AnhSinhVien/Thi-t-K-C-nh-Tay-robot-h-n-RRR/3D_slw/khau0/tsiny-gear-box-motor-1.snapshot.4/motor-preview.JPG

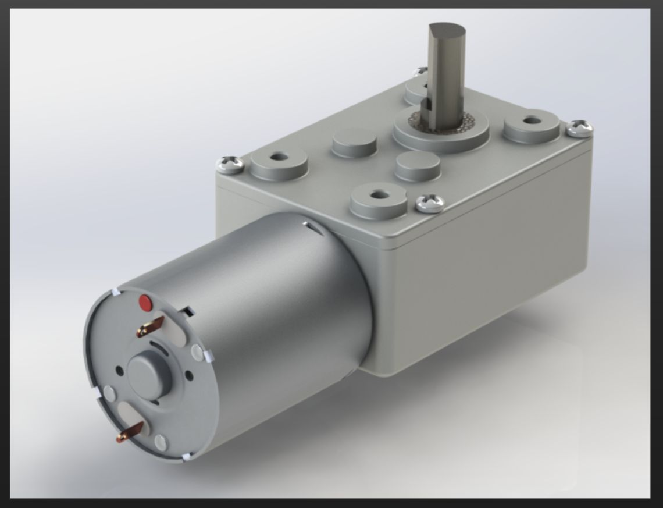
3D_slw/khau0/tsiny-gear-box-motor-1.snapshot.4/motor-preview.JPG
