AnhSinhVien/Thi-t-K-C-nh-Tay-robot-h-n-RRR/word/in_ff/word/Thuyetminh_Word.pdf

TRƯỜNG ĐẠI HỌC THỦY LỢI

### KHOA CƠ KHÍ

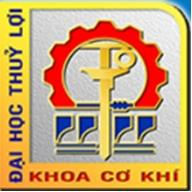
[picture p2: figure]

## ĐỒ ÁN

## HỆ THỐNG CƠ ĐIỆN TỬ

## Đề bài: Tính toán thiết kế robot hàn 3 bậc tự do

## RRR

Giáo viên hướng dẫn: Th.S Nguyễn Tiến Thịnh

Sinh viên | : Trần Khoa Điềm
Lớp | : 62CĐT04
MSV | : 2051204304

Hà Nội, năm 2024

TRƯỜNG ĐẠI HỌC THỦY LỢI

Khoa Cơ khí
Bộ môn: Kỹ thuật cơ điện tử

Học kỳ: 1
Giai đoạn: 1
Năm học: 2023-2024

ĐỀ BÀI TIỂU LUẬN: ĐỒ ÁN HỆ THỐNG CƠ ĐIỆN TỬ

Ngày…../…../ |
Trưởng bộ môn
(Ký, ghi rõ họ tên)

TS. Nguyễn Huy Thế

Người ra đề
(Ký, ghi rõ họ tên)

Th.S Nguyễn Tiến Thịnh

Mã đề:

Nhóm: |
Lớp: |

Sinh viên nhận đề:
Trần Khoa Điềm

Chữ ký:

Tên đề tài: TÍNH TOÁN THIẾT KẾ ROBOT HÀN - RRR

Yêu cầu:

✓ Mối hàn có dạng đường: Tròn
✓ Không gian vùng làm việc 500m×500m×500m ✓ Dạng robot: RRR
✓ Quỹ đạo làm việc: xE = 250 + 90.cos(t/750);
yE = 150 + 90.sin(t/750);

zE = 0;
✓ Quỹ luật biến khớp (sử dụng trong bài toán động học thuận): q1 = 0,8.cos(0,1t);

q2 = 0,5.cos(0,05t);

q3= 0,5.cos(0,05t);
✓ Yêu cầu vật liệu cho robot: Alloy Steel (SS)
✓ Yêu cầu về hệ thống dẫn động (Khâu 1): sử dụng hộp giảm tốc

Nội dung:

1. Phân tích lựa chọn cấu trúc
1.1Số bậc tự do cần thiết
1.2Phân tích một số cấu trúc thỏa mãn và lựa chọn phương án thiết kế
2. Bài toán động học
2.1Chọn một quỹ đạo mối hàn tùy ý
2.2Tính toán vận tốc, vẽ quỹ đạo chuyển động điểm thao tác

2.3Xác định quy luật chuyển động của các khâu
3. Thiết kế 3D
3.1Tạo bản vẽ lắp tổng thể của robot
3.2Tạo bản vẽ chi tiết một số khâu của robot 3.3Mô phỏng lắp ráp và chuyển động của robot
4. Bài toán động lực học
4.1Xác định các tham số động lực học
4.2Thiết lập phương trình vi phân chuyển động của robot 4.3Giải bài toán động lực học
5. Thiết kế hệ thống dẫn động
5.1Lựa chọn động cơ
5.2Phân tích lựa chọn hệ thống dẫn động cho khâu dẫn
6. Thiết kế hệ thống điều khiển
6.1Chọn luật điều khiển phù hợp
6.2Mô phỏng trên Matlab

Lời mở đầu

Có thể nói rằng Robot mang tới cho cuộc sống con người một cuộc sống mới,

một cách trải nghiệm cuộc sống và đôi khi còn là người bạn. Những hãng

Robot(RB) từ các nước nổi tiếng trên thế giới từ Đức, Nhật bản, Nga, Mỹ ngày

một khẳng định sự hiện diện của RB là phần không thiếu trong cuộc sống hiện

nay và tương lai của phía trước. Nó xuất hiện ở tất cả các lĩnh vực từ khoa học vĩ

mô cho tới vi mô và ngày một đa dạng.
Trong khuôn khổ môn học Tính toán thiết kế Robot với đề tài tài thiết kế

Robot hàn đường cong trên mặt phẳng với kích thước cho trước, nhóm tin tưởng

rằng với những kết quả có được từ việc tìm hiểu và tính toán trong bài tiểu luận

này sẽ là bước đệm quan trọng cho việc phát triển nhiều hơn nữa những ý tưởng

trong tương lai về tính toán và thiết kế các loại Robot công nghiệp.

Với bố cục gồm hai phần chính :

### 1. Tổng quan về Robot

Phần này sẽ là cái nhìn sơ qua về Robot bao gồm lịch sử phát triển, phân loại

và ứngdụng hiện nay giúp chúng ta hình dung tính quan trọng cũng như sự hữu dụng của nó tới cuộc sống.

### 2. Tính toán thiết kế Robot hàn

Bao gồm các bước thiết kế cho đến việc mô phỏng để kiểm chứng tính đúng

đắn của quá trình thiết kế sẽ cung cấp các quá trình cơ bản để có thể xác định cách

có thể một sản phẩm Robot được đưa vào ứng dụng trong cuộc sống.

Em xin gửi lời cảm ơn tới Th.S Nguyễn Tiến Thịnh, cảm ơn Thầy vì những đóng

góp qua những bài giảng và những hướng dẫn trong quá trình trao đổi ở các buổi

học. Những góp ý, sửa chữa của thầy sẽ phần nào giúp em tự tin hơn trong cách

thức tiếp cận với nền công nghiệp hiện nay bởi mặc dù đã có những sự chuẩn bị

của em hoặc cũng có thể kiến thức em mang đến trong bài tiểu luận này con sai

sót và chưa đúng. Em rất mong có được sự bổ sung, sửa chữa đó, em chân thành

cảm ơn và chúc Thầy sức khoẻ!

### LỜI CAM ĐOAN

Em xin cam đoan rằng Đồ án hệ thống cơ điện tử với đề tài “ Thiết kế Robot Hàn

kiểu R-R-R” là nghiên cứu độc lập của em với sự hỗ trợ từ giảng viên hướng dẫn

Ths.Nguyễn Tiến Thịnh.

Em xin cam đoan toàn bộ số liệu là kết quả nghiên cứu,tính toán hoàn toàn trung

thực, không sao chép từ bất kì một công trình nghiên cứu khác nào. Những tài liệu

trích dẫn đều đã được ghi rõ nguồn gốc.

Em xin chịu hoàn toàn trách nhiệm nếu có bất kỳ sự sao chép, gian dối kết quả

này trong bản báo cáo đồ án này.

### LỜI CẢM ƠN

Em xin gửi lời cảm ơn tới GV Nguyễn Tiến Thịnh và thầy cô trong bộ môn Cơ

điện tử, cảm ơn thầy cô vì những đóng góp qua những bài giảng và những hướng

dẫn trong quá trình trao đổi ở các buổi học. Những góp ý, sửa chữa của thầy cô sẽ

phần nào giúp em tự tin hơn trong cách thức tiếp cận với nền công nghiệp hiện

nay bởi mặc dù đã có những sự chuẩn bị của em hoặc cũng có thể kiến thức em

mang đến trong bài tiểu luận này còn sai sót và chưa đúng. Em rất mong có được

sự bổ sung, sửa chữa đó, chúng em chân thành

cảm ơn và chúc thầy sức khoẻ!

MỤC LỤC

DANH MỤC HÌNH ẢNH

Hình 5.1: Động Cơ DC Giảm Tốc 5840-31ZY High Torque Self-Lock DC Geared Motor.....57

1

CHƯƠNG 1: TỔNG QUÁT VỀ ROBOT

### 1.1. Lịch sử hình thành và phát triển Robot

Thuật ngữ “Robot” xuất phát từ tiếng CH Séc (Czech) “Robota” có nghĩa là công

việc tạp dịch trong vở kịch Rossum’s Universal Robots của Karel Capek, vào năm 1921. Trong vở kịch nầy, Rossum và con trai của ông ta đã chế tạo ra những chiếc

máy gần giống với con người để phục vụ con người. Có lẽ đó là một gợi ý ban

đầu cho các nhà sáng chế kỹ thuật về những cơ cấu, máy móc bắt chước các hoạt

động cơ bắp của con người.

Đầu thập kỷ 60, công ty Mỹ AMF (American Machine and Foundry Company)

quảng cáo một loại máy tự động vạn năng và gọi là “Người máy công nghiệp”

(Industrial Robot). Ngày nay người ta đặt tên người máy công nghiệp (hay robot công nghiệp) cho những loại thiết bị có dáng dấp và một vài chức năng như tay

người được điều khiển tự động để thực hiện một số thao tác sản xuất.

Về mặt kỹ thuật, những robot công nghiệp ngày nay, có nguồn gốc từ hai lĩnh vực

kỹ thuật ra đời sớm hơn đó là các cơ cấu điều khiển từ xa (Teleoperators) và các

máy công cụ điều khiển số (NC - Numerically Controlled machine tool).

Các cơ cấu điều khiển từ xa (hay các thiết bị kiểu chủ-tớ) đã phát triển mạnh trong

chiến tranh thế giới lần thứ hai nhằm nghiên cứu các vật liệu phóng xạ. Người

thao tác được tách biệt khỏi khu vực phóng xạ bởi một bức tường có một hoặc vài cửa quan sát để có thể nhìn thấy được công việc bên trong. Các cơ cấu điều khiển

từ xa thay thế cho cánh tay của người thao tác; nó gồm có một bộ kẹp ở bên trong

(tớ) và hai tay cầm ở bên ngoài (chủ). Cả hai, tay cầm và bộ kẹp, được nối với

nhau bằng một cơ cấu sáu bậc tự do để tạo ra các vị trí và hướng tuỳ ý của Tay

cầm và bộ kẹp. Cơ cấu dùng để điều khiển bộ kẹp theo chuyển động của tay cầm.

2

Vào khoảng năm 1949, các máy công cụ điều khiển số ra đời, nhằm đáp ứng yêu

cầu gia công các chi tiết trong ngành chế tạo máy bay. Những robot đầu tiên thực

chất là sự nối kết giữa các khâu cơ khí của cơ cấu điều khiển từ xa với khả năng

lập trình của máy công cụ điều khiển số.

Dưới đây chúng ta sẽ điểm qua một số thời điểm lịch sử phát triển của người máy

công nghiệp. Một trong những robot công nghiệp đầu tiên được chế tạo là robot

Versatran của công ty AMF, Mỹ. Cũng vào khoảng thời gian nầy ở Mỹ xuất hiện

loại robot Unimate ư1900 được dùng đầu tiên trong kỹ nghệ ôtô.

Tiếp theo Mỹ, các nước khác bắt đầu sản xuất robot công nghiệp: Anh 1967, Thụy

Điển và Nhật 1968 theo bản quyền của Mỹ; CHLB Đức -1971; Pháp - 1972; ở Ý

- 1973. . .

Tính năng làm việc của robot ngày càng được nâng cao, nhất là khả năng nhận

biết và xử lý. Năm 1967 ở trường Đại học tổng hợp Stanford (Mỹ) đã chế tạo ra

mẫu robot hoạt động theo mô hình “mắt-tay”, có khả năng nhận biết và định

hướng bàn kẹp theo vị trí vật kẹp nhờ các cảm biến. Năm 1974 Công ty Mỹ

Cincinnati đưa ra loại robot được điều khiển bằng máy vi tính, gọi là robot T3

(The Tomorrow Tool: Công cụ của tương lai). Robot nầy có thể nâng được vật có

khối lượng đến 40 KG.

Có thể nói, Robot là sự tổ hợp khả năng hoạt động linh hoạt của các cơ cấu điều

khiển từ xa với mức độ “tri thức” ngày càng phong phú của hệ thống điều khiển

theo chương trình số cũng như kỹ thuật chế tạo các bộ cảm biến, công nghệ lập

trình và các phát triển của trí khôn nhân tạo, hệ chuyên gia…

Trong những năm sau nầy, việc nâng cao tính năng hoạt động của robot không

ngừng phát triển. Các robot được trang bị thêm các loại cảm biến khác nhau để

nhận biết môi trường chung quanh, cùng với những thành tựu to lớn trong lĩnh

vực Tin học - Điện tử đã tạo ra các thế hệ robot với nhiều tính năng đăc biệt, số

3

lượng robot ngày càng gia tăng, giá thành ngày càng giảm. Nhờ vậy, robot công nghiệp đã có vị trí quan trọng trong các dây chuyền sản xuất hiện đại.

Một vài số liệu về số lượng robot được sản xuất ở một vài nước công nghiệp phát

triển như sau:

Nước SX | Năm 1990 | Năm 1994 | Năm 1998
Nhật | 66118 | 29756 | 67000
Mỹ | 4237 | 7634 | 11000
Đức | 5845 | 5125 | 8600
Ý | 2500 | 2408 | 4000
Pháp | 1448 | 1197 | 2000
Anh | 510 | 1086 | 1500
Hàn Quốc | 1000 | 1200

Mỹ là nước đầu tiên phát minh ra Robot nhưng nước phát triển cao nhất trong lĩnh

vực nghiên cứu chế tạo sử dụng lại là Nhật Bản.

### 1.2. Một số định nghĩa và phân loại Robot công nghiệp

### 1.2.1. Định nghĩa Robot công nghiệp

Định nghĩa theo tiêu chuẩn AFNOR (Pháp): Robot công nghiệp là một cơ cấu

chuyển động tự động có thể lập trình, lặp lại các chương trình, tổng hợp các

chương trình đặt ra trên các trục toạ độ; có khả năng định vị, định hướng, di chuyển các đối tượng vật chất: chi tiết, dao cụ, gá lắp . . . theo những hành trình

thay đổi đã chương trình hoá nhằm thực hiện các nhiệm vụ công nghệ khác nhau.

Định nghĩa theo RIA (Robot institute of America): Robot là một tay máy vạn năng có thể lặp lại các chương trình được thiết kế để di chuyển vật liệu, chi tiết, dụng

4

cụ hoặc các thiết bị chuyên dùng thông qua các chương trình chuyển động có thể

thay đổi để hoàn thành các nhiệm vụ khác nhau.

Định nghĩa theo GOCT 25686-85 (Nga):Robot công nghiệp là một máy tự động, được đặt cố định hoặc di động được, liên kết giữa một tay máy và một hệ thống

điều khiển theo chương trình, có thể lập trình lại để hoàn thành các chức năng vận

động và điều khiển trong quá trình sản xuất.

Có thể nói Robot công nghiệp là một máy tự động linh hoạt thay thế từng phần

hoặc toàn bộ các hoạt động cơ bắp và hoạt động trí tuệ của con người trong nhiều

khả năng thích nghi khác nhau.

Robot công nghiệp có khả năng chương trình hoá linh hoạt trên nhiều trục chuyển

động, biểu thị cho số bậc tự do của chúng. Robot công nghiệp được trang bị những

bàn tay máy hoặc các cơ cấu chấp hành, giải quyết những nhiệm vụ xác định trong

các quá trình công nghệ : hoặc trực tiếp tham gia thực hiện các nguyên công (sơn,

hàn, phun phủ, rót kim loại vào khuôn đúc, lắp ráp máy . . .) hoặc phục vụ các quá

trình công nghệ (tháo lắp chi tiết gia công, dao cụ, đồ gá . . .) với những thao tác

cầm nắm, vận chuyển và trao đổi các đối tượng với các trạm công nghệ, trong một

hệ thống máy tự động linh hoạt, được gọi là “Hệ thống tự động linh hoạt robot

hoá” cho phép thích ứng nhanh và thao tác đơn giản khi nhiệm vụ sản xuất thay

đổi.

### 1.2.2. Các thành phần chính của Robot công nghiệp

Một robot công nghiệp thường bao gồm các thành phần chính như : cánh tay robot,

nguồn động lực, dụng cụ gắn lên khâu chấp hành cuối, các cảm biến, bộ điều

khiển, thiết bị dạy học, máy tính ... các phần mềm lập trình cũng nên được coi là

một thành phần của hệ thống robot.

Cánh tay robot (tay máy) là kết cấu cơ khí gồm các khâu liên kết với nhau bằng

các khớp động để có thể tạo nên những chuyển động cơ bản của robot.

5

Nguồn động lực là các động cơ điện (một chiều hoặc động cơ bước), các hệ thống

xy lanh khí nén, thuỷ lực để tạo động lực cho tay máy hoạt động.

Dụng cụ thao tác được gắn trên khâu cuối của robot, dụng cụ của robot có thể có

nhiều kiểu khác nhau như: dạng bàn tay để nắm bắt đối tượng hoặc các công cụ

làm việc như mỏ hàn, đá mài, đầu phun sơn...

Thiết bị dạy-hoc (Teach-Pendant) dùng để dạy cho robot các thao tác cần thiết

theo yêu cầu của quá trình làm việc, sau đó robot tự lặp lại các động tác đã được

dạy để làm việc (phương pháp lập trình kiểu dạy học).

Các phần mềm để lập trình và các chương trình điều khiển robot được cài đặt trên

máy tính, dùng điều khiển robot thông qua bộ điều khiển (Controller). Bộ điều

khiển còn được gọi là Mođun điều khiển (hay Unit, Driver), nó thường được kết

nối với máy tính. Một mođun điều khiển có thể còn có các cổng Vào - Ra (I/O

port) để làm việc với nhiều thiết bị khác nhau như các cảm biến giúp robot nhận

biết trạng thái của bản thân, xác định vị trí của đối tượng làm việc hoặc các dò tìm

khác; điều khiển các băng tải hoặc cơ cấu cấp phôi hoạt động phối hợp với robot...

### 1.2.3. Kết cấu của tay máy

Như đã nói trên, tay máy là thành phần quan trọng, nó quyết định khả năng làm

việc của robot. Các kết cấu của nhiều tay máy được phỏng theo cấu tạo và chức

năng của tay người; tuy nhiên ngày nay, tay máy được thiết kế rất đa dạng, nhiều

cánh tay robot có hình dáng rất khác xa cánh tay người. Trong thiết kế và sử dụng

tay máy, chúng ta cần quan tâm đến các thông số hình - động học, là những thông

số liên quan đến khả năng làm việc của robot như: tầm với (hay trường công tác),

số bậc tự do (thể hiện sự khéo léo linh hoạt của robot), độ cứng vững, tải trọng

vật nâng, lực kẹp . . .

Các khâu của robot thường thực hiện hai chuyển động cơ bản:

6

- Chuyển động tịnh tiến theo hướng x, y, z trong không gian.
- Chuyển động xoay theo các trục x, y, z trong không gian.

### 1.2.4. Phân loại Robot công nghiệp

Robot công nghiệp rất phong phú đa dạng, có thể được phân loại theo các cách

sau:

### 1.2.4.1. Phân loại theo kết cấu

Theo kết cấu của tay máy người ta phân thành robot kiểu toạ độ Đề các, Kiểu toạ

độ trụ, kiểu toạ độ cầu, kiểu toạ độ góc, robot kiểu SCARA như đã trình bày ở

trên.

### 1.2.4.2. Phân loại theo hệ thống truyền động

Có các dạng truyền động phổ biến là:

- Hệ truyền động điện: Thường dùng các động cơ điện 1 chiều (DC: Direct

Current) hoặc các động cơ bước (step motor). Loại truyền động nầy dễ điều khiển,

kết cấu gọn.

- Hệ truyền động thuỷ lực: có thể đạt được công suất cao, đáp ứng những điều

kiện làm việc nặng. Tuy nhiên hệ thống thuỷ lực thường có kết cấu cồng kềnh,

tồn tại độ phi tuyến lớn khó xử lý khi điều khiển.

- Hệ truyền động khí nén: có kết cấu gọn nhẹ hơn do không cần dẫn ngược nhưng

lại phải gắn liền với trung tâm tạo ra khí nén. Hệ nầy làm việc với công suất trung

bình và nhỏ, kém chính xác, thường chỉ thích hợp với các robot hoạt động theo chương trình định sẳn với các thao tác đơn giản “nhấc lên - đặt xuống” (Pick and

Place or PTP: Point To Point).

### 1.2.4.3. Phân loại theo ứng dụng

7

Dựa vào ứng dụng của robot trong sản xuất có Robot sơn, robot hàn, robot lắp

ráp, robot chuyển phôi .v.v...

### 1.2.4.4. Phân loại theo cách thức và đặc trưng của phương pháp điều khiển

Robot điều khiển kín (hay điều khiển servo): sử dụng cảm biến, mạch phản hồi để

tăng độ chính xác và mức độ linh hoạt khi điều khiển.

### 1.3. Robot Hàn mục đích ra đời và ứng dụng

Trên toàn thế giới hiện nay, sự phát triển và ứng dụng của robot hàn đang trở

thành một xu hướng quan trọng trong ngành công nghiệp sản xuất và xây dựng.

Robot hàn không chỉ giúp nâng cao chất lượng sản phẩm mà còn tăng cường hiệu

suất làm việc và giảm rủi ro cho người lao động.

Một trong những lợi ích lớn nhất của robot hàn là khả năng làm việc liên tục mà

không mệt mỏi, giúp tăng cường năng suất và giảm thời gian sản xuất. Nhờ vào

công nghệ hiện đại, robot hàn cũng có khả năng hàn các sản phẩm có độ phức tạp

cao, từ các chi tiết nhỏ đến cấu trúc lớn và phức tạp. Điều này giúp nâng cao độ

chính xác và đồng đều của quá trình hàn, đồng thời giảm thiểu sai số và waste.

Sự phổ biến của robot hàn không chỉ giới hạn trong các nhà máy sản xuất, mà còn

mở rộng đến nhiều lĩnh vực khác nhau như xây dựng cầu và tòa nhà, sản xuất ô

tô, đóng tàu, và nhiều ngành công nghiệp khác. Các doanh nghiệp đang nhận ra

rằng việc tích hợp robot hàn vào quy trình sản xuất của họ không chỉ mang lại lợi

ích kinh tế mà còn là bước quan trọng để nâng cao chất lượng sản phẩm và duy

trì sự cạnh tranh trên thị trường toàn cầu.

Tính linh hoạt và dễ điều khiển của robot hàn cũng đang được cải tiến, giúp chúng

dễ dàng thích ứng với các quy trình sản xuất linh hoạt và đa dạng. Điều này đồng

nghĩa với việc ngành công nghiệp có thể áp dụng robot hàn trong các ứng dụng

và môi trường làm việc khác nhau một cách hiệu quả.

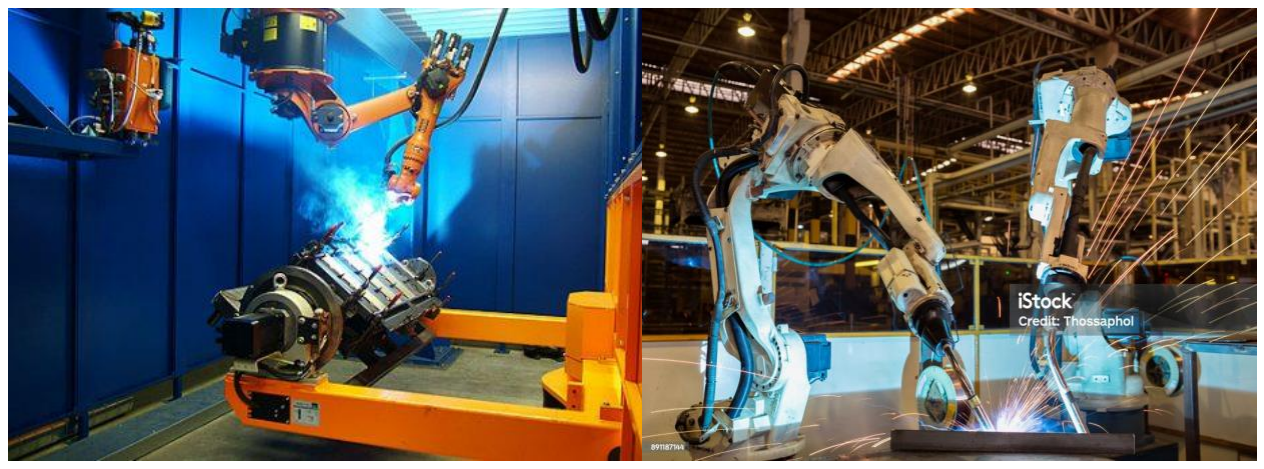
[picture p3: figure]

8

Tóm lại, sự phát triển và ứng dụng ngày càng phổ biến của robot hàn đánh dấu

một bước tiến quan trọng trong ngành công nghiệp, góp phần làm thay đổi cách

chúng ta sản xuất và xây dựng, đồng thời mở ra những triển vọng mới về tương

lai của công nghiệp và sự phát triển bền vững.

Hình 1.1: Một số mẫu robot hàn trong công nghiệp

### 1.4. Lựa chọn phương án thiết kế

### 1.4.1. Nội dung nghiên cơ khí

Phân tích không gian, sơ bộ thao tác làm việc của robot:

+ Không gian làm việc: 500x500x500

+ Sơ bộ hướng thao tác: RRR

Đề bài yêu cầu tính toán thiết kế Robot hàn đảm bảo thực hiện thao tác theo quỹ

đạo là đường trong với 3 bậc tự do cho mô hình thiết kế

- Tính toán, thiết kế robot có kết cấu, hình dạng phù hợp với yêu cầu linh hoạt về

công việc đặt ra;

- Hệ thống cơ khí, truyền động chính xác, gia công phải đảm bảo độ chuẩn theo

yêu cầu kích thước bản vẽ. Đảm bảo cho robot chạy ổn định, đúng yêu cầu kĩ

thuật;

9

- Các khâu đảm bảo không gian làm việc ổn định, tự do, không va chạm, đảm bảo

gắp phôi được ở vị trí mong muốn.

### 1.4.2. Phân tích và lựa chọn cấu trúc robot

### 1.4.2.1. Số bậc tự do cần thiết

Đề bài yêu cầu tính toán thiết kế Robot hàn đảm bảo thực hiện mối hàn có dạng

quỹ đạo đường tròn với không gian hoạt động trong khoảng: 500x500x500 mm và kiểu robot là RRR thì ta sẽ cần ít nhất robot phải có 3 bậc tự do cho mô hình

thiết kế

### 1.4.2.2. Phân tích cấu trúc

Robot kiểu RRR (còn được gọi là robot 3 bậc tự do RRR) là một loại robot công nghiệp

hoặc robot cầm tay có cấu trúc đặc thù với ba bậc tự do (degrees of freedom - DOF)

hoặc ba joint. Mỗi bậc tự do cho phép robot thực hiện một phép xoay hoặc gập cơ bản

ở một gelenk hoặc joint nhất định.

Cấu trúc cơ bản của robot RRR:

- Base: Đây là phần cố định của robot, thường đặt trên bàn làm việc hoặc một nền

tảng cố định khác.

- Bậc tự do thứ nhất (Joint 1 - R1): Đây là khớp đầu tiên của robot, thường là

một khớp xoay hoặc một khớp xoay trục chéo, cho phép robot thực hiện một phép

xoay quanh trục. Góc quay tại khớp này thường được ký hiệu là θ1.

- Bậc tự do thứ hai (Joint 2 - R2): Đây là khớp thứ hai của robot, thường là một

khớp xoay hoặc một khớp xoay trục chéo, cho phép robot thực hiện một phép

xoay quanh trục khác. Góc quay tại khớp này thường được ký hiệu là θ2.

- Bậc tự do thứ ba (Joint 3 - R3): Đây là khớp thứ ba của robot, thường là một

khớp xoay hoặc một khớp xoay trục chéo, cho phép robot thực hiện một phép xoay cuối cùng quanh trục khác nữa. Góc quay tại khớp này thường được ký hiệu

là θ3.

10

- End-Effector (tác nhân cuối cùng): Đây là phần của robot được gắn vào khớp

thứ ba (Joint 3) và thường chứa công cụ hoặc tác nhân được sử dụng để thực hiện

các nhiệm vụ cụ thể. Tại vị trí này ta dùng để lắp công cụ hàn.

- Tay điều khiển: Để điều khiển robot kiểu RRR, người dùng thường sử dụng một

tay điều khiển hoặc giao diện máy tính để cài đặt các góc quay của các joint (θ1,

θ2, θ3) để đưa robot đến vị trí và hướng mong muốn.

Cấu trúc này cho phép robot kiểu RRR di chuyển và thực hiện các tác vụ trong không

gian ba chiều bằng cách điều khiển ba bậc tự do.

Ưu điểm của robot RRR so với các robot khác là:

- Dễ dàng thực hiện với nhiều đối tượng bề mặt
- Xây dựng hệ thống điều khiển các khớp dễ dàng thuận tiện và gần như có

thể độc lập

- Kết cấu đơn giản đảm bảo tính linh hoạt
- Khả năng làm việc trong không gian hạn chế

### 1.4.3. Một số mẫu thiết kế robot trên thị trường

### 1.4.3.1. Robot có khớp nối

11

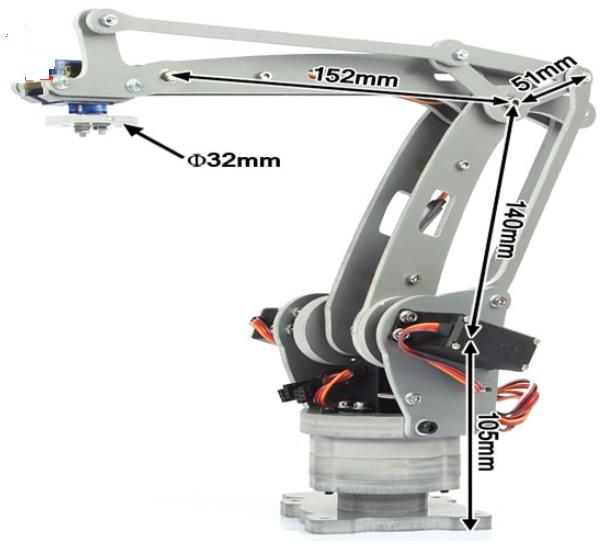
[picture p4: figure]

Hình 1.2: Robot có khớp nối Cánh tay Robot có khớp nối là loại robot vô cùng phổ biến. Và mỗi khi nhắc

đến Robot chúng ta sẽ lập tức nghĩ ngay đến chúng. Giống như các nhà máy CNC,

Robot khớp nối được phân loại theo số điểm quay hoặc số trục mà chúng có. Phổ

biến nhất là robot khớp 3 trục. Ngoài ra còn có các loại robot 6 trục và 7 trục cũng

rất phổ biến trên thị trường.

Tính linh hoạt, khéo léo và khả năng tiếp cận khiến Robot có khớp nối là sự

lựa chọn phù hợp lý tưởng cho các nhiệm vụ thực hiện trên các mặt phẳng không

song song, chẳng hạn như chỉnh sửa máy móc.

Robot có khớp nối cũng có thể dễ dàng tiếp cận khoang máy công cụ và dưới

các vật cản để tiếp cận phôi. Hoặc thậm chí xung quanh vật cản, trong trường hợp

này là robot 7 trục.
Ưu điểm:
- Các khớp nối kín và ống bảo vệ cho phép Robot có khớp nối hoạt động

tốt trong môi trường sạch cũng như môi trường bẩn. Khả năng năng lắp

cánh tay Robot 3 bậc tự do này trên bất kỳ bề mặt nào (ví dụ: trần nhà,

đường ray trượt). Điều này cho phép doanh nghiệp có nhiều sự lựa chọn

khi làm việc.

12

- Tuy nhiên, sự tinh tế và hiện đại của robot có khớp nối này sẽ đi kèm

với giá thành cao. Do đó, robot này cao hơn so với các loại robot có

trọng tải tương tự trên thị trường.
Khuyết điểm:

Và khuyết điểm của dòng Robot này là: Chúng sẽ không phù hợp với các ứng

dụng tốc độ rất cao. Do chúng có hệ thống chuyển động học phức tạp với nhiều

chi tiết bộ phận.

### 1.4.3.2. Robot SCARA

Cánh tay robot khớp nối tuân thủ có chọn lọc (SCARA) là một lựa chọn tốt. Và hiệu

quả về chi phí cho doanh nghiệp.

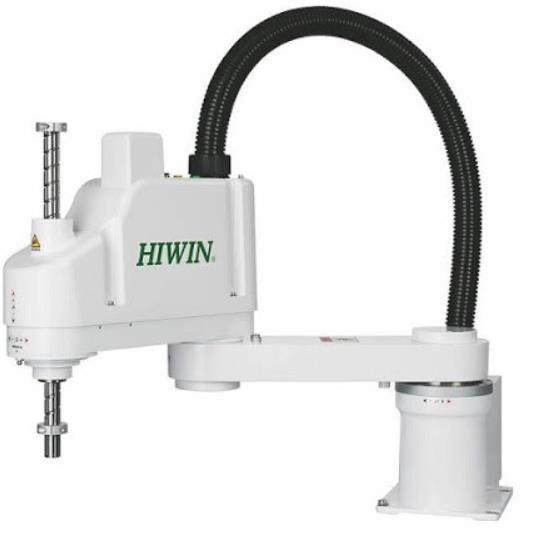
[picture p5: figure]

Hình 1.3: Robot SCARA
Robot SCARA này sẽ phù hợp với việc thực hiện các hoạt động giữa hai mặt phẳng song song (ví dụ: chuyển các bộ phận từ khay sang băng tải). Robot

SCARA có tính vượt trội trong các nhiệm vụ lắp ráp theo chiều dọc như chèn các

chốt mà không cần ràng buộc do độ cứng dọc của chúng.

Robot SCARA có trọng lượng nhẹ và có dấu chân nhỏ. Điều này là sự lựa chọn

lý tưởng cho các công việc mà thực hiện trong không gian đông đúc. Chúng cũng có chu kỳ làm việc rất nhanh.

13

Do thiết kế cánh tay xoay cố định, vốn là một lợi thế trong một số ứng dụng

nhất định. Nhưng Robot SCARA phải đối mặt với những hạn chế khi thực hiện

các nhiệm vụ yêu cầu tiếp cận các vật thể bên trong sản phẩm và làm việc như là:

đồ đạc, đồ gá hoặc máy công cụ trong ô làm việc.

### 1.4.3.3. Robot Delta

Robot Delta, còn được gọi là “robot nhện”. Robot này sử dụng ba động cơ gắn

trên đế để kích hoạt các cánh tay điều khiển định vị cổ tay. Robot delta cơ bản là

các đơn vị 3 trục. Nhưng các mô hình 4 trục và 6 trục của nó cũng phổ biến không

kém.

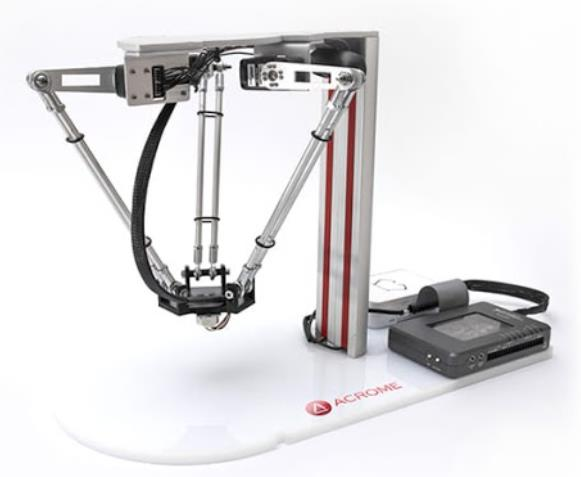
[picture p6: figure]

Hình 1.4: Robot Delta
Bằng cách gắn các thiết bị truyền động vào hoặc rất gần đế cố định thay vì ở

mỗi khớp (như trong trường hợp Robot có khớp nối). Cánh tay của rô bốt delta có

thể rất nhẹ. Điều này cho phép di chuyển nhanh chóng. Và làm cho Robot delta

trở thành Robot lý tưởng các hoạt động yêu cầu tốc độ rất cao.

Một điều quan trọng cần lưu ý khi bạn so sánh Robot Delta với các loại rô bốt

khác:
Phạm vi tiếp cận đối với Robot Delta thường được xác định bằng đường kính

của phạm vi làm việc. Trái ngược với bán kính từ chân đế, như trong trường hợp

đơn vị SCARA và khớp nối. Ví dụ: một Robot Delta có phạm vi tiếp cận 40” sẽ

14

chỉ bằng một nửa phạm vi tiếp cận (20” trên bán kính) của đơn vị SCARA hoặc

có khớp nối 40 ”.

Ngoài ra, em còn tìm hiểu một số dạng cơ cấu robot dưới đây:

- Phương án 1:

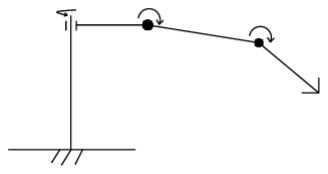
[picture p7: figure]

Hình 1.5: Dạng cơ cấu robot thứ 1

Phương án này có 3 bậc tự do, trong đó khâu 1, khâu 2 và khâu 3 chuyển

động quay. Phương án này đã thỏa mãn với yêu cầu nhưng các khâu của robot sẽ

không được chắc khỏe do khớp 1 phải chịu lực lớn

- Phương án 2:

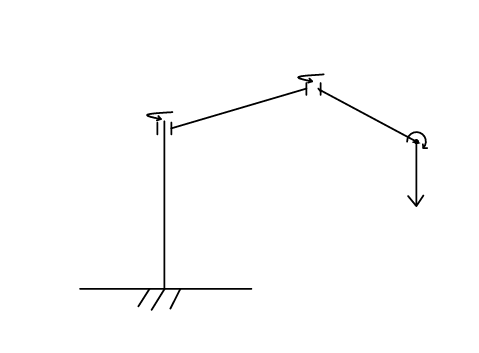
[picture p8: figure]

Hình 1.6: Dạng cơ cấu robot thứ 2

15

Phương án này có 3 bậc tự do, trong đó khâu 1, khâu 2 và khâu 3 chuyển

động quay. Phương án này đã thỏa mãn với yêu cầu nhưng bị hạn chế giống

phương án 1

- Phương án 3:

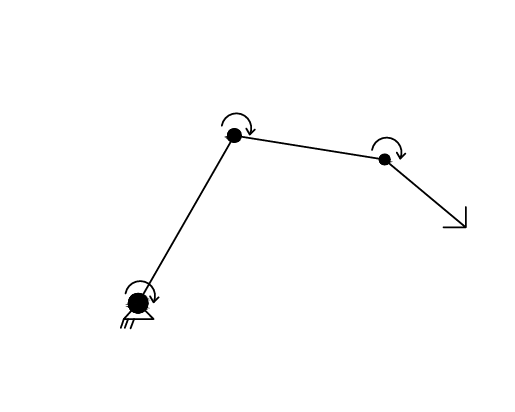
[picture p9: figure]

Hình 1.7: Dạng cơ cấu robot thứ 3

Phương án này có 3 bậc tự do, trong đó khâu 1, khâu 2 và khâu 3 chuyển

động quay. Phương án này bị hạn chế không gian làm việc.

- Phương án 4:

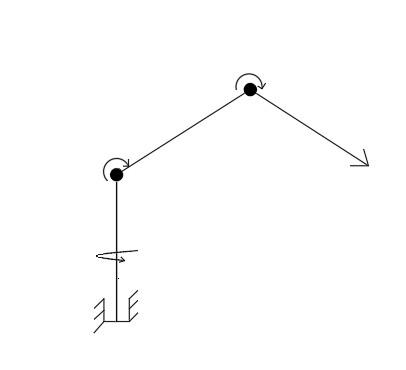
[picture p10: figure]

Hình 1.8: Dạng cơ cấu robot thứ 4

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

động quay. Phương án này đã thỏa mãn yêu cầu chế tạo đơn giản hơn các phương

án trên

16

Dựa vào những đặc điểm của 3 loại robot thông dụng trên nói chung và của loại

robot khớp nối 3 bậc tự do nói riêng, yêu cầu về kỹ thuật của đề bài được giao và

giá thành phù hợp với sinh viên, em lựa chọn sử dụng dạng robot theo phương án số 4

### 1.4.4. Phương án thiết kế robot

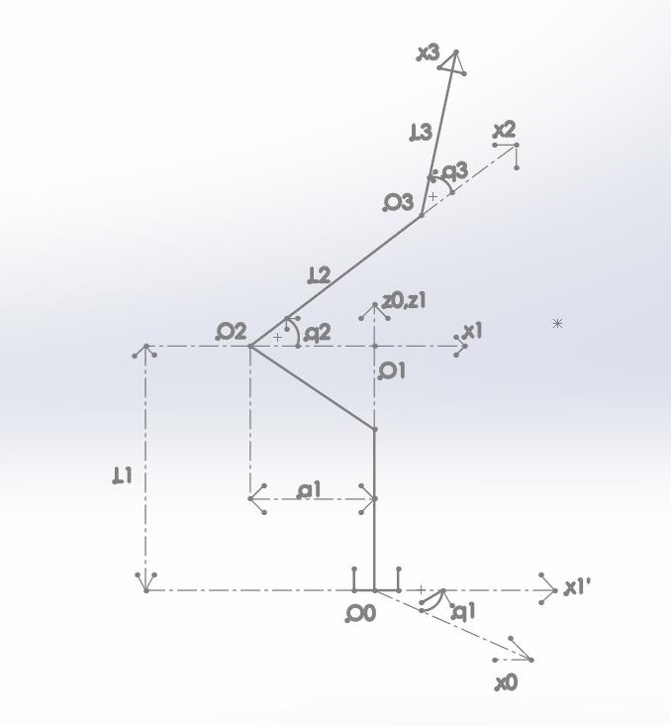
[picture p11: figure]

Hình 1.9: Cấu trúc và thiết lập hệ tọa độ gắn lên robot

Hệ trục: | X0Y0Z0 ∶ là hệ trục ban đầu
| X1Y1Z1 ∶ là hệ trục của khâu 1 theo q1
| X2Y2Z2 ∶ là hệ trục của khâu 2 theo q2
| X3Y3Z3 ∶ là hệ trục của khâu 3 theo q3

17

CHƯƠNG 2: BÀI TOÁN ĐỘNG HỌC ROBOT

Với không gian làm việc là 500x500x500(mm) . Chọn:
- l1= 250 mm = 0,25 m
- l2 = 194 mm = 0,194 m
- l3 = 265 mm = 0,265 m
- a1 = 30 mm = 0,03 m

### 2.1. CƠ SỞ LÝ THUYẾT

### 2.1.1. Bậc tự do của Robot

Bậc tự do là số khả năng chuyển động của một cơ cấu (chuyển động quay hoặc

tịnh tiến). Để dịch chuyển được một vật thể trong không gian, cơ cấu chấp hành

của robot phải đạt được một số bậc tự do. Nói chung cơ hệ của robot là một cơ

cấu hở, do đó bậc tự do của nó có thể tính theo công thức:

w = 6n − ∑ ipi

5
i=1 | = 6.3 – 5.3 = 3 (bậc tự do) | (2.1)

Ở đây:

n - Số khâu động;

pi - Số khớp loại i (i = 1, 2,...,5 : Số bậc tự do bị hạn chế). Đối với các cơ cấu có

các khâu được nối với nhau bằng khớp quay hoặc tịnh tiến (khớp động loại 5) thì

số bậc tự do bằng với số khâu động... Đối với cơ cấu hở, số bậc tự do bằng tổng

số bậc tự do của các khớp động.

Để định vị và định hướng khâu chấp hành cuối một cách tuỳ ý trong không gian

3 chiều robot cần có 6 bậc tự do, trong đó 3 bậc tự do để định vị và 3 bậc tự do để

định hướng. Một số công việc đơn giản nâng hạ, sắp xếp... có thể yêu cầu số bậc

tự do ít hơn. Các robot hàn, sơn... thường yêu cầu 6 bậc tự do. Trong một số trường

hợp cần sự khéo léo, linh hoạt hoặc khi cần phải tối ưu hoá quỹ đạo... người ta

dùng robot với số bậc tự do lớn hơn 6.

18

### 2.1.2. Hệ tọa độ (Coordinate frames)

Mỗi robot thường bao gồm nhiều khâu (links) liên kết với nhau qua các khớp

(joints), tạo thành một xích động học xuất phát từ một khâu cơ bản (base) đứng

yên. Hệ toạ độ gắn với khâu cơ bản gọi là hệ toạ độ cơ bản (hay hệ toạ độ chuẩn).

Các hệ toạ độ trung gian khác gắn với các khâu động gọi là hệ toạ độ suy rộng.

Trong từng thời điểm hoạt động, các toạ độ suy rộng xác định cấu hình của robot

bằng các chuyển dịch dài hoặc các chuyển dịch góc của các khớp tịnh tiến hoặc

khớp quay. Các toạ độ suy rộng còn được gọi là biến khớp.

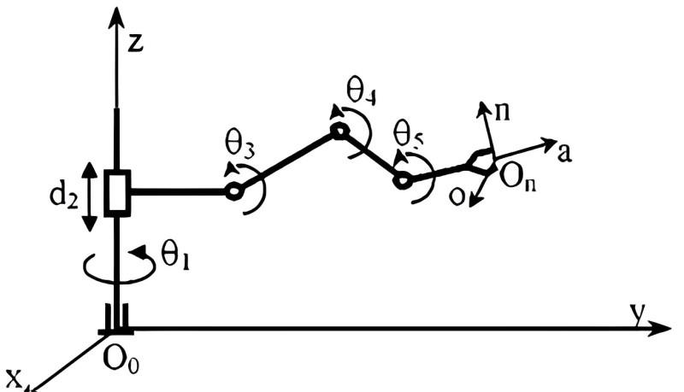
[picture p12: figure]

Hinh 2.1: Hệ tọa độ suy rộng của robot

Các hệ toạ độ gắn trên các khâu của robot phải tuân theo qui tắc bàn tay phải:

Dùng tay phải, nắm hai ngón tay út và áp út vào lòng bàn tay, xoè 3 ngón : cái,

trỏ và giữa theo 3 phương vuông góc nhau, nếu chọn ngón cái là phương và chiều

của trục z, thì ngón trỏ chỉ phương, chiều của trục x và ngón giữa sẽ biểu thị

phương, chiều của trục y.

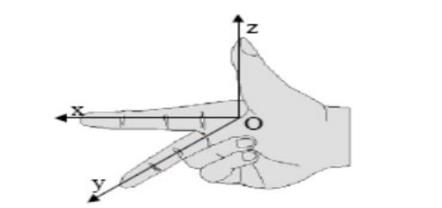
[picture p13: figure]

Hình 2.2: quy tắc bàn tay phải

19

Trong robot ta thường dùng chữ O và chỉ số n để chỉ hệ toạ độ gắn trên khâu thứ

n. Như vậy hệ toạ độ cơ bản (Hệ toạ độ gắn với khâu cố định) sẽ được ký hiệu là

O0; hệ toạ độ gắn trên các khâu trung gian tương ứng sẽ là O1, O2,..., On-1, Hệ

toạ độ gắn trên khâu chấp hành cuối ký hiệu là On.

### 2.1.3. Cách xây dựng hệ tọa độ và cách xác định các tham số trong phương pháp D-

H-C

Cách xây dựng hệ tọa độ D-H-C:

- Trục zi được chọn dọc theo trục của khớp thứ (i).
- Trục xi được xác định theo đường vuông góc chung giữa trục zi và zi+1,

hướng từ zi tới zi+1

- Gốc Oi là giao điểm của xi và zi
- Trục yi được xác định theo quy tắc bàn tay phải.

Các tham số trong pp D-H-C:

Vị trí của hệ tọa độ khớp (Oxyz)i đối với hệ tọa độ khớp (Oxyz)i−1 được xác định

bởi 4 tham số, αi−1 , ai−1 ,θi , di như sau:

- αi−1: Góc quay quanh trục xi sao cho trục z′ i−1 (z′ i−1// zi−1 ) trùng với

trục zi .

- ai−1: Dịch chuyển dọc trục xi để điểm O′ i chuyển đến điểm Oi .
- θi : Góc quay quanh trục zi−1 để trục xi−1 trùng với trục x′ i (xi//x′ i )
- di: Dịch chuyển tịnh tiến dọc trục zi−1 để gốc tọa độ Oi−1 chuyể đến O′ i

là giao điểm của trục xi và trục zi−1

Từ quy tắc trên ta xây dựng các tọa độ khảo sát (Hình 1.5):

- Hệ tọa độ O0x0y0z0:

20

Gốc tọa độ đặt tại tâm của khớp động thứ nhất

Trục O0z0 dọc theo hướng của trục khớp động thứ nhất

Trục O0x0 có phương vuông góc với z0

Trục O0y0 xác định theo quy tắc bàn tay phải

- Hệ tọa độ O1x1y1z1:

Gốc tọa độ đặt tại vị trí như trên hình dọc phương của khâu 1

Trục O1z1 có phương trùng với O0z0 như hình vẽ.

Trục O1x1 có phương nằm trên đường vuông góc chung của trục O1z1 và O2z2.

Trục O1y1 xác định theo quy tắc bàn tay phải.

- Hệ tọa độ O2x2y2z2:

Gốc tọa độ đặt tại tâm của khớp động thứ 2.

Trục O2z2 có phương dọc theo trục khớp động xoay thứ 2 của khớp xoay.

Trục O2x2 có phương nằm trên đường vuông góc chung của trục O2z2 và O3z3 .

Trục O2y2 xác định theo quy tắc bàn tay phải.

- Hệ tọa độ O3x3y3z3:

Gốc tọa độ đặt tại tâm của khớp động thứ 3.

Trục O3z3 có phương dọc theo trục khớp động xoay thứ 3 của khớp xoay.

Trục O3x3 có phương nằm dọc khâu 3.

Trục O3y3 xác định theo quy tắc bàn tay phải.

Cuối cùng ta có hệ tọa độ như sau:

21

Hình 2.3: Dạng robot chọn và cách đặt biến khớp

### 2.2. BÀI TOÁN ĐỘNG HỌC THUẬN ROBOT

### 2.2.1. Bảng tham số động học và tính toán các ma trận truyền Denavit –

Hartenberg – Craig

- Đề bài cho quy luật chuyển động của các khâu:

q1 = 0.8 ∗ cos(0.1t)
q2 = 0.5 ∗ cos(0.05t) (2.2)

q3 = 0.5 ∗ cos(0.05t)

Dựa trên thông số hình 2.2 ta lập bảng tham số động học

22

Khâu | αi−1 | ai-1 | di | θi
1 | 0 | 0 | l1 | q1
2 | π/2 | -a1 | 0 | q2
3 | 0 | l2 | 0 | q3

Trong đó :q1, q2, q3 là các biến khớp ; l1, l2, l3, a1 là chiều dài khâu 1,2,3

Các ma trận Craig địa phương
K1 = [

cos q1 − sin q1 0 0
sin q1 | cos q1 | 0 0
0 | 0 | 1 l1
0 | 0 | 0 1
]; | K2 = [
cos q2 − sin q2 | 0 | −a1
0 | 0 | −1 | 0
sin q2 | cos q2 | 0 | 0
0 | 0 | 0 | 1

]

K3 = [

cos q3 −sin q3 0 l2
sin q3 | cos q3 | 0 0
0 | 0 | 1 0
0 | 0 | 0 1

]

Các ma trận Craig toàn thể:

C2 = K1K2 = [

cos q1 cos q2 − cos q1 sin q2 | sin q1 | −a1. cosq1
sin q1 cos q2 − sin q1 sin q2 − cos q1 −a1. sinq1
sin q2 | cos q2 | 0 | l1
0 | 0 | 0 | 1

]

C3 = K1K2K3 =
[
cos q1 cos( q2 + q3) − cos q1 sin( q2 + q3) | sin q1 | −cosq1(a1 − l2cosq2)
sin q1 cos( q2 + q3) − sin q1 sin( q2 + q3) − cos q1 −sinq1(a1 − l2cosq2)
sin( q2 + q3) | cos( q2 + q3) | 0 | l1 + l2sinq2
0 | 0 | 0 | 1

]

### 2.2.2. Tính tọa độ điểm thao tác

Từ các ma trận Craig, ta tính tọa độ điểm thao tác E trong hệ quy chiếu cố định:

uE

(3) = [l3 0 0 1]
T

Tọa độ vị trí điểm thao tác E:

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
= C3. [

l3
0

0/1] = [

l3 cos q1 cos( q2 + q3) − cos q1(a1 − l2cos q2) l3 sin q1 cos( q2 + q3) − sin q1 (a1 − l2cos q2) l1 + l2sinq2 + l3 sin( q2 + q3) 1

]

⇒ {
xE

0 = l3 cos q1 cos( q2 + q3) − cos q1(a1 − l2cos q2) yE

0 = l3 sin q1 cos( q2 + q3) − sin q1 (a1 − l2cos q2) zE

0 = l1 + l2sinq2 + l3 sin( q2 + q3)

(2.3)

*Vẽ đồ thị quỹ đạo:

- Thay q1, q2, q3 từ (2.2) vào toạ độ điểm E theo biến t:

xE

0 = l3*cos(cos(0.05*t)) *cos(0.8*cos(0.1*t)) - cos(0.8*cos(0.1*t))*(a1 -l2*cos(0.5*cos(0.05*t)))

yE

0 = l3*cos(cos(0.05*t)).sin(0.8*cos(0.1*t)) - sin(0.8*cos(0.1*t)) * (a1 -l2*cos(0.5*cos(0.05*t)))

zE

0 = l1 + l3*sin(cos(0.05*t)) + l2*sin(0.5*cos(0.05*t))

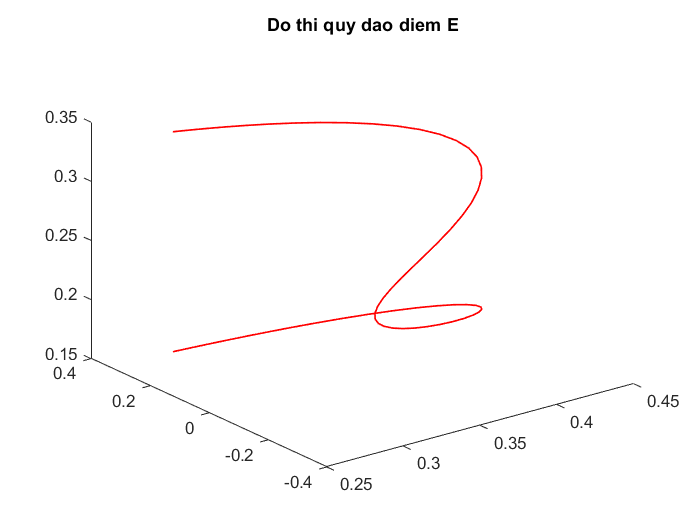
[picture p14: figure]

Hình 2.4: Đồ thị quỹ đạo của điểm E trong 1 chu kì

24

### 2.2.3. Vận tốc điểm tác động cuối E và vận tốc góc của các khâu

### 2.2.3.1. Vận tốc của điểm tác động cuối E

Đạo hàm theo thời gian t toạ độ điểm E trong hệ quy chiếu cố định ta được vận

tốc điểm thao tác E

vE = [ẋE ẏ
E

żE]

T

Thay q1, q2, q3 từ (2.2) vào ta có:

VEx = 0.2e-1*l2*sin(0.5*cos(0.5e-1*t))*sin(0.5e-1*t)*cos(0.8*cos(0.1*t)) -0.8e-1*sin(0.8*cos(0.1*t))*sin(0.1*t)*(a1-l2*cos(0.5*cos(0.5e-1*t)))+ 0.8e-1*l3*sin(0.8*cos(0.1*t))*sin(0.1*t)*cos(cos(0.5e-1*t))+0.5e-1*l3*sin(0.5e-1*t)*sin(cos(0.5e-1*t))*cos(0.8*cos(0.1*t))

VEy = 0.8e-1*sin(0.1*t)*cos(0.8*cos(0.1*t))*(a1-l2*cos(0.5*cos(0.5e-1*t)))+0.2e-1*l2*sin(0.8*cos(0.1*t))*sin(0.5*cos(0.5e-1*t))*sin(0.5e-1*t)-0.8e-1*l3*sin(0.1*t)*cos(cos(0.5e-1*t))*cos(0.8*cos(0.1*t))+0.5e-1*l3*sin(0.8*cos(0.1*t))*sin(0.5e-1*t)*sin(cos(0.5e-1*t))

VEz = -0.2e-1*l2*sin(0.5e-1*t)*cos(0.5*cos(0.5e-1*t))-0.5e-1*l3*sin(0.5e-1*t)*(2*cos(0.5*cos(0.5e-1*t))^2-1)

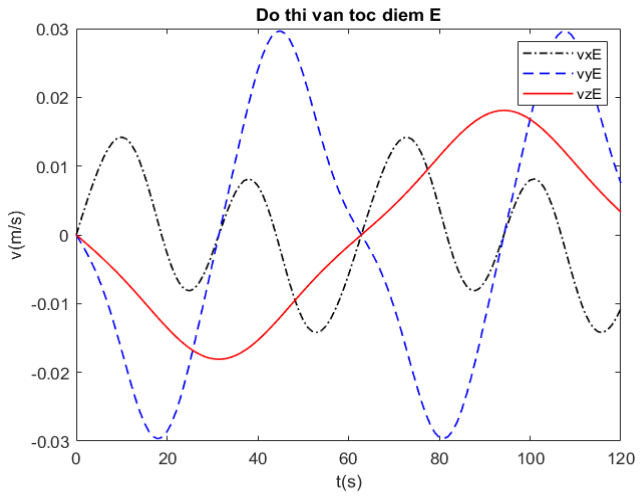
[picture p15: figure]

Hình 2.5: Đồ thị vận tốc của điểm E

25

### 2.2.3.2. Vận tốc góc của các khâu

Tính ma trận sóng của các khâu theo công thức:

ω̃i = Ȧ
iAi

T

Với Ai là ma trận cosin chỉ hướng của khâu thao tác cuối A1, A2, A3

A1 = [

cos q1 − sin q1 0
sin q1 | cos q1 | 0
0 | 0 | 1

]

A2 = [

cos q1 cos q2 − cos q1 sin q2 sin q1 sin q1 cos q2 − sin q1 sin q2 − cos q1
sin q2 | cos q2 | 0

]

A3 = [
cos q1 cos( q2 + q3) − cos q1 sin( q2 + q3) sin q1 sin q1 cos( q2 + q3) − sin q1 sin( q2 + q3) − cos q1
sin( q2 + q3) | cos( q2 + q3) | 0

]

Vận tốc góc các khâu:

ω1

(0) = [

0
0
q̇1

]

ω2

(0) = [

q̇2. sinq1
−q̇2. cosq1
q̇1

]

ω3

(0) = [

(q̇2 + q̇3). sinq1
−(q̇2 + q̇3). cosq1
q̇1

]

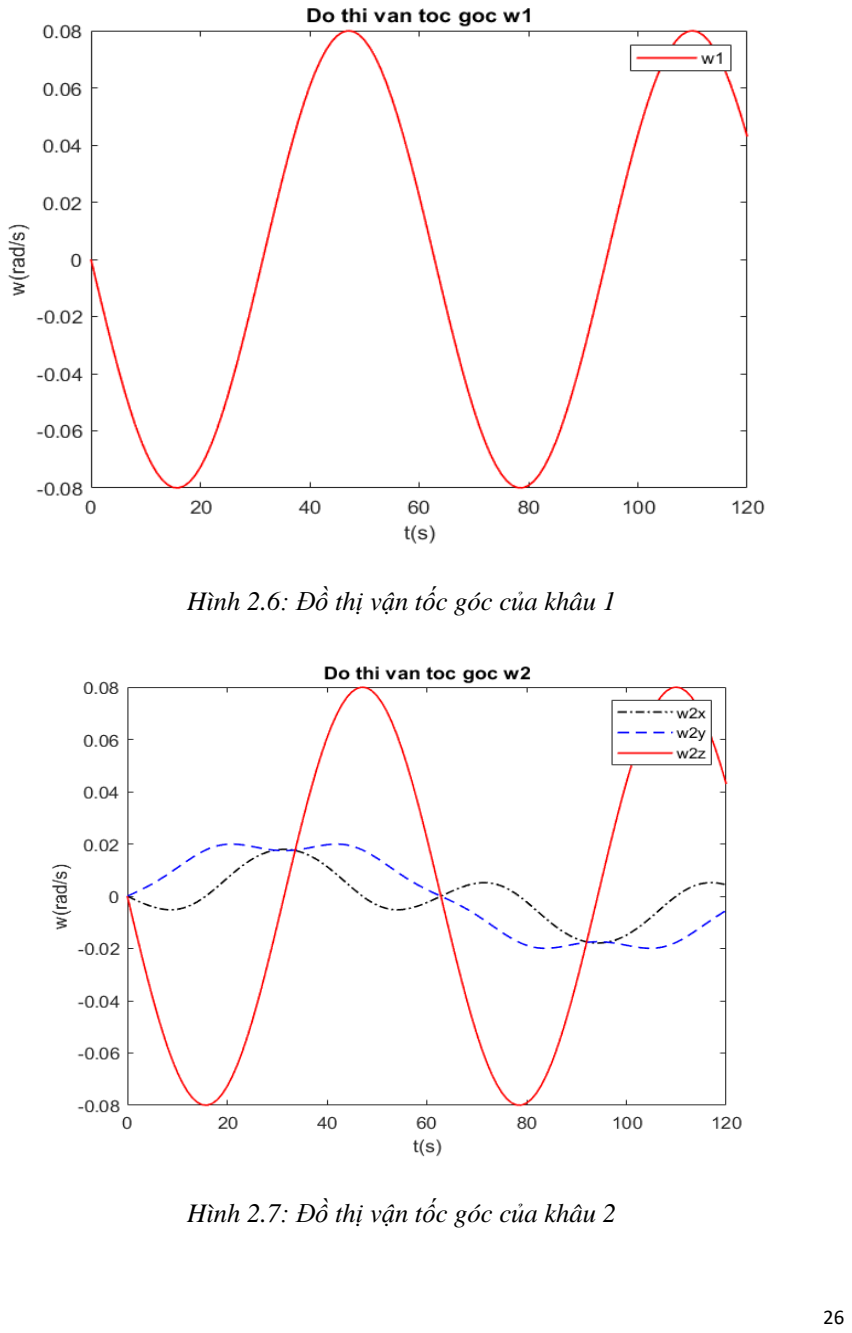
[picture p16: page 34]

26

Hình 2.6: Đồ thị vận tốc góc của khâu 1

Hình 2.7: Đồ thị vận tốc góc của khâu 2

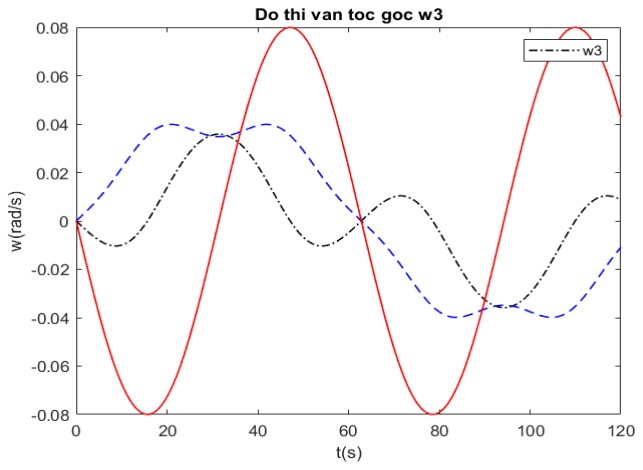
[picture p17: figure]

27

Hình 2.8: Đồ thị vận tốc góc của khâu 3

### 2.2.4. Gia tốc điểm tác động cuối E

Gia tốc của khâu thao tác chính là đạo hàm vận tốc khâu thao tác theo thời gian:

aE = [v̇Ex v̇Ey v̇Ez]

T

Thay q1, q2, q3 từ (2.2) vào ta có:

aEx = 0.6e-2*sin²

(0.1*t) * cos(0.8*cos(0.1*t))*(a1+l3-2*l3*cos² (0.5*cos(0.5e-1*t)) -
l2*cos(0.5*cos(0.5e-1*t))) - 0.8e-2*sin(0.8*cos(0.1*t))*cos(0.1*t)*(a1+l3-2*l3*cos²
(0.5*cos(0.5e-1*t)) - l2*cos(0.5*cos(0.5e-1*t))) + 0.1e-2*sin(0.5*cos(0.5e-1*t))*cos(0.5e-1*t)*cos(0.8*cos(0.1*t))*(l2+4*l3*cos(0.5*cos(0.5e-1*t))) - 0.6e-3*sin²
(0.5e-1*t) * cos(0.8*cos(0.1*t))*cos(0.5*cos(0.5e-1*t))*(l2+4*l3*cos(0.5*cos(0.5e-1*t))) - 0.2e-2*l3*sin²
(0.5e-1*t)
*cos(0.8*cos(0.1*t))*(0.5*cos(cos(0.5e-1*t)) - 0.5) + 0.4e-2*sin(0.8*cos(0.1*t))*sin(0.5*cos(0.5e-1*t))*sin(0.1*t)*sin(0.5e-1*t)*(l2+4*l3*cos(0.5*cos(0.5e-1*t)))

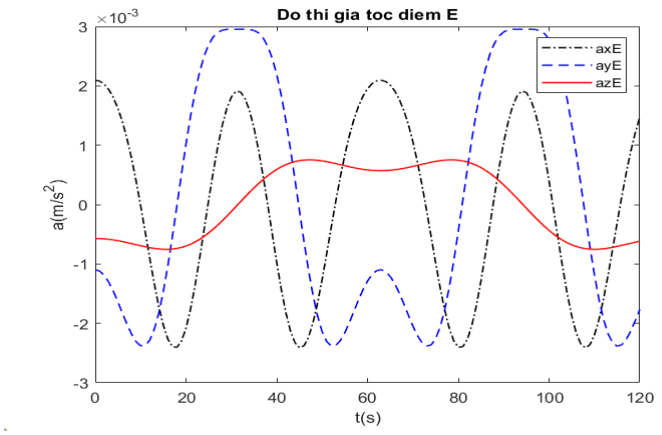
[picture p18: figure]

28

aEy = 0.6e-2*sin(0.8*cos(0.1*t))*sin²

(0.1*t) *(a1+l3-2*l3*cos(0.5*cos² (0.5e-1*t))- l2*cos(0.5*cos(0.5e-1*t))) + 0.8e-2*cos(0.1*t)*cos(0.8*cos(0.1*t))*(a1+l3-2*l3*cos(0.5*cos² (0.5e-1*t))-
l2*cos(0.5*cos(0.5e-1*t)))+0.1e-2*sin(0.8*cos(0.1*t))*sin(0.5*cos(0.5e-1*t))*cos(0.5e-1*t)*(l2+4*l3*cos(0.5*cos(0.5e-1*t))) - 0.6e-3*sin(0.8*cos(0.1*t))*sin²
(0.5e-1*t) * cos(0.5*cos(0.5e-1*t))*(l2+4*l3*cos(0.5*cos(0.5e-1*t))) - 0.2e-2*l3*sin(0.8*cos(0.1*t))*sin²
(0.5e-1*t) * (0.5*cos(cos(0.5e-1*t))-0.5) - 0.4e-2*sin(0.5*cos(0.5e-1*t))*sin(0.1*t)*sin(0.5e-1*t)*cos(0.8*cos(0.1*t))*(l2+4*l3*cos(0.5*cos(0.5e-1*t)))

aEz = -0.2e-2*l3*cos(0.5e-1*t)*(2*cos²
(0.5*cos(0.5e-1*t)) -1) - 0.6e-3*l2*sin(0.5*cos(0.5e-1*t))*sin²
(0.5e-1*t) - 0.1e-2*l2*cos(0.5e-1*t)*cos(0.5*cos(0.5e-1*t)) - 0.5e-2*l3*sin(0.5*cos(0.5e-1*t))*sin² (0.5e-1*t)
*cos(0.5*cos(0.5e-1*t))

Hình 2.9: Đồ thị gia tốc điểm thao tác E

Các bước để vẽ giải và vẽ được đồ thị:

29

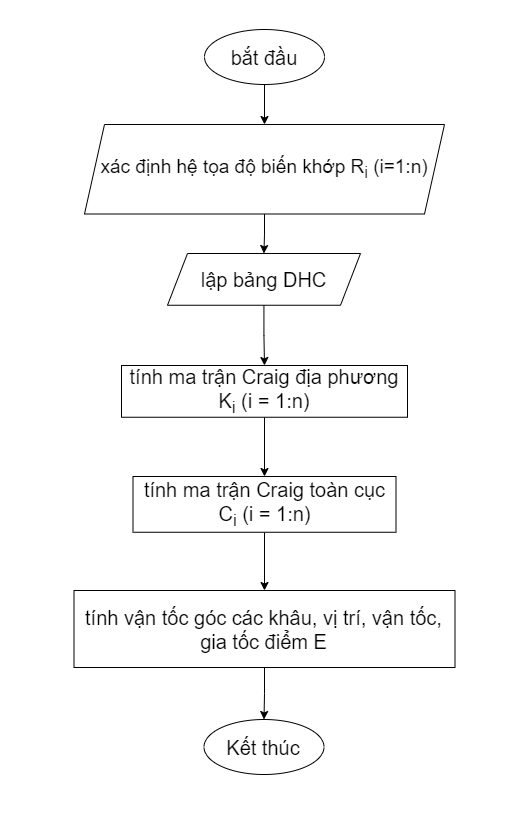
[picture p19: figure]

30

- Kết luận: từ các hình từ 2.2 đến hình 2.7 thì các đồ thị là tuyến tính không

có đoạn nào có điểm kì dị

### 2.3. BÀI TOÁN ĐỘNG HỌC NGHỊCH ROBOT

Theo đề bài ta có phương trình chuyển động của điểm thao tác như sau:

{

xE = 250 + 90. cos(

t
750)

yE = 150 + 90. sin(

t
750)
zE = 0

(mm)

Đổi sang m:

{

xE = 0,250 + 0,090. cos(

t
0,750)

yE = 0,150 + 0,090. sin(

t
0,750)

zE = 0

(m)

- Tìm t0:

Từ phương trình trên ta tìm được tọa độ tâm O của đường tròn OE(0,25; 0,15;

0)(m) R = 0.09 m.

Không gian làm việc 500x500x500mm và ta đặt gốc O cánh tại tâm hình vuông

nằm trên mặt phẳng Oxy => Ta tìm được 2 điểm cắt A(0,25; 0,24; 0) và B(0,25;

0,06; 0).

t0 =
{

0,25 = 0,250 + 0,090. cos(

t
0,750)

0,24 = 0,150 + 0,090. sin(

t
0,750)

0 = 0

t0 = 1.1780972450 (s)

- Phương trình xác định vị trí

31

Áp dụng công thức:

()
()
()

E

E

E

x q | x
y q | y
z q | z
ì | =
ï
í =
ï
î =

{

l3 cos q1 cos( q2 + q3) − cos q1(a1 − l2cos q2) = 0,250 + 0,090. cos(

t
0,750)

l3 sin q1 cos( q2 + q3) − sin q1 ( a1 − l2cos q2) = 0,150 + 0,090. sin(

t
0,750)

l1 + l2sinq2 + l3 sin ( q2 + q3) = 0

(2.4)

- Tính nghiệm đầu

Tại vị trí điểm thao tác A(0,25; 0,24; 0) thay vào (2.4)
{
l3 cos q1 cos( q2 + q3) − cos q1(a1 − l2cos q2) = 0,25 l3 sin q1 cos( q2 + q3) − sin q1 ( a1 − l2cos q2) = 0,24 l1 + l2sinq2

+ l3 sin ( q2 + q3) = 0

Ta tìm được các q1, q2, q3 ban đầu:

{q1 = 0,7649928327, q2 = -0.7909553817, q3 = -0.3543431040},

{q1 = 0.7649928327, q2 = -0.3812343942, q3 = -0.3543431040},

{q1 = -2.376599821, q2 = -1.883929333, q3 = 1.008163518},

{q1 = -2.376599821, q2 = -3.062332427, q3 = -1.008163518}

Trong các tập nghiệm trên thì {q1 = 0.7649928327, q2 = -0.3812343942, q3 = -0.3543431040} là nghiệm là cho robot có tư thế tay hợp lý.

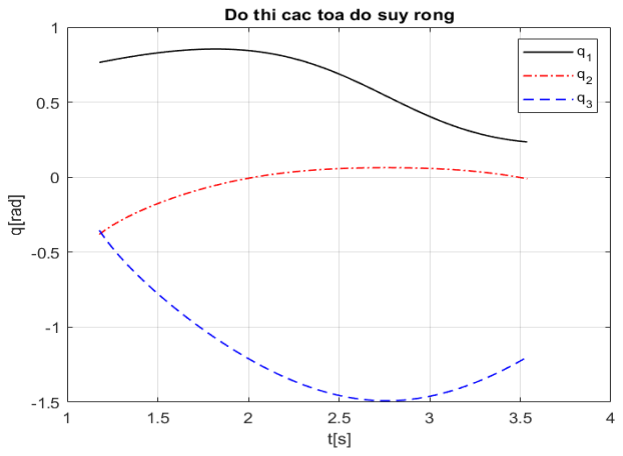
[picture p20: figure]

32

Hình 2.10: Đồ thị các tọa độ suy rộng

Mối quan hệ điểm thao tác E trong không gian khớp và không gian thao tác

f = [
f1
f2
f3

] = [
l3 cos q1 cos( q2 + q3) − cos q1(a1 − l2cos q2) l3 sin q1 cos( q2 + q3) − sin q1 ( a1 − l2cos q2) l1 + l2sinq2 + l3 sin ( q2 + q3)

]; (2.5)

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
## êú ëû

q=
;

()
( ) | ( )
| ()

E

E

E

xt
t | y t
| zt
é | | ù
ê | | ú
=
ê | | ú
ê | ú ë | û

x
(2.6)

∂f
∂q

q̇ = ẋ(t) ⇔ Jqq̇ = ẋ(t); Jq =

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
q3 ]

∂f1
∂q1

= sin(q1)(a1 − l2cos(q2)) − l3cos(q2 + q3)sin(q1)

∂f1
∂q2

= −l2cos(q1)sin(q2) − l3sin(q2 + q3)cos(q1)

33

∂f1
∂q3

= −l3sin(q2 + q3)cos(q1)

∂f2
∂q1

= l3cos(q2 + q3)cos(q1) − cos(q1)(a1 − l2cos(q2))

∂f2
∂q2

= −l2sin(q1

)sin(q2

) − l3sin( q2 + q3)sin(q1

)

∂f2
∂q3

= −l3sin( q2 + q3)sin(q1

)

∂f3
∂q1

= 0

∂f3
∂q2

= l2cos(q2) + l3cos(q2 + q3)

∂f3
∂q3

= −l3cos(q2 + q3)

Ta có biểu thức xác định vecto vận tốc suy rộng

ẋ(t) = [

−0,12. sin(1,3t)
0,12. cos(1,3t)
0

]

Jq. q̇ = ẋ(t) <=> q̇ = Jq

−1
. ẋ(t)

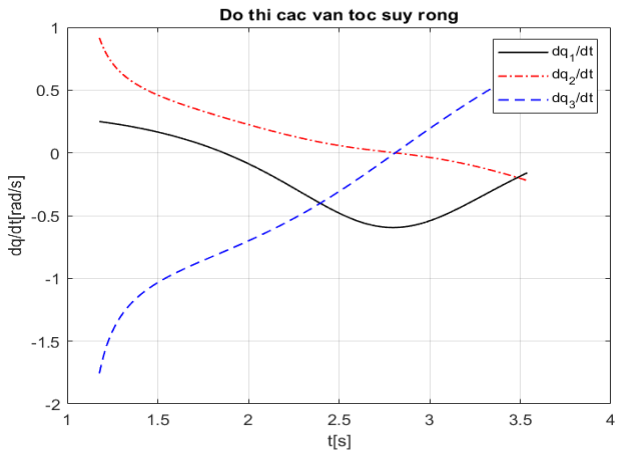
[picture p21: figure]

Hình 2.11: Đồ thị các vận tốc suy rộng

]

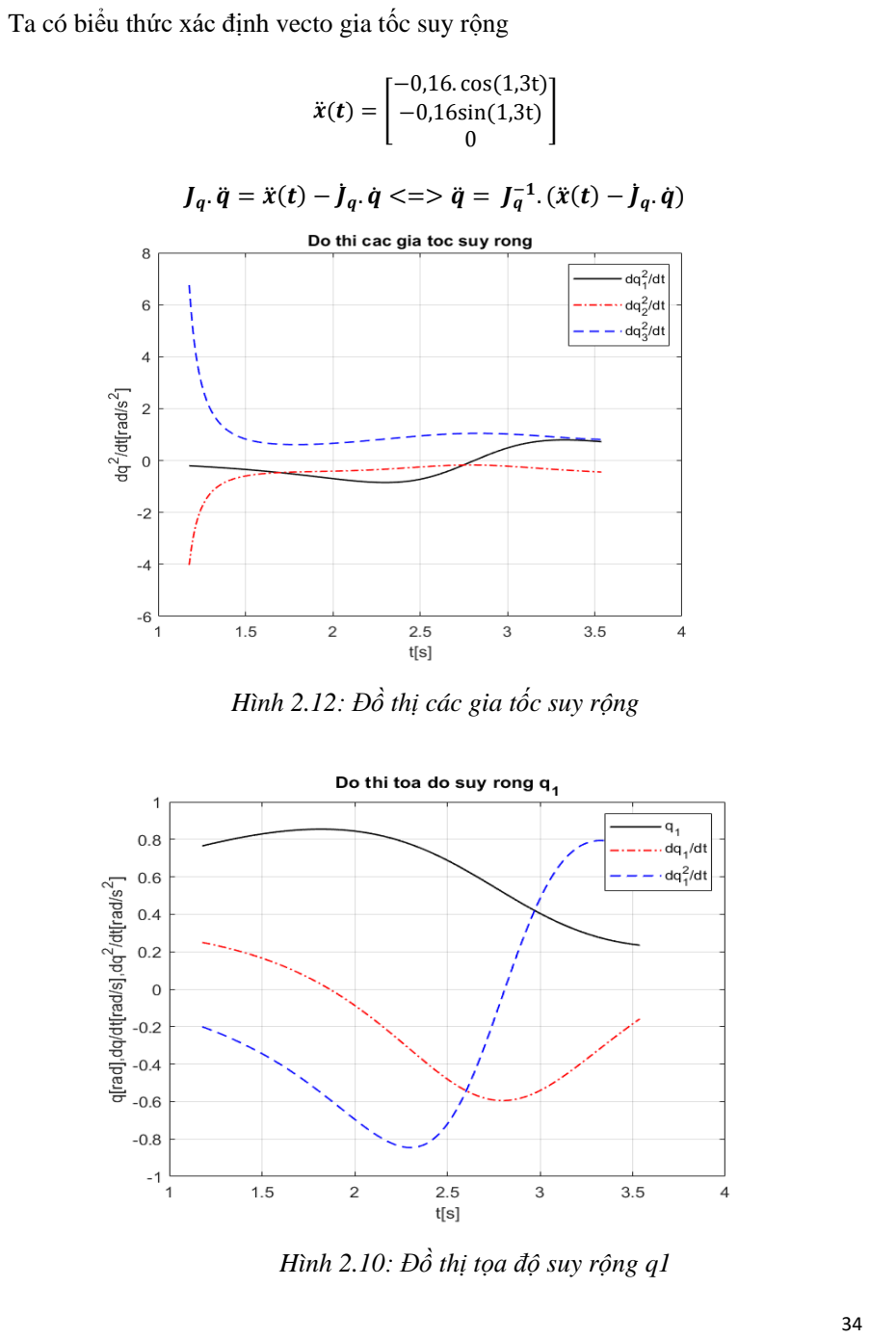
[picture p22: page 42]

34

Ta có biểu thức xác định vecto gia tốc suy rộng

ẍ(t) = [

−0,16. cos(1,3t)
−0,16sin(1,3t)
0

Jq. q̈= ẍ(t) − J̇
q. q̇ <=> q̈= Jq

−1

. (ẍ(t) − J̇
q. q̇)

Hình 2.12: Đồ thị các gia tốc suy rộng

Hình 2.10: Đồ thị tọa độ suy rộng q1

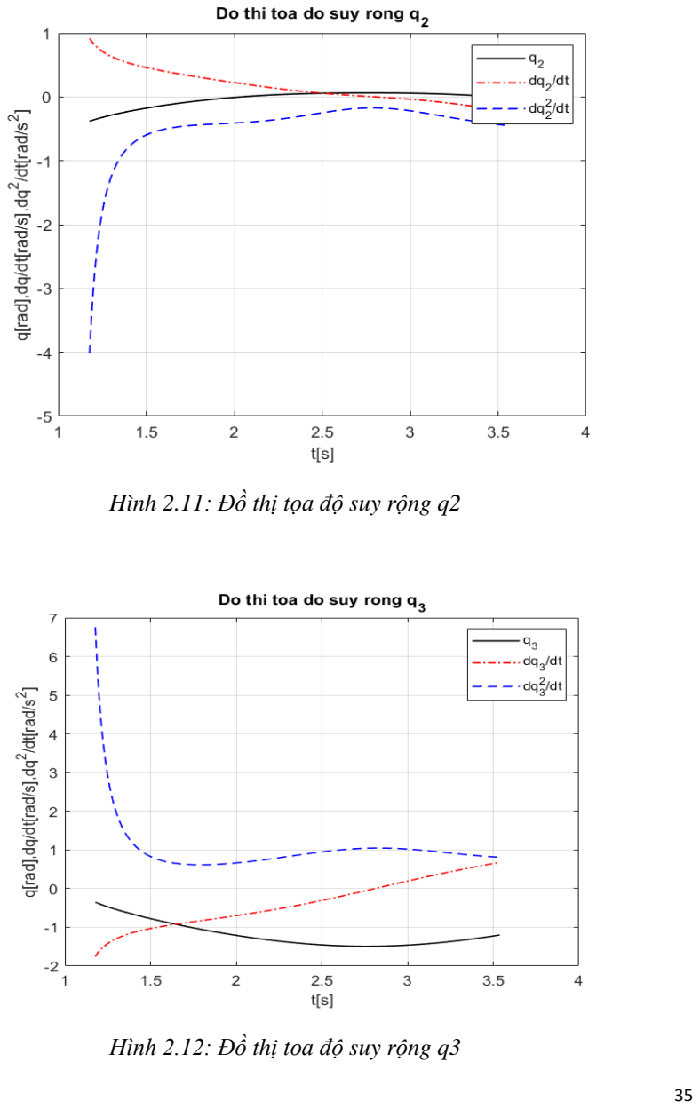
[picture p23: page 43]

35

Hình 2.11: Đồ thị tọa độ suy rộng q2

Hình 2.12: Đồ thị toa độ suy rộng q3

36

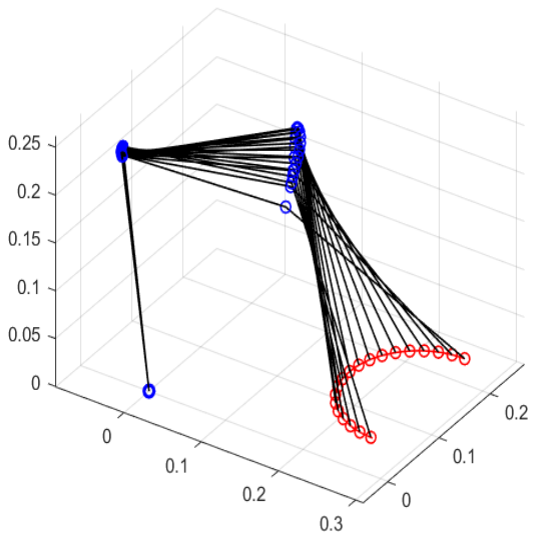
[picture p24: figure]

Hình 2.13: Cấu hình robot

- Kết luận: các đồ thị tại mục 2.3 là tuyến tính và trong khoảng thời gian từ

tA = 1,18s đến tB = 3.54s thì biên dạng quỹ đạo làm việc nằm trong không

gian làm việc không gian làm việc ở hình 2.13

- Tổng kết chương: ta đã đặt được hệ trục và từ đó lập được bảng thông số

động học qua đó ta tính được các bài toán liên quan đến robot như bài toán

động học thuận và bài toán động học nghịch và vẽ được các đồ thị biểu diện

được các thông số đã tính toán trên.

Lưu đồ thuật toán động học nghịch:

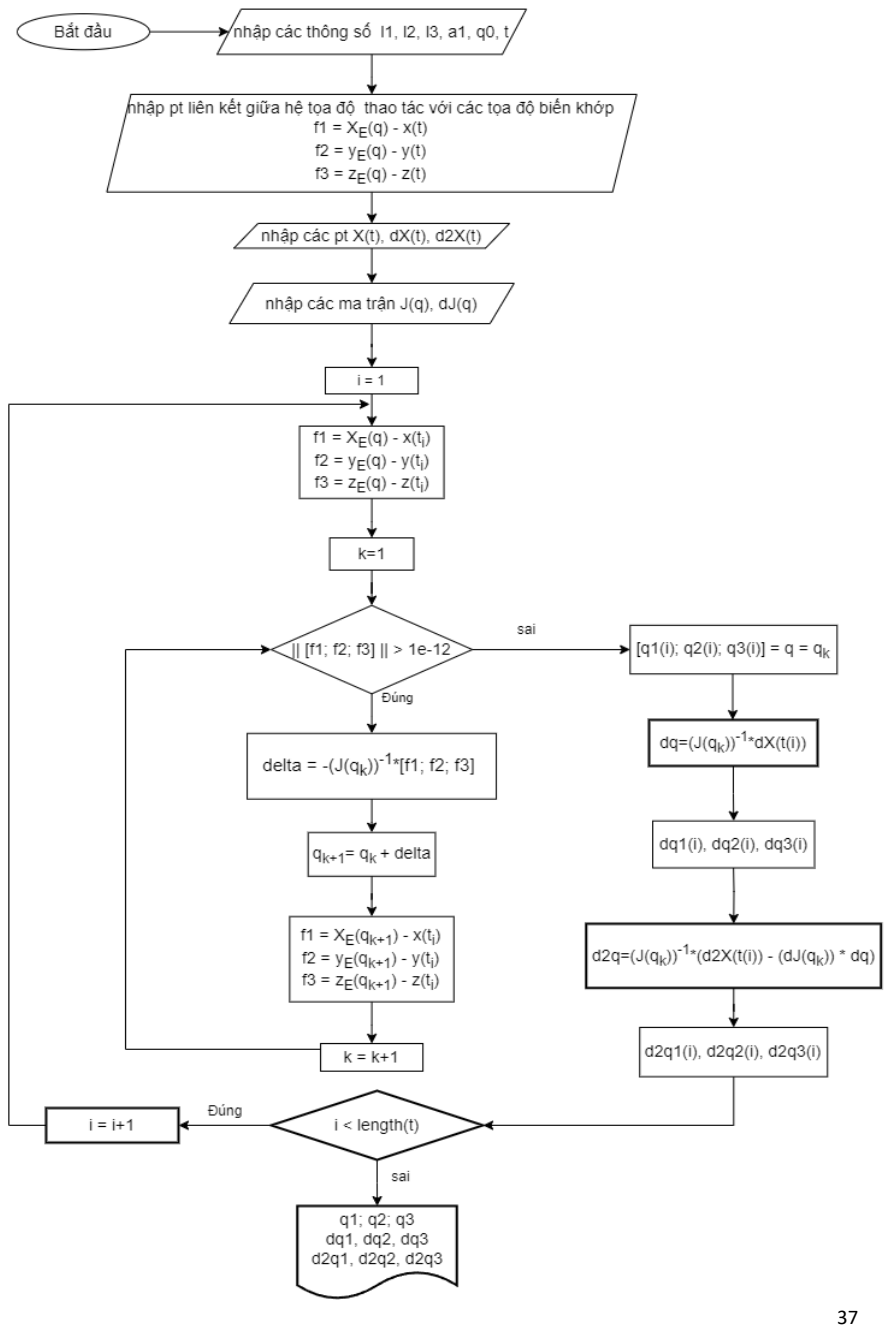
[picture p25: page 45]

37

38

CHƯƠNG 3: THIẾT KẾ ROBOT

### 3.1. Giới thiệu phần mềm thiết kế 3D

Hiện nay, có rất nhiều phần mềm thiết kế 3D chuyên nghiệp. Tuỳ vào từng

ngành nghề khác nhau mà có những lựa chọn sao cho phù hợp. Trong đó cómột

vài phần mềm phổ biến hiện nay như: AutoCAD, Revit, Inventor, Sketchup,

Solidworks,… Trong môn đồ án này em dùng phần mềm Solidworks để vẽ 3D.

### 3.1.1. Tổng quan và tính năng về phần mềm

Để mô phỏng robot 3 bậc tự do, em chọn sử dụng phần mềm Solidworks. Phần

mềm Solidworks cung cấp cho người dùng những tính năng tuyệt vời nhất về:

- Thiết kế các chi tiết các khối 3D, lắp ráp các chi tiết đó để hình thành nên nhưng

bộ phận của máy móc; xuất bản vẽ 2D các chi tiết đó là những tính năng rất phổ

biến của phần mềm Solidworks; ngoài ra còn có những tính năng khác nữa như:

phân tích động học, phân tích động lực học; bên cạnh đó phần mềm còn tích hợp

modul Solidcam để phục vụ cho việc gia công trên CNC nhờ có phay Solidcam

và tiện Solidcam; hơn nữa, cũng có thể gia công nhiều trục trên Solidcam, modul

3Dquickmold phục vụ cho việc thiết kế khuôn;

- Phân tích động lực học: Solidworks Simulation cung cấp các công cụ mô phỏng

để kiểm tra và cải thiện chất lượng bản thiết kế của bạn. Các thuộc tính vật liệu,

mối ghép, quan hệ hình học được định nghĩa trong suốt quá trình thiết kế được

cập nhật đầy đủ trong mô phỏng;

- Tính năng gia công: giải pháp gia công CAD CAM kết hợp, giải pháp có tên

Solidworks CAM. Giài pháp này khá đơn giản và dễ dùng. Các modul đơn giản

thân thiện;

39

- Thiết kế mô hình 3D: trong phần mềm Solidworks thì đây được coi là tính năng

nổi bật với việc thiết kế các các biên dạng 2D bạn sẽ dựng được các khối 3D theo

yêu cầu;

- Lắp ráp các chi tiết: các chi tiết 3D sau khi được thiết kế xong bởi tính năng thiết

kế có thể lắp ráp lại với nhau tạo thành một bộ phận máy hoặc một máy hoàn

chỉnh.

- Xuất bản vẽ dễ dàng: phần mềm Solidworks cho phép ta tạo các hình chiếu

vuông góc các chi tiết hoặc các bản lắp với tỉ lệ và vị trí do người sử dụng quy

định mà không ảnh hưởng đến kích thước. Công cụ tạo kích thước tự động và kích

thước theo quy định của người sử dụng. Sau đó nhanh chóng tạo ra các chú thích cho các lỗ một cách nhanh chóng. Chức năng ghi độ nhám bề mặt, dung sai kích

thước và hình học được sử dụng dễ dàng;

- Các tiện ích cải tiến khác: Online Licensing giúp cho việc sử dụng các license

trên nhiều máy tính tiện lợi hơn trước rất nhiều. Solidworks Login sẽ chuyển các

nội dung và cài đặt các tùy chịn đến bất kỳ máy tính nào được cài Solidworks,

trong khi Admin Portal cho phép quản lý các sản phẩm và dịch vụ của Solidworks

dễ dàng hơn.

### 3.2. Thiết kế các chi tiết và mô hình robot

### 3.2.1. Mô hình robot

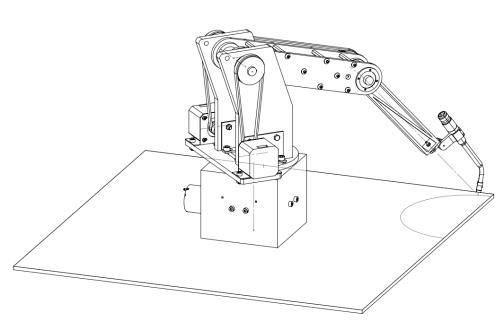
[picture p26: figure]

Hình 3.1: Mô hình robot

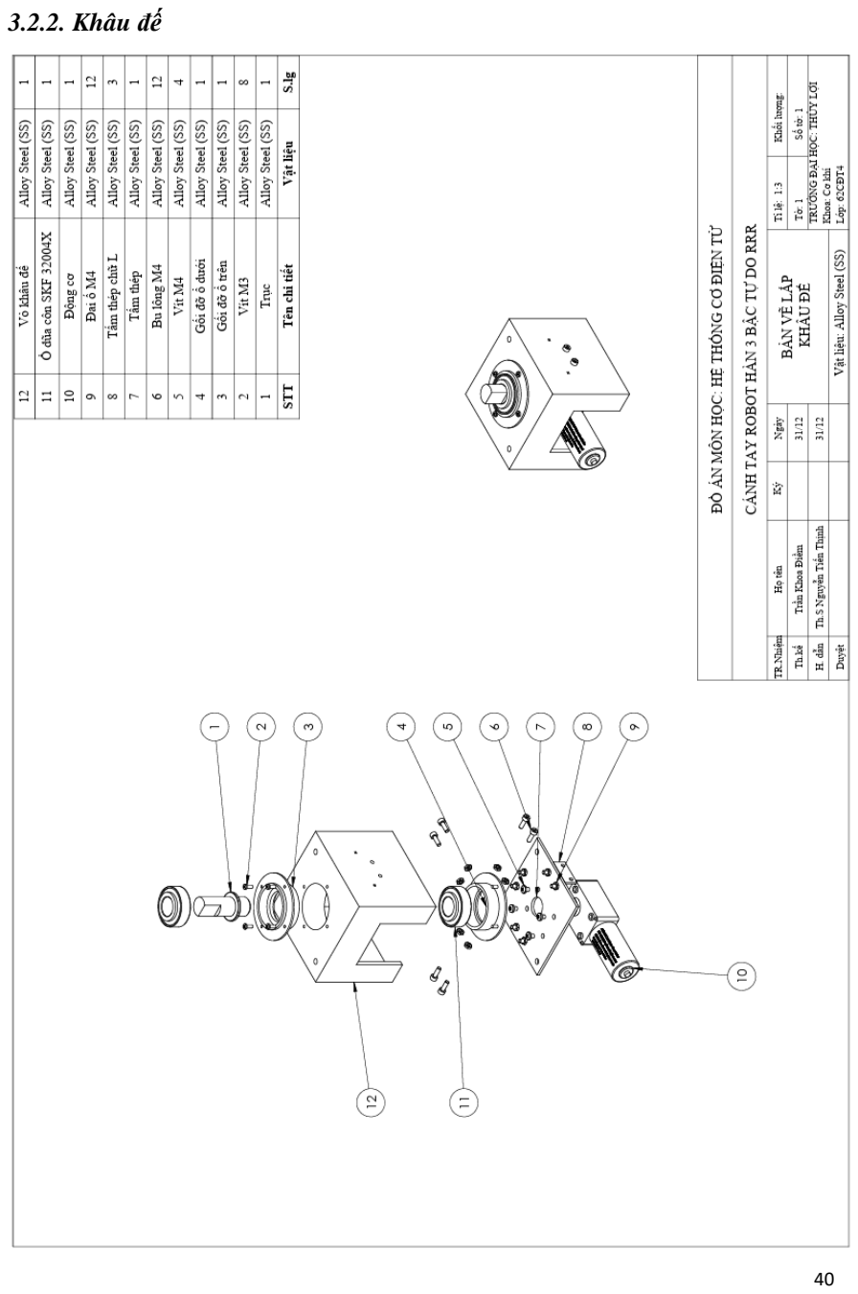
[picture p27: page 48]

40

### 3.2.2. Khâu đế

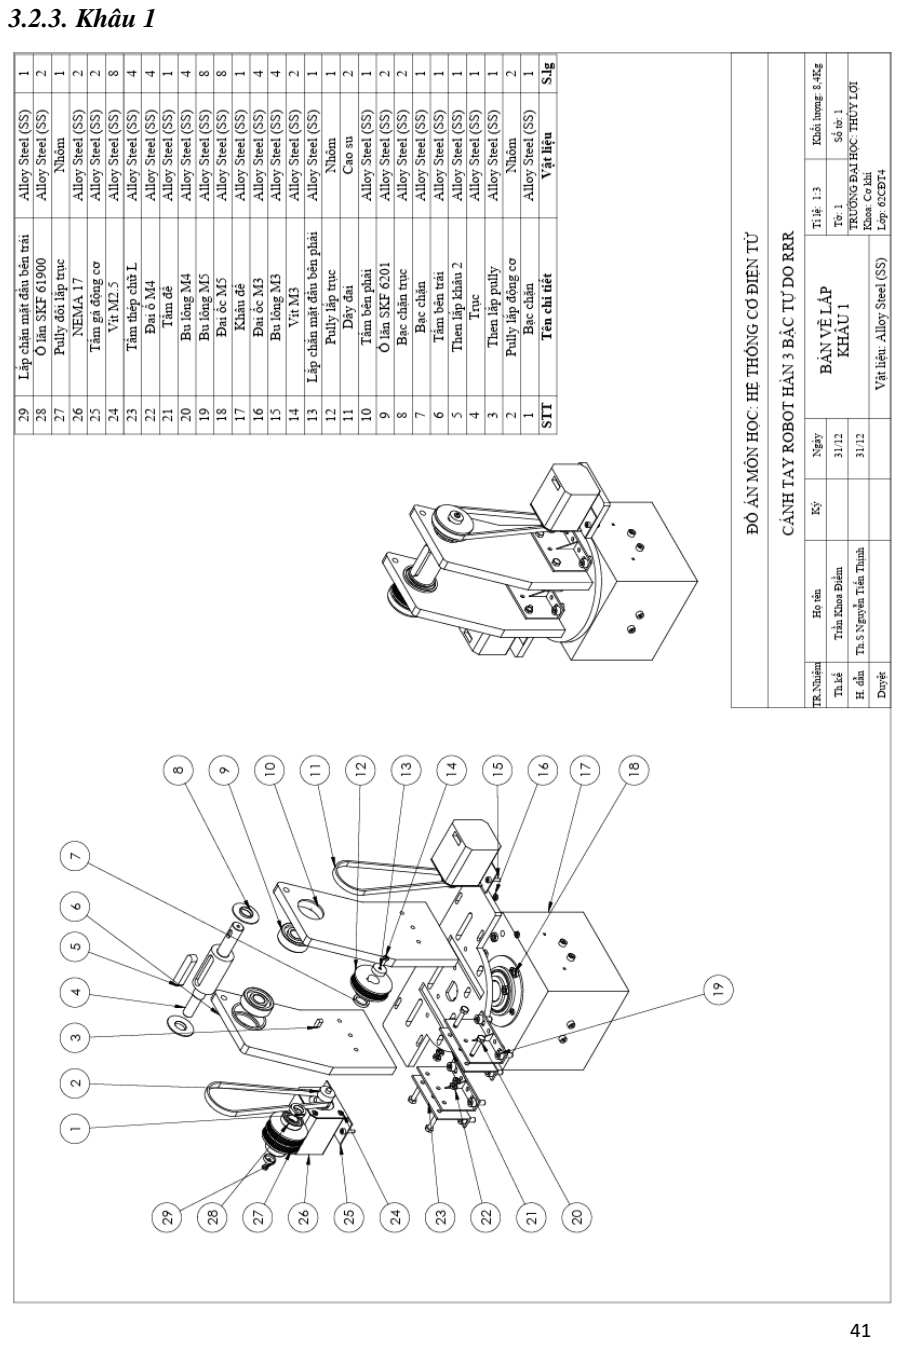
[picture p28: page 49]

41

### 3.2.3. Khâu 1

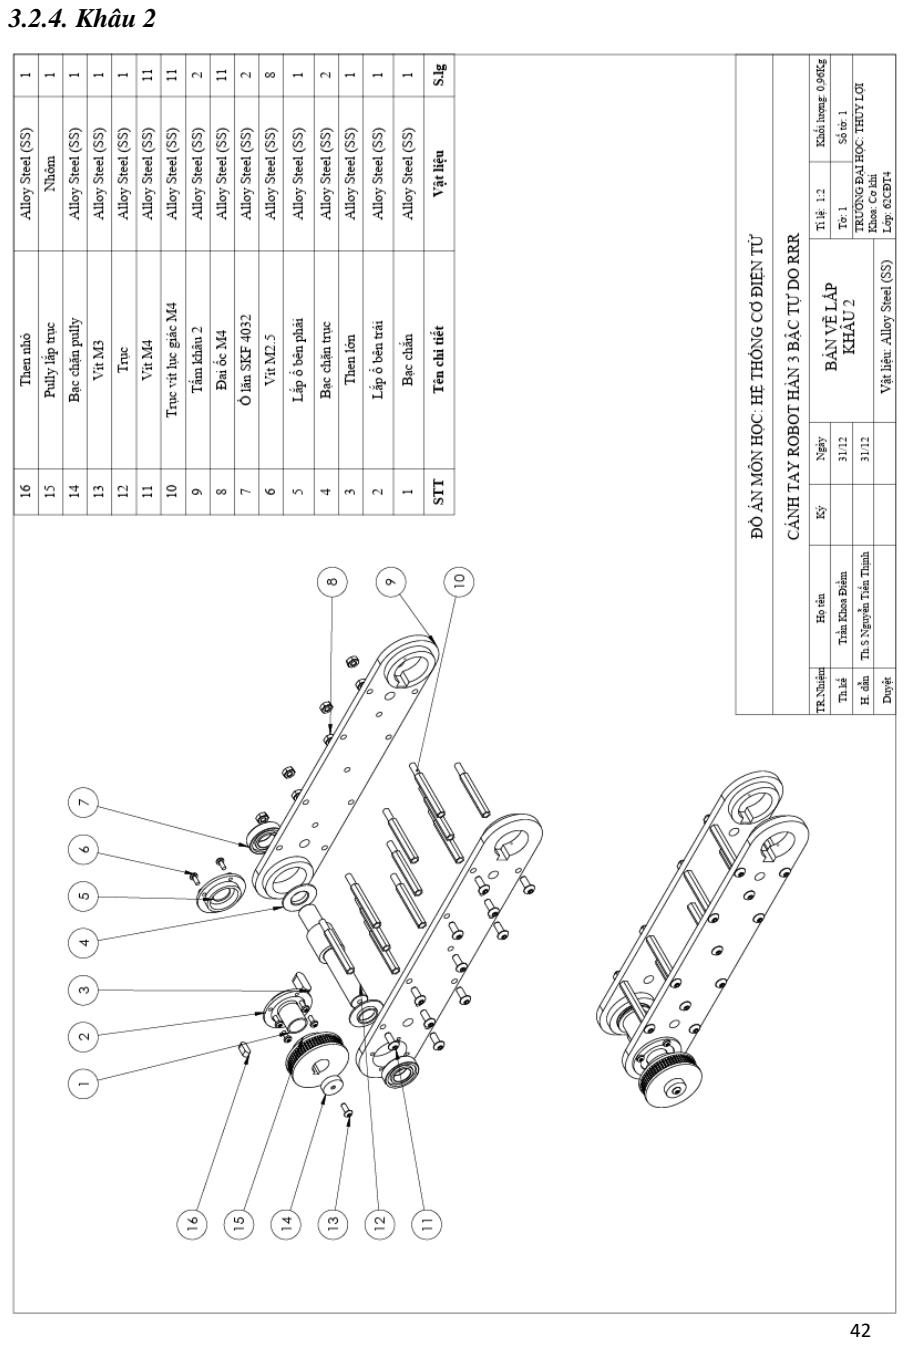
[picture p29: page 50]

42

### 3.2.4. Khâu 2

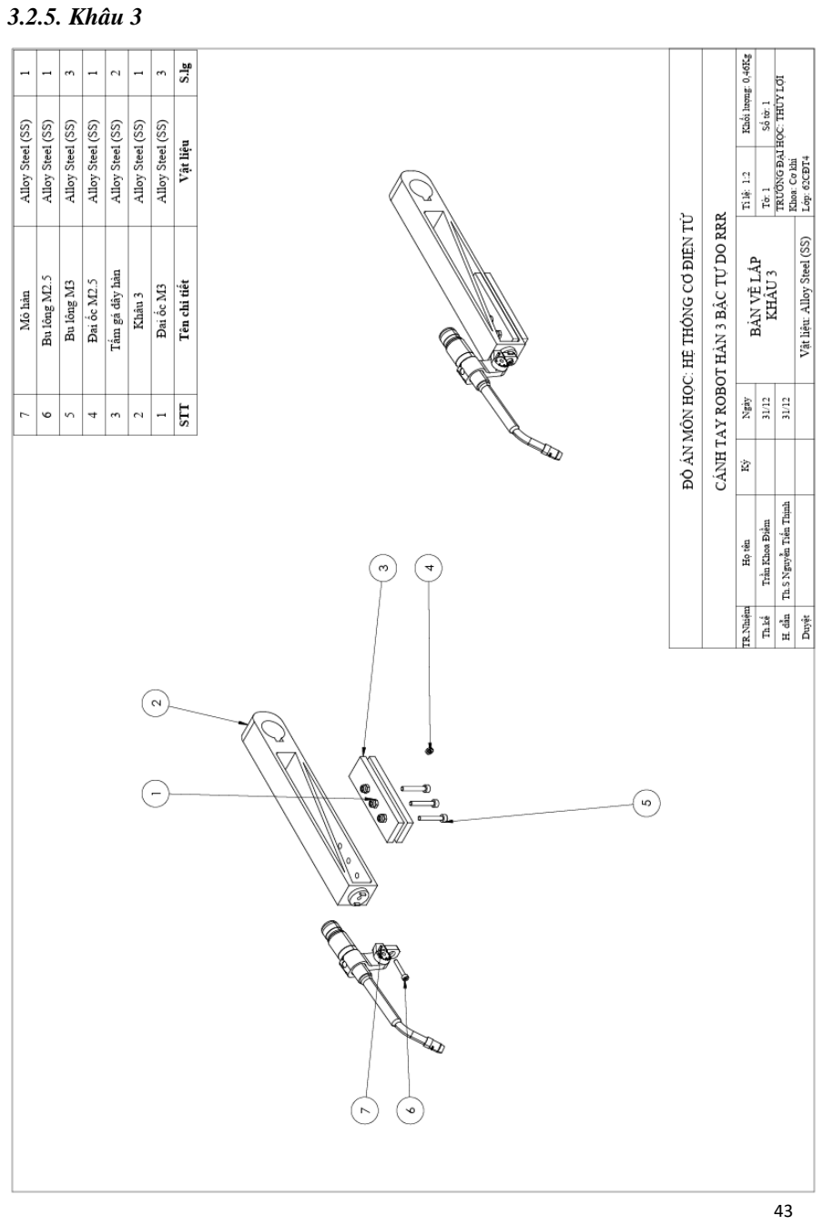
[picture p30: page 51]

43

### 3.2.5. Khâu 3

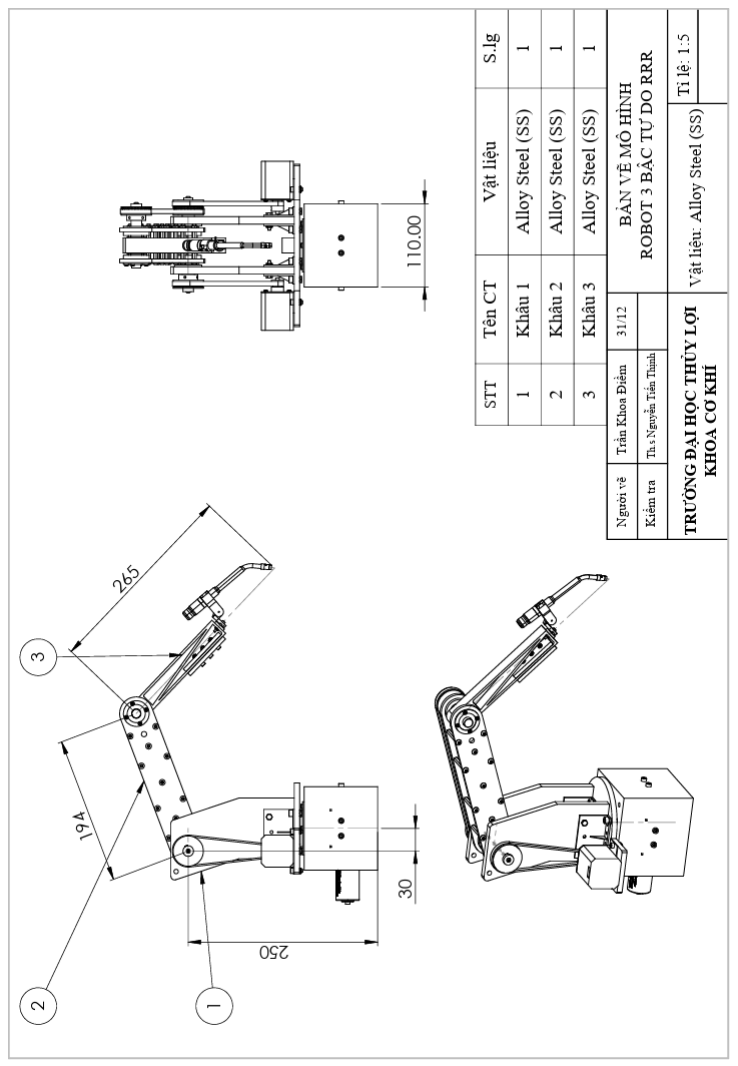
[picture p31: figure]

44

### 3.3. Bản vẽ robot 2D

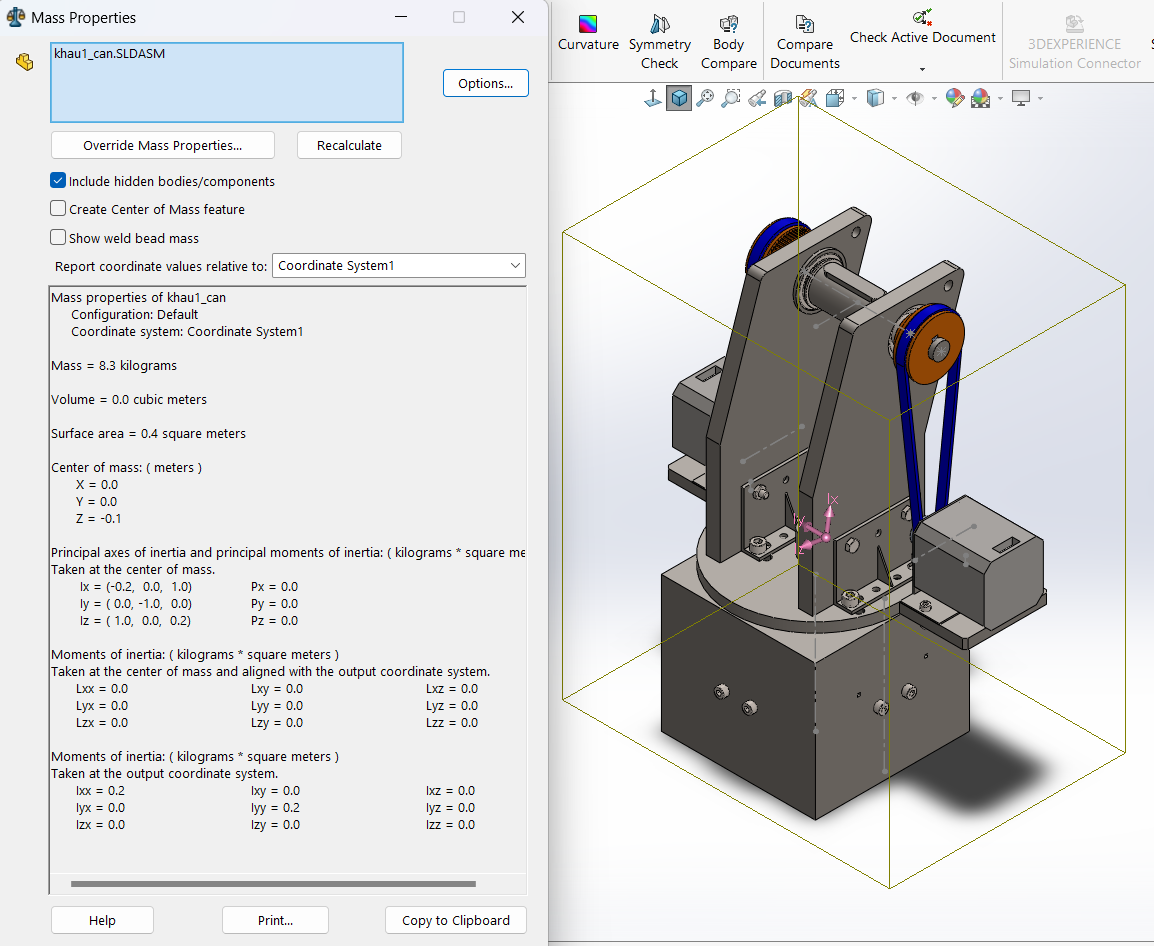
[picture p32: figure]

45

CHƯƠNG 4: BÀI TOÁN ĐỘNG LỰC HỌC

### 4.1. Xác định các tham số động lực học

- Sử dụng phần mềm Solidworks ta tìm được vị trí trọng tâm của khâu và

ma trận mô men quán tính của khâu:

- Khâu 1:

Hình 4.1: Bảng thông số khâu 1

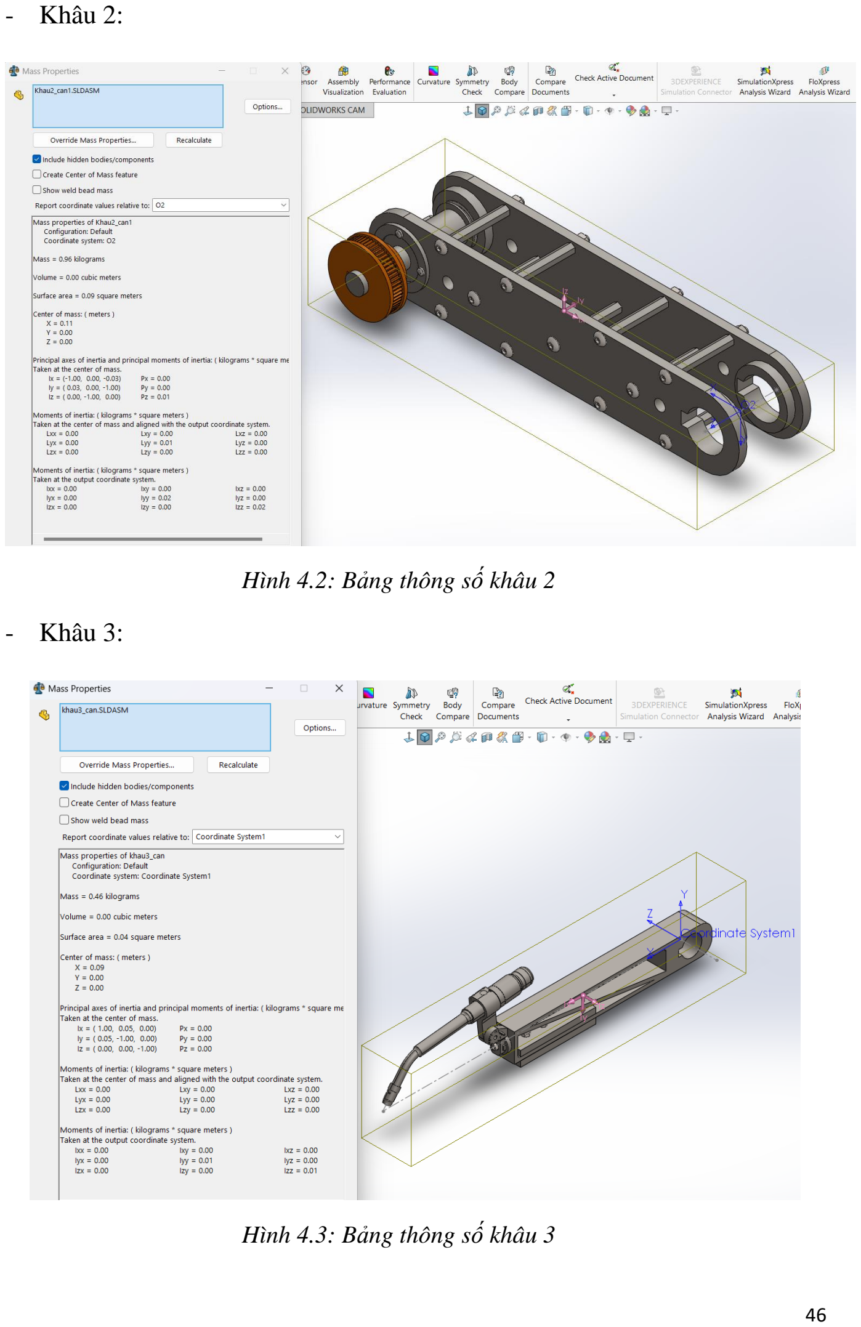
[picture p33: page 54]

46

- Khâu 2:

Hình 4.2: Bảng thông số khâu 2

- Khâu 3:

Hình 4.3: Bảng thông số khâu 3

47

- Từ các thông số trên ta xây dựng bảng tham số động học:
Khâu | Vị trí trọng tâm (M) | Khối Lượng (KG) | Ma trận momen quán tính
xc | yc | zc | | Ixx | Iyy | Izz | Ixy | Iyz | Izx
1 | 0 | 0 | -0,1 | m1 = 8,3 | 0,2 | 0,2 | 0 | 0 | 0 | 0
2 | 0,11 | 0 | 0 | m2 = 0,96 | 0 | 0,02 | 0,02 | 0 | 0 | 0
3 | 0,09 | 0 | 0 | m3 = 0,46 | 0 | 0,01 | 0,01 | 0 | 0 | 0

### 4.2. Thiết lập phương trình vi phân chuyển động của robot

Với:

sin(q1) = S1, sin(q2) = S2, sin(q3) = S3, sin(q2+q3) = S23,

cos(q1) = C1, cos(q2) = C2, cos (q3) = C3, cos (q2+q3) = C23,

q̇1 = dq1, | q̇2 = dq2, | q̇3 = dq3
q̈1 = d2q1, | q̈2 = d2q2, | q̈3 = d2q3

Chọn các tọa độ suy rộng là

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
### êú ëû

q

Các ma trận Craig địa phương K1 = [

cos q1 − sin q1 0 0
sin q1 | cos q1 | 0 0
0 | 0 | 1 l1
0 | 0 | 0 1
]; | K2 = [
cos q2 − sin q2 | 0 | −a1
0 | 0 | −1 | 0
sin q2 | cos q2 | 0 | 0
0 | 0 | 0 | 1

]

K3 = [

cos q3 −sin q3 0 l2
sin q3 | cos q3 | 0 0
0 | 0 | 1 0
0 | 0 | 0 1

]

48

Các ma trận Craig toàn thể:

C2 = K1K2 = [

cos q1 cos q2 − cos q1 sin q2 | sin q1 | −a1. cosq1
sin q1 cos q2 − sin q1 sin q2 − cos q1 −a1. sinq1
sin q2 | cos q2 | 0 | l1
0 | 0 | 0 | 1

]

C3 = K1K2K3 =
[
cos q1 cos( q2 + q3) − cos q1 sin( q2 + q3) | sin q1 | −cosq1(a1 − l2cosq2)
sin q1 cos( q2 + q3) − sin q1 sin( q2 + q3) − cos q1 −sinq1(a1 − l2cosq2)
sin( q2 + q3) | cos( q2 + q3) | 0 | l1 + l2sinq2
0 | 0 | 0 | 1

]

Tọa độ khối tâm các khâu trong hệ quy chiếu gắn liền với khâu có dạng

uC1

(1) = [
0
0
−0,1
1

] ; uC2

(2) = [
0,11
0
0
1

] ; uC3

(3) = [
0,09
0
0
1

]

Từ đó ta có tọa độ khối tâm các khâu so với hệ quy chiếu cố định R0,

( ) 0

i | i
R | i
C | i C r | C u =

=>rC1 = [

0
0

0,15] ; rC2 = [ 0,11. C1C2 − 0,03. C1
0,11. S1C2 − 0,03. S1
0,25 + 0,11. S2

] ;

rC3 = [
0,09. C1C23 − (0,03 − 0,194. C2)C1 0,09. S1C23 − (0,03 − 0,194. C2)S1 0,09. S23 + 0,25 + 0,194S2

]

Các ma trận Jacobi tịnh tiến của các khâu

JT1 =

∂rC1

∂q = [

0 0 0
0 0 0
0 0 0

] ;

JT2 =

∂rC2
∂q

= [

−0,11. S1C2 + 0,03S1 | −0,11. C1S2 | 0
0,11. C1C2 − 0,03C1 | −0,11. S1S2 | 0
0 | 0,11. C2 | 0

];

49

JT3 =

∂rC3

∂q = [

j11 | j12 | j13
j21 | j22 | j23
j31 | j32 | j33

]

j11 = −0,09. S1C23 + S1(0,03 − 0,194C2)

j12 = -0,09.S23S1 - 0,194.C1S2

j13 = -0,09.S23C1

j21 = 0,09. C1C23 − C1(0,03 − 0,194C2)

j22 = -0,09.S23S1 - 0,194.S1S2

j23 = -0,09.S23S1

j31 = 0

j32 = 0,09.C23 - 0,194.C2

j33 = 0,09.C23

Từ các ma trận Craig ta có các ma trận cô sin chỉ hướng của các khâu so với hệ quy chiếu cố định

1 | 1
1 | 1 | 1

0
0
0 | 0 | 1
C | S
S | C
é | ù −
ê | | ú
=
ê | | ú
ê | ú ë | û

A ;

1 | 2 | 1 | 2 | 1
2 | 1 | 2 | 1 | 2 | 1
2 | 2 | 0
C C | C S | S
S C | S S | C
S | C
é | ù −
ê | ú
= | − | − ê | ú
ê | ú ë | û

A

1 | 23 | 1 | 23 | 1
3 | 1 | 23 | 1 | 23 | 1
23 | 23 | 0
C C | C S | S
S C | S S | C
S | C
é | ù −
ê | ú
= | − | − ê | ú
ê | ú ë | û

A

Vận tốc góc các khâu:

ω1

(0) = [

0
0
q̇1

]

50

ω2

(0) = [

q̇2. sinq1
−q̇2. cosq1
q̇1

]

ω3

(0) = [

(q̇2 + q̇3). sinq1
−(q̇2 + q̇3). cosq1
q̇1

]

Từ vận tốc góc các khâu ta tính được các ma trận Jacobi quay:

JR1 =

∂ω1
∂q̇

= [

0 0 0
0 0 0
1 0 0

]; JR2 =
∂ω2
∂q̇

= [

0 | S1 | 0
0 −C1 | 0
1 | 0 | 0

]; JR3 =
∂ω3
∂q̇

= [

0 | S1 | S1
0 −C1 | −C1
1 | 0 | 0

]

Thay các ma trận Jacobi tịnh tiến và Jacobi quay vào biểu thức
( | )

3

1
1
T | T | | T
Ti Ti | Ri | i i | i | Ri
i

m

=

M | J J | J A I A J = | + ∑

Ta nhận được ma trận khối lượng suy rộng của robot

11 | 12 | 13
21 | 22 | 23
31 | 32 | 33
m | m | m
m | m | m
m | m | m
é | | ù
ê | | ú
=
ê | | ú
ê | ú ë | û

M

Trong đó

m11=0,00147 + 0,05C2

2
- 0,0135C2 + 0,01C23

2 – 0,003C23 + 0,02C23C2

m12= 0

m13= 0

m21= 0

m22=0,02S2S23 + 0,062 + 0,02C2C23

m23=0,009S2S23 + 0,01 + 0,009C2C23 - 0,004C1

2

51

m31=0

m32=0,008S2S23 + 0,01 + 0,008C2C23 - 0,004C1

2

m33=0,01 - 0,004C1

2

Thế năng của robot có dạng

Π = −∑mig0
T
rCi

3

i=1

Π= 12 + 1,92.S2 - 0,4S23

Từ biểu thức thế năng ta có

g = (

∂Π
∂q)

T

= [

0
1,9C2 + 0,41C23
0,41C23

]

Tính đạo hàm riêng ma trận khối lượng theo biến vecto q

∂M(q)
∂q

=

11 | 11 | 11 | 12 | 12 | 12 | 13 | 13 | 13
21 | 21 | 21 | 22 | 22 | 22 | 23 | 23 | 23
31 | 31 | 31 | 32 | 32 | 32 | 33 | 33 | 33
1 | 2 | 3 | 1 | 2 | 3 | 1 | 2 | 3
1 | 2 | 3 | 1 | 2 | 3 | 1 | 2 | 3
1 | 2 | 3 | 1 | 2 | 3 | 1 | 2 | 3
M | M | M | M | M | M | M | M | M
q | q | q | q | q | q | q | q | q
M | M | M | M | M | M | M | M | M
q | q | q | q | q | q | q | q | q
M | M | M | M | M | M | M | M | M
q | q | q | q | q | q | q | q | q
é ∂ | ∂ | ∂ | ∂ | ∂ | ∂ | ù ∂ | ∂ | ∂
ê
∂ | ∂ | ∂ | ∂ | ∂ | ∂ | ∂ | ∂ | ∂ ê
ê∂ | ∂ | ∂ | ∂ | ∂ | ∂ | ∂ | ∂ | ∂ ê
∂ | ∂ | ∂ | ∂ | ∂ | ∂ | ∂ | ∂ | ∂ ê
ê∂ | ∂ | ∂ | ∂ | ∂ | ∂ | ∂ | ∂ | ∂ ê
ë | û ∂ | ∂ | ∂ | ∂ | ∂ | ∂ | ∂ | ∂ | ∂

ú
ú
ú
ú
ú
ú
ú

Trong đó:

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
= -0,1C2S2 + 0,0135S2 - 0,02S23C23 + 0,003S23 - 0,02C2S23 – 0,02S2C23

11
3

M
q

∂
∂

= -0,02S23 .(C23 - 0,15 + C2)

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
= 0,02S2C23 - 0,02C2S23

23
1

M
q

∂
∂

= 0,008 C1S1

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
= 0,009.S2C23 – 0,009.C2S23

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
= 0,008 C1S1

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
= 0,008.S2C23 – 0,008.C2S23

33
1

M
q

∂
∂

= 0,008 C1S1

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
Ma trận ly tâm và Coriolis được xác định theo công thức

C(q, q̇) =

∂M(q)
∂q

(I3 ⊗ q̇) −

1
2

(
∂M(q)
∂q

(q̇ ⊗ I3

))

T

Sử dụng phần mềm Maple ta tính được

C(q, q̇) = [

c11 | c12 | c13
c21 | c22 | c23
c31 | c32 | c33

]

54

Trong đó:

c11 = (-0,1S2C2 + 0,01S2 - 0,02S23C23 + 0,003S23 - 0,02S23C2 - 0,02S23S2)q̇2 -

0,02S23(C23 -0,2C2).q̇3

c12 = -0,004S1C1.q̇3

c13 = -0,004S1C1.q̇3 - 0,004S1C1.q̇2

c21 = -0,5.(-0,1S2C2 + 0,01S2 - 0,02S23C23 + 0,003S23 - 0,02S23C2 - 0,02C23S2).q̇1

c22 = (0,02S2C23 - 0,02S23C2).q̇3

c23 = 0,008S1C1.q̇1 + (0,009C23S2 - 0,009S23C2).q̇3

c31 = 0,01S23.(C23 – 0,2 + C2). q̇1

c32= 0,008S1C1.q̇1+ (0,008C23S2 - 0,008S23C2).q̇3 - 0,5.(0,02S23S2 -0,02S23C2). q̇2

- 0,5.(0,009C23S2 - 0, 009S23C2). q̇3

c33 = 0,008S1C1.q̇1 – 0,5.(0,008C23S2 - 0,008S23C2).q̇2

Áp dụng những thông số trên ta sử dụng phương trình Lagrange loại II ta thiết lập

được phương trình vi phân chuyển động của robot

M(q)q̈+ C(q, q̇)q̇ + g(q) = τ

Trong đó: τ = [

τ1
τ2
τ3

]

τ1 = 0.1e-2*d2q1+0.5e-1*d2q1*cos(q2)
2
- 0.1e-1*d2q1*cos(q2)+0.1e-

1*d2q1*cos(q2+q3)

2
- 0.3e-2*d2q1*cos(q2+q3)+0.2e-1*d2q1*cos(q2+q3)*cos(q2)-

0.1*dq1*dq2*cos(q2)*sin(q2)+0.1e-1*dq1*dq2*sin(q2)-0.2e-

1*dq1*dq2*cos(q2+q3)*sin(q2+q3)+0.3e-2*dq1*dq2*sin(q2+q3)-0.2e-

1*dq1*dq2*sin(q2+q3)*cos(q2)-0.2e-1*dq1*dq2*cos(q2+q3)*sin(q2)-0.2e-

1*dq1*sin(q2+q3)*dq3*cos(q2+q3)+0.3e-2*dq1*sin(q2+q3)*dq3-0.2e-

55

1*dq1*sin(q2+q3)*dq3*cos(q2)-0.8e-2*cos(q1)*sin(q1)*dq3*dq2-0.4e-

2*cos(q1)*sin(q1)*(dq3)

2
;

τ2 = 0.6e-1*d2q2+0.2e-1*d2q2*sin(q2+q3)*sin(q2)+0.2e-

1*d2q2*cos(q2+q3)*cos(q2)+0.1e-1*d2q3 - 0.4e-2*d2q3*cos(q1)

2+0.9e-

2*d2q3*sin(q2+q3)*sin(q2) + 0.9e-2*d2q3*cos(q2+q3)*cos(q2)+0.5e-

1*(dq1)

2*cos(q2)*sin(q2) - 0.7e-2*(dq1)²*sin(q2)+0.1e-1*sin(q2+q3)*

(dq1)²*cos(q2+q3)-0.2e-2*sin(q2+q3)* (dq1)²+0.1e-1*sin(q2+q3)*

(dq1)²*cos(q2)+0.1e-1*(dq1)²*cos(q2+q3)*sin(q2)+0.2e-

1*dq2*dq3*cos(q2+q3)*sin(q2)-0.2e-1*dq2*sin(q2+q3)*dq3*cos(q2)+0.8e-

2*dq3*cos(q1)*sin(q1)*dq1+0.9e-2*(dq3)

2*cos(q2+q3)*sin(q2)-0.9e-

2*sin(q2+q3)*(dq3)

2*cos(q2)+2*cos(q2)+0.4*cos(q2+q3)

τ3 = 0.1e-1*d2q2-0.4e-2*d2q2*cos²
(q1) + 0.8e-2*d2q2*sin(q2+q3)*sin(q2)+0.8e-

2*d2q2*cos(q2+q3)*cos(q2)+0.1e-1*d2q3-0.4e-2*d2q3*cos²
(q1) +0.1e-1*sin(q2+q3)* (dq1)²*cos(q2+q3)-0.2e-2*sin(q2+q3)* (dq1)²+0.1e-1*sin(q2+q3)*

(dq1)²*cos(q2)+0.8e-2*dq2*cos(q1)*sin(q1)*dq1-0.5e-

3*dq2*dq3*cos(q2+q3)*sin(q2)+0.5e-3*dq2*sin(q2+q3)*dq3*cos(q2)-0.1e-

1*(dq2)

2*cos(q2+q3)*sin(q2)+0.1e-1*(dq2)

2*sin(q2+q3)*cos(q2)+0.8e-

2*dq3*cos(q1)*sin(q1)*dq1+0.4*cos(q2+q3)

Ta nhận được hệ phương trình vi phân chuyển động của robot ba khâu không gian

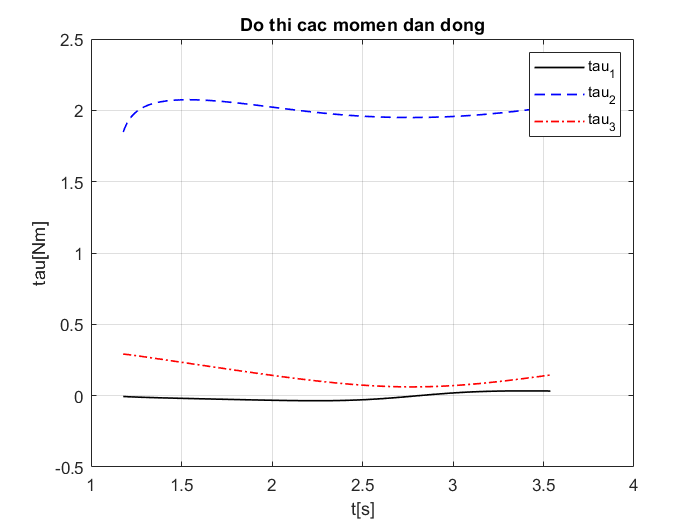
[picture p34: figure]

56

Hình 4.4: Đồ thị momen dẫn động

- Kết luận: Sau khi tính toán xong chương 4 thì ta tính được momen dẫn động

của động cơ và căn cứ vào những thông số ấy chọn được động cơ điều khiển

phù hợp với từng khâu.

57

CHƯƠNG 5: THIẾT KẾ HỆ THỐNG DẪN ĐỘNG

### 5.1. Tính toán chọn động cơ

Dựa vào phần tính toán ở chương 4 ta tìm được các momen dẫn động lớn nhất

của từng khâu:

τ1max = 0,0336Nm, τ2max = 2,07Nm, τ3max = 0,3Nm

Từ các số liệu trên ta chọn được động cơ phù hợp với các khâu

- Khâu 1: τ1max = 0,0336Nm

Ta chọn được: Động Cơ DC Giảm Tốc 5840-31ZY High Torque Self-Lock DC

Geared Motor

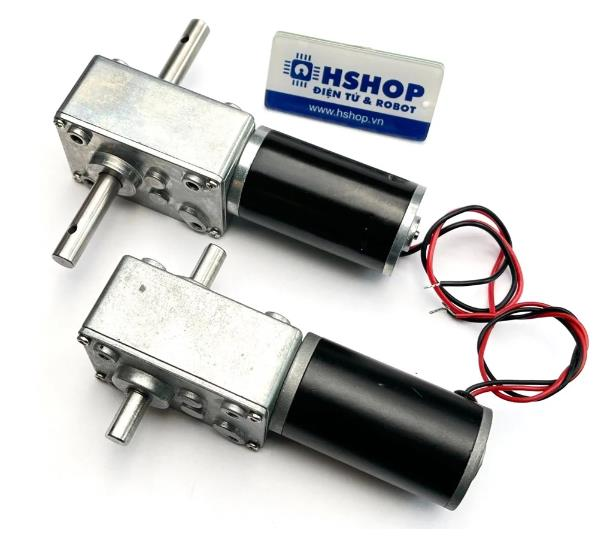
[picture p35: figure]

Hình 5.1: Động Cơ DC Giảm Tốc 5840-31ZY High Torque Self-Lock DC Geared Motor
Tỉ số truyền 31:1 (động cơ quay 31 vòng trục chính hộp giảm tốc quay 1 vòng).

58

Dòng không tải: 350mA

Dòng chịu đựng tối đa khi có tải: 6.5A

Tốc độ không tải: 260RPM (260 vòng 1 phút)

Tốc độ chịu đựng tối đa khi có tải: 200RPM (160 vòng 1 phút)

Lực kéo Moment định mức: 5KG.CM

Lực léo Moment tối đa: 8KG.CM

- Khâu 2 và khâu 3: | τ2max = 2,07Nm, | τ3max = 0,3Nm

Ta chọn được: Động Cơ NEMA 17 MT-1705HS200A

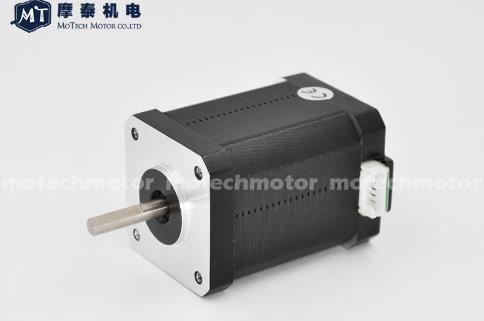
[picture p36: figure]

Hình 5.2: Động Cơ NEMA 17 MT-1705HS200A

Mô-men định mức: 8.2kg.cm (0,82Nm)

Dòng / Pha: 2.00A

Kích thước: 42*42*60mm

Kết hợp với puly tỉ số truyền 1:3 làm tăng mô-men của động cơ lên 3 lần:

M2 = MĐC. i = 0,82.3 = 2,46Nm > 2,07Nm (Thỏa mãn điều kiện cần)

59

### 5.2. Phân tích hệ thống dẫn động cho 1 khâu

Vận tốc góc mong muốn của khâu 2: n2 = 50 (vòng/pℎút).

Với: nđ – Hiệu suất bộ truyền đai răng, nđ = 0,97;

nol – Hiệu suất 1 cặp ổ lăn, nol = 0,99;

Do để đảm bảo momen điều kiện momen dẫn động em lựa chọn động cơ NEMA17

và bộ truyền đai răng bánh răng với tỷ số truyền 1:3 để thực hiện nhiệm vụ đặt ra.

Tốc độ trên động cơ: ndc = n2.3 =150 (vòng/phút)

### 5.2.1. Tính chọn pully răng

Sử dụng pully răng mua kèm với động cơ ta có thông số:

Z1 = 20 răng , Z2 =u.Z1 = 60 răng

p = 2 mm

từ thông số cho ta có:

- modun: m = p/Z = 0,6 ( chọn p = 0,6 theo tiêu chuẩn)
- Đường kính vòng chia:

d1 = m.Z1 = 12 mm

d2 = m.Z2 = 36 mm

- Đường kính đỉnh răng:

da1 = d1 + 2m = 13,2 mm

da2 = d2 + 2m = 37,2 mm

- Đường kính chân răng:

df1 = d1 – 2(m+c) = 10,4 mm

df2 = d2 – 2(m+c) = 34,4 mm

- Khoảng hở đỉnh răng:

c = (0,1÷0,3)m = 0,2 mm

60

### 5.2.2. Tính chọn đai răng

Từ thông số tính trong mục 5.2.1 ta có được mô-dun của pully bằng với mô-dun

của đai răng: md = 0,6 mm

Chiều rộng đai răng: CT 4.29 [4]-trang 69

b = (6÷9).m = 5,4 mm

Chọn b = 6 mm

Vậy độ rộng pully: B = b+m = 6,6 mm

Khoảng cách trục a:

amin = 0,5m(Z1+Z2) + 2m = 26 mm

amax = 2m(Z1+Z2) = 96 mm

amin ≤ a ≤ amax

chọn a = 95 mm

Số răng đai zđ: CT 4.30 [4]-trang 69

zđ =

2a
p

+

Z1 + Z2
2

+

(Z2 − Z1)

2p
40a

= 137,5

Chọn zđ = 138

Chiều dài đai:

lđ = π. m. zđ = 260 (mm)

Tính lại khoảng cách trục a: CT 4.6 [4]-trang 54

a =

λ − √λ
2 − 8∆

2
4

= 89,2 mm (cℎọn a = 90 mm)

Trong đó:

λ = ld −

p(z1+z2

)
2

= 180

61

∆ =

m(z2−z1)
2

= 12

Góc ôm đai: CT 4.32 [8]-trang 71

α1 = 180° − [

m(z2 − z1

)
a

]. 57,3° = 164,72°

Số răng đồng thời ăn khớp trên bánh đai nhỏ: CT 4.31 [4]-trang 71

z02 =

z1α1
360 = 9,1 (răng)

Vận tốc đai:

v =

πd1ndc
60000 = 0,1 m/s

Lực căng ban đầu: F0 = (1,1÷1,3)qmbv² = 0,02N

Chi tiết | Kí hiệu | Thông số
pully | Modun ăn khớp, mm | m = 0,6 mm
Số răng | Z1 = 20 | Z2 = 60
Đường kính đỉnh răng, mm | da1 = 13,2 mm | da2 = 37,2 mm
Đường kính đáy răng, mm | df1 = 10,4 mm | df2 = 34,4 mm
Đường kính vòng chia, mm | d1 = 12 mm | d2 = 36 mm
Chiều dài răng, mm | B = 7 mm | B = 7 mm
Đai răng | Chiều rộng đai răng, mm | b = 6 mm
| Chiều dài đai, mm | lđ = 260 mm

62

### KẾT LUẬN

Robot công nghiệp là một bộ phận rất quan trọng trong nền sản xuất hiện đại. Nó góp phần thay thế sức lao động của con người, tăng năng suất lao động và tạo ra những sản phẩm ngày càng phức tạp và đáp ứng nhu cầu ngày càng cao của con người.

Đồ án đã hoàn thành các nội dung:

- Xây dựng cấu trúc, thiết lập hệ phương trình động học của Robot
- Giải bài toán động học
- Tính toán động lực học
- Thiết kế và mô phỏng

Các hạn chế của đồ án:

- Việc tính toán thiết kế các thông số cần thiết của các chi tiết trong thiết bị.
- Khó khăn trong việc tìm các tài liệu liên quan, linh kiện phù hợp với thực tế
- Thiết kế cơ khí và lập trình điều khiển chưa đồng bộ tốt gây tốn thời gian

để điều chỉnh, chỉnh sửa không cần thiết.

- Chưa mô phỏng chuyển động được trên MATLAP

Hướng phát triển

- Cải tiến mô hình hoạt động với tốc độ hợp lý hơn, tải trọng vật nâng lớn

hơn và đảm bảo không gian hoạt động linh hoạt có thể di chuyển mọi

ngóc ngách

- Xây dựng giải thuật hoàn chỉnh hơn
- Đảm bảo khả năng sang các hướng ổn định và giảm bớt tiếng ồn
- Đưa vào những thiết bị có độ chính xác cao, phân loại phôi bằng nhiều

phương pháp: xử lí ảnh, màu,….

Qua đề tài trên em đã biết cách vận dụng những kiến thức chuyên môn được đào tạo ở trường Đại học Thủy Lợi trong thời gian qua vào với thực tế cuộc sống nhất

63

là với công nghiệp. Không chỉ vậy qua đồ án này em cũng học được rất nhiều như kĩ năng làm việc, giải quyết vấn đề, tìm tài liệu, viết báo cáo... rất có ích cho sau này.

Một lần nữa em xin chân thành cảm ơn sự hướng dẫn của thầy Nguyễn Tiến Thịnh cùng các thầy cô và các bạn sinh viên trong bộ môn đã giúp em hoàn thành bài tiểu luận này.

Em rất mong nhận được ý kiến đóng góp của các quý thầy cô và các bạn để đề tài được hoàn thiện hơn nữa.

Em xin chân thành cảm ơn!

64

### TÀI LIỆU THAM KHẢO

[1] GS.TSKH. Nguyễn Văn Khang (2023). "Cơ sở Robot công nghiệp". NXB Giáo dục Việt Nam, Hà Nội
[2] TS. Nguyễn Quang Hoàng (2019). "Cơ sở Matlab và Simulink". NXB bách khoa Hà Nội, Hà Nội
[3] Trịnh Trất – Lê Văn Uyển (2006). "Tính toán thiết kế dẫn động cơ khí tập 1". NXB Giáo dục
[4] Trịnh Trất – Lê Văn Uyển (2006). "Tính toán thiết kế dẫn động cơ khí tập 2".

NXB Giáo dục

[5] Ninh Đức Tốn (2000). “Dung sai và lắp ghép”. NXB Khoa học và kỹ thuật
[6] Các website, forum trực tuyến như www.mathworks.com, www.dientuvietnam.net, http://codientu.org ......
