AnhSinhVien/Thi-t-K-C-nh-Tay-robot-h-n-RRR/3D_slw/hop_the/2D/tachKhau/Khau0/khau0.PNG

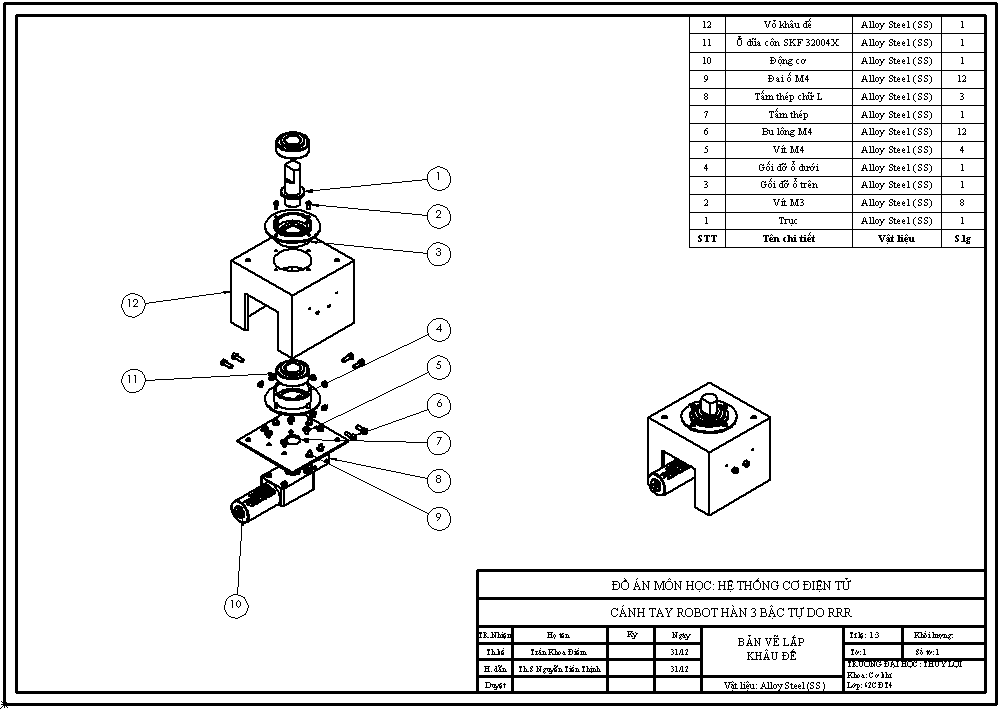
3D_slw/hop_the/2D/tachKhau/Khau0/khau0.PNG
