AnhSinhVien/Thi-t-K-C-nh-Tay-robot-h-n-RRR/3D_slw/hop_the/2D/tachKhau/Khau1/khau1.PNG

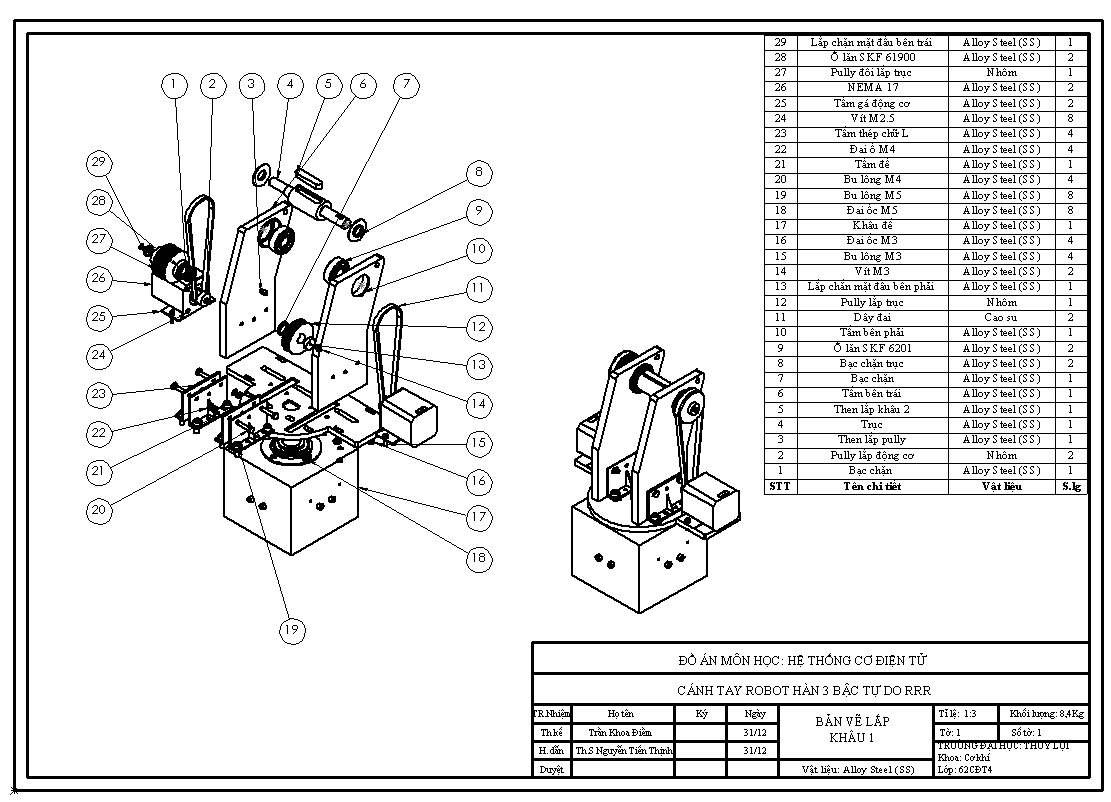
3D_slw/hop_the/2D/tachKhau/Khau1/khau1.PNG
