AnhSinhVien/Thi-t-K-C-nh-Tay-robot-h-n-RRR/3D_slw/Screenshot 2024-02-22 115818.png

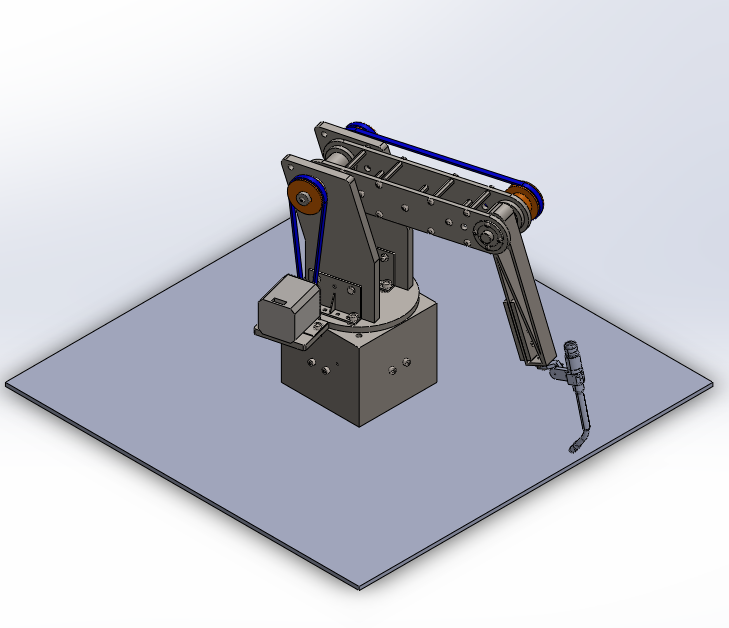
3D_slw/Screenshot 2024-02-22 115818.png
