AnhSinhVien/Thi-t-K-C-nh-Tay-robot-h-n-RRR/code_and_TinhToan/Bai_toan_nghich/ảnh/hinh2_12.png

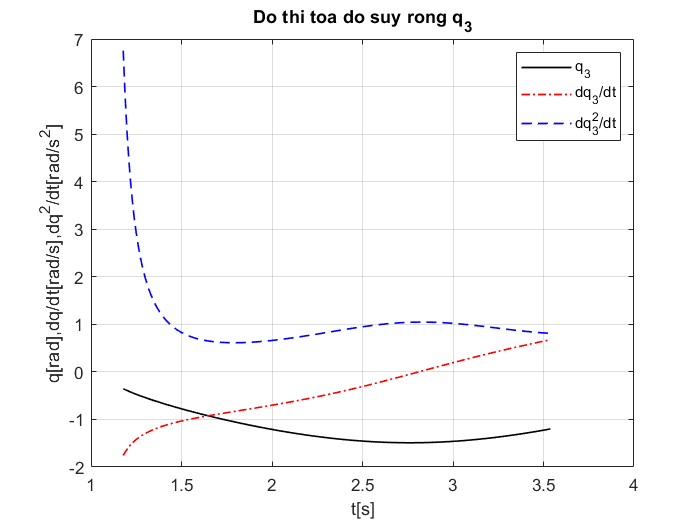
code_and_TinhToan/Bai_toan_nghich/ảnh/hinh2_12.png
