AnhSinhVien/Thi-t-K-C-nh-Tay-robot-h-n-RRR/code_and_TinhToan/Bai_toan_Thuan/ảnh/Hinh2_6.png

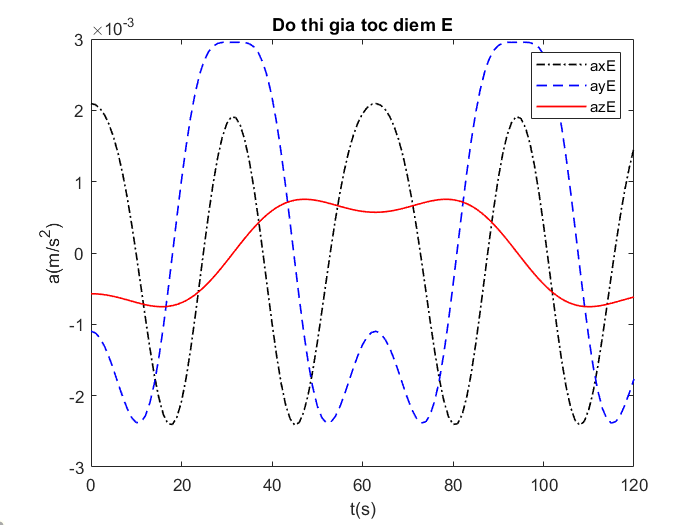
code_and_TinhToan/Bai_toan_Thuan/ảnh/Hinh2_6.png
