AnhSinhVien/Thi-t-K-C-nh-Tay-robot-h-n-RRR/3D_slw/khau0/khauDeHop.SLDASM

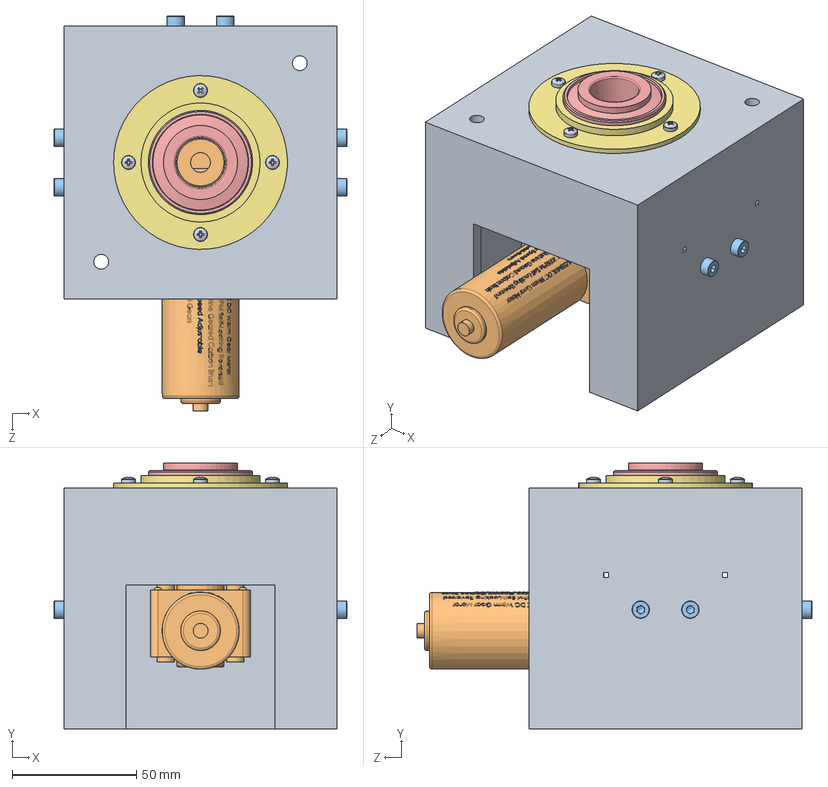
[picture p54: CAD file, 2024-02-22]
3D_slw/khau0/khauDeHop.SLDASM
118.0 x 107.0 x 159.1 mm
khau0_1_hop
khau0_BanLe1 x 3
socket head cap screw_iso x 12
hex thin nut chamfered gradeab_iso x 12
taper roller bearing_skf x 2
khau0_tam
Khau0_coclotA
Khau0_coclotB
pan head cross recess screw_iso x 12
AZSSMUK DC Worm Gear Motor 12V 200RPM Self-Locking
