AnhSinhVien/Thi-t-K-C-nh-Tay-robot-h-n-RRR/3D_slw/khau2/khau2.SLDASM

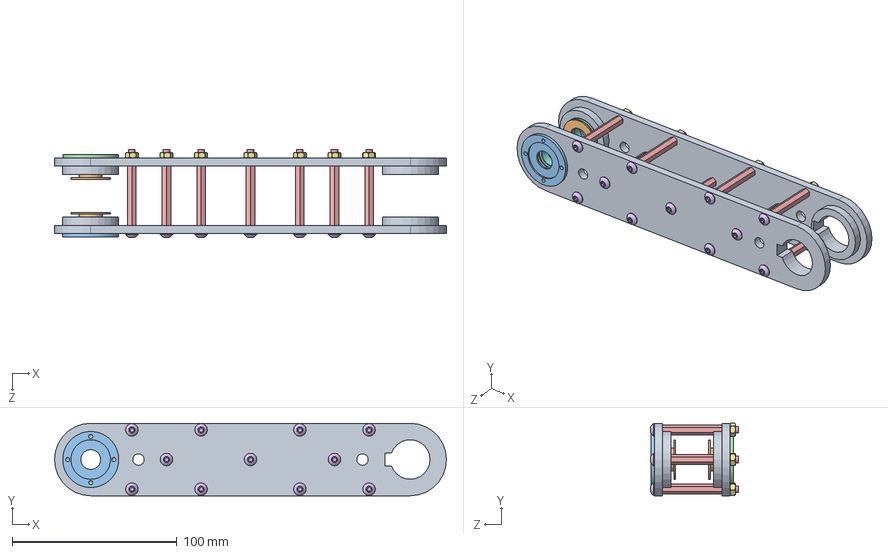
[picture p55: CAD file, 2024-02-22]
3D_slw/khau2/khau2.SLDASM
238.0 x 44.0 x 53.2 mm
khau2_1 x 2
khau2_goiTruc1 x 2
Khau2_lapO1
Khau2_lapO2
TrucVitLucGiac_M4x46mm x 11
socket button head screw_iso x 11
hex nut style 1 gradeab_iso x 11
radial ball bearing_68_skf x 2
