AnhSinhVien/Thi-t-K-C-nh-Tay-robot-h-n-RRR/3D_slw/khau1/khau1.SLDASM

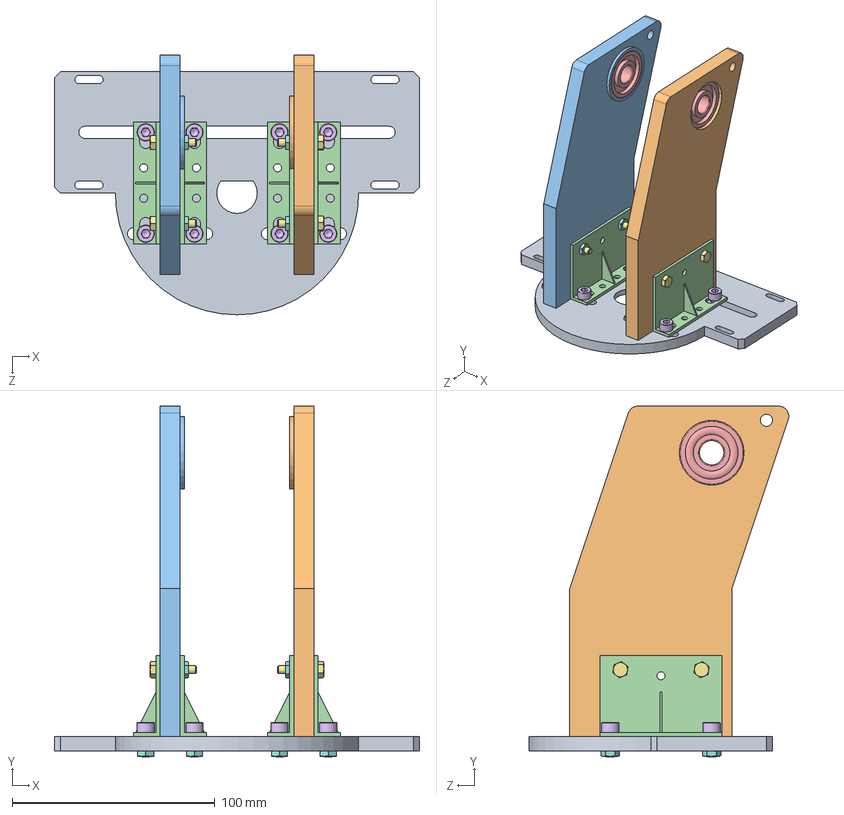
[picture p56: CAD file, 2024-02-22]
3D_slw/khau1/khau1.SLDASM
180.0 x 173.0 x 128.0 mm
Khau1_1
Khau1_1A
Khau1_1B
Khau1_banle1 x 4
radial ball bearing_68_skf x 2
socket head cap screw_iso x 8
hex bolt gradeb_iso x 4
hex thin nut chamfered gradeab_iso x 12
