AnhSinhVien/Thi-t-K-C-nh-Tay-robot-h-n-RRR/3D_slw/khau3_kieu2/khau3.SLDASM

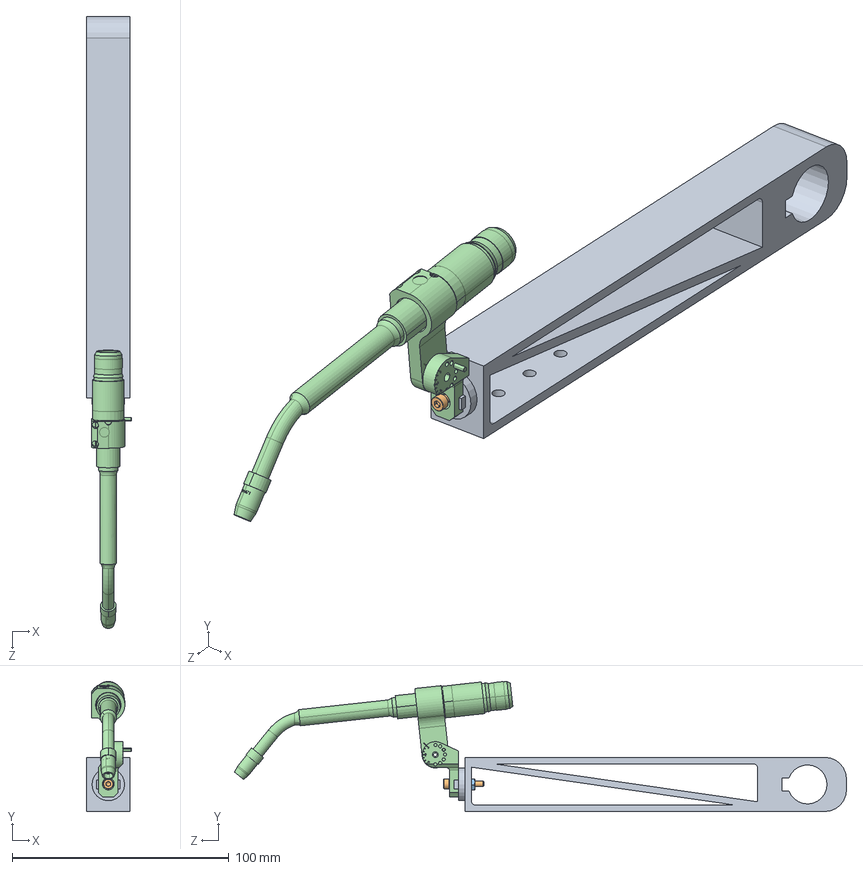
[picture p57: CAD file, 2024-02-22]
3D_slw/khau3_kieu2/khau3.SLDASM
20.6 x 60.0 x 282.2 mm
khau3
socket head cap screw_iso
hex thin nut chamfered gradeab_iso
lapmohan1p
