AnhSinhVien/Thi-t-K-C-nh-Tay-robot-h-n-RRR/3D_slw/khau1/khau1_gop.SLDASM

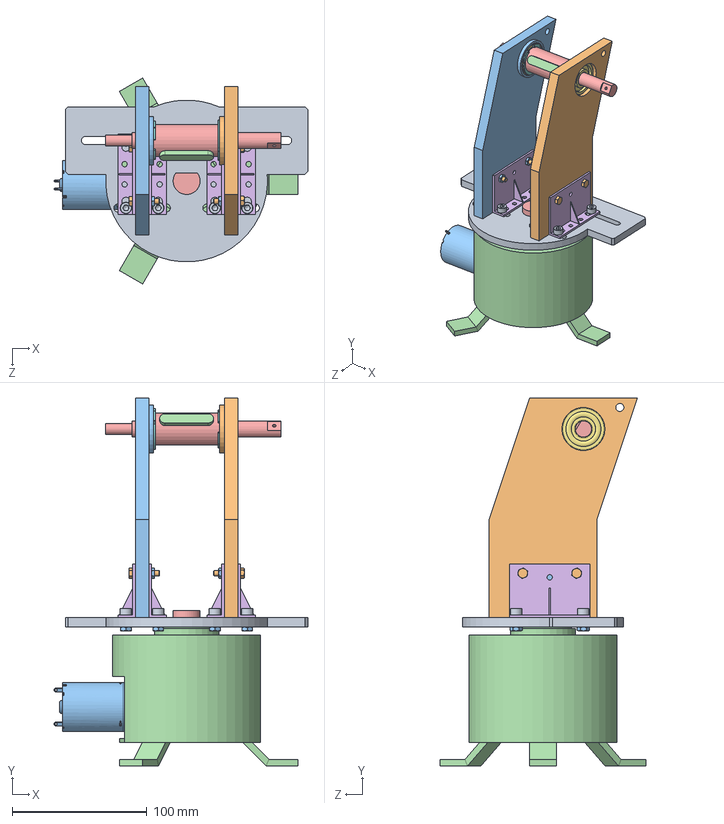
[picture p58: CAD file, 2024-02-22]
3D_slw/khau1/khau1_gop.SLDASM
188.3 x 273.0 x 152.9 mm
Khau1_1
Khau1_1A
Khau1_1B
khau1_then
Khau1_truc
Khau1_banle1 x 4
radial ball bearing_68_skf x 3
inverted internal retaining ring_wti x 2
socket head cap screw_iso x 8
hex bolt gradeb_iso x 4
hex thin nut chamfered gradeab_iso x 12
khau0_1
Khau0_truc
gearbox-case-output
gearbox-case-input
M2-04-6-92000A013_18-8 SS METRIC PAN HEAD PHIL MACHINE SCREW x 4
Amazon-gearmotor-bushing
Amazon-gearmotor-shaft
Amazon-gearmotor-motor
taper roller bearing_skf
