AnhSinhVien/Thi-t-K-C-nh-Tay-robot-h-n-RRR/3D_slw/khau0/tsiny-gear-box-motor-1.snapshot.4/Amazon-gearmotor.STEP

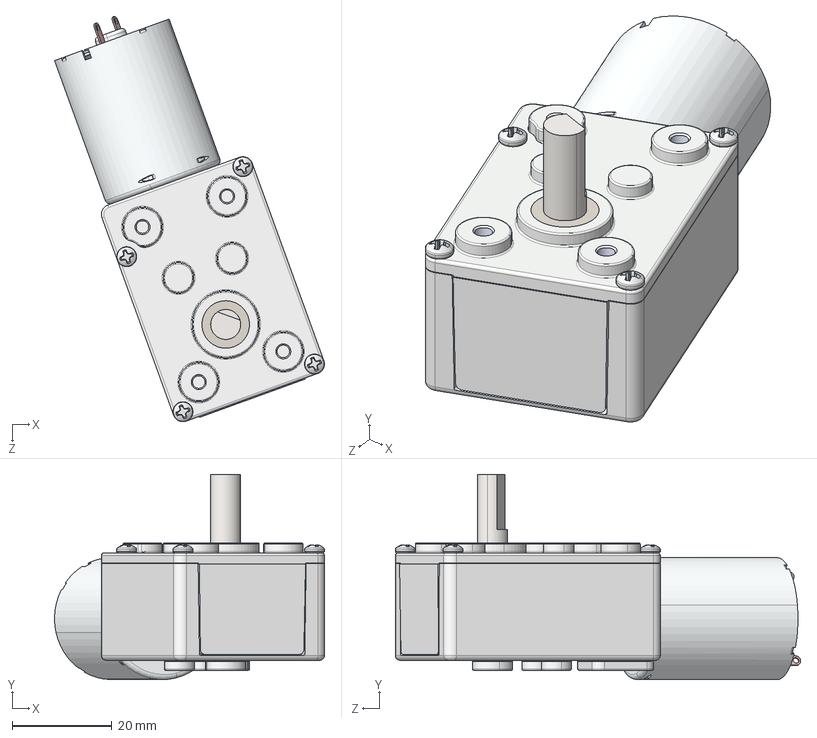
[picture p59: CAD file, 2024-02-22]
3D_slw/khau0/tsiny-gear-box-motor-1.snapshot.4/Amazon-gearmotor.STEP
54.0 x 41.0 x 81.1 mm
gearbox-case-output
gearbox-case-input
M2-04-6-92000A013_18-8 SS METRIC PAN HEAD PHIL MACHINE SCREW_92000A013 x 4
Amazon-gearmotor-bushing
Amazon-gearmotor-shaft
Amazon-gearmotor-motor
