AnhSinhVien/Thi-t-K-C-nh-Tay-robot-h-n-RRR/3D_slw/khau0/khau0_1_hop.SLDPRT

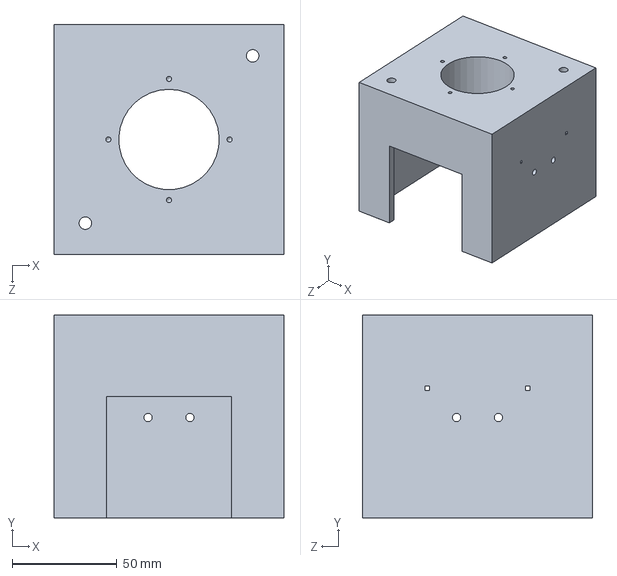
[picture p61: CAD file, 2024-02-22]
3D_slw/khau0/khau0_1_hop.SLDPRT
110.0 x 97.0 x 110.0 mm
