AnhSinhVien/Thi-t-K-C-nh-Tay-robot-h-n-RRR/3D_slw/khau0/tsiny-gear-box-motor-1.snapshot.4/gearbox-case-output.SLDPRT

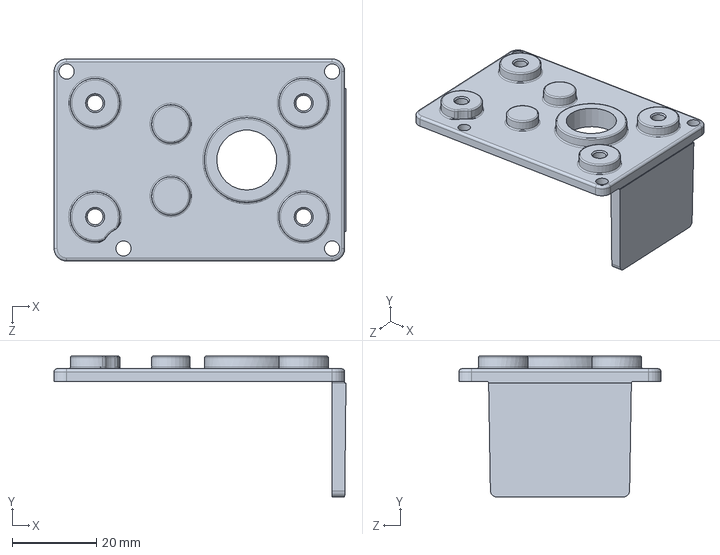
[picture p62: CAD file, 2024-02-22]
3D_slw/khau0/tsiny-gear-box-motor-1.snapshot.4/gearbox-case-output.SLDPRT
69.3 x 33.5 x 48.0 mm
