AnhSinhVien/Thi-t-K-C-nh-Tay-robot-h-n-RRR/3D_slw/khau1/Khau1_bacnot_puly.SLDPRT

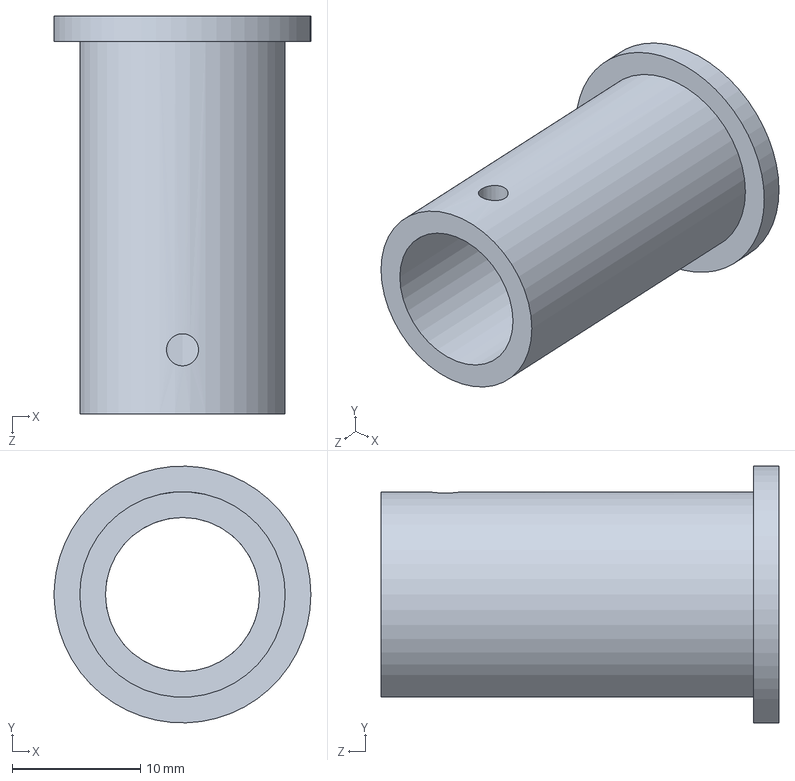
[picture p63: CAD file, 2024-02-22]
3D_slw/khau1/Khau1_bacnot_puly.SLDPRT
20.0 x 20.0 x 31.0 mm
