AnhSinhVien/Thi-t-K-C-nh-Tay-robot-h-n-RRR/3D_slw/khau2/TrucVitLucGiac_M4x46mm.SLDPRT

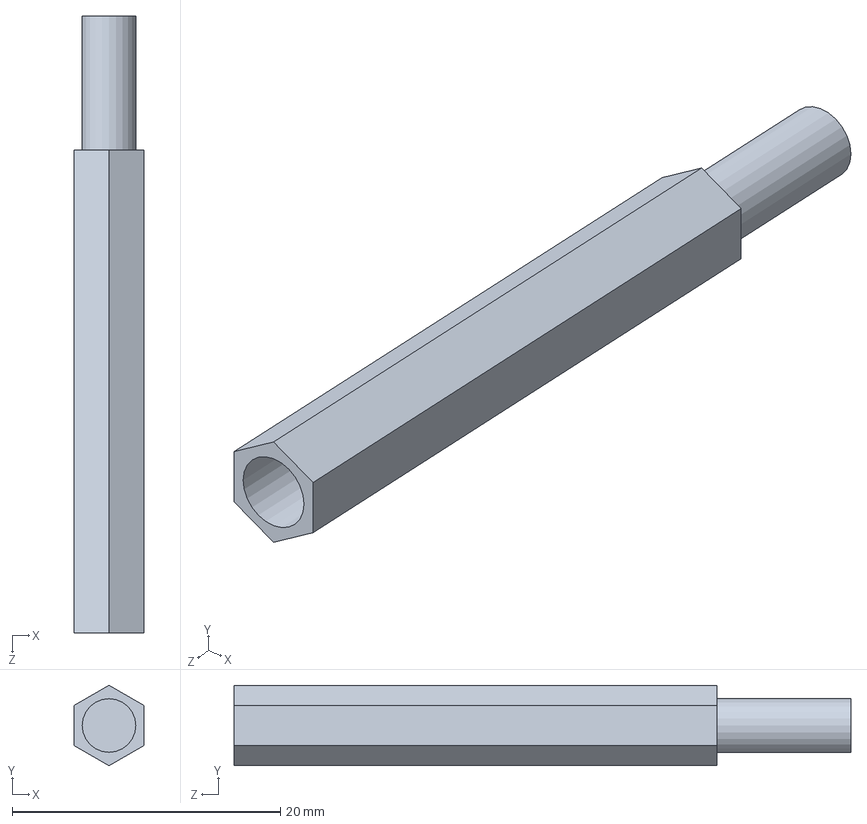
[picture p64: CAD file, 2024-02-22]
3D_slw/khau2/TrucVitLucGiac_M4x46mm.SLDPRT
5.20 x 6.00 x 46.0 mm
