AnhSinhVien/Thi-t-K-C-nh-Tay-robot-h-n-RRR/3D_slw/khau3_kieu2/lapmohan1.STEP

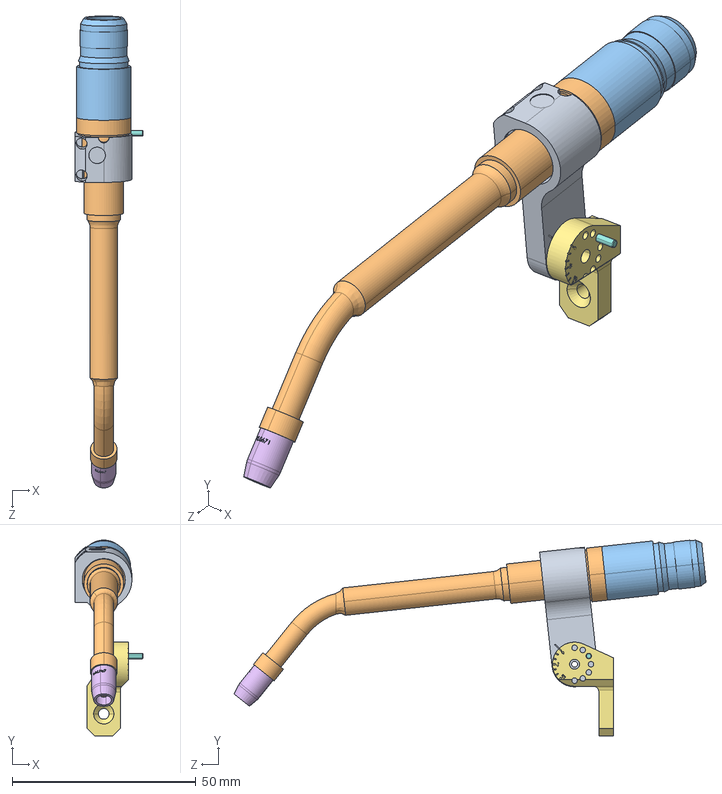
[picture p65: CAD file, 2024-02-22]
3D_slw/khau3_kieu2/lapmohan1.STEP
18.5 x 53.3 x 128.4 mm
lock
