AnhSinhVien/Thi-t-K-C-nh-Tay-robot-h-n-RRR/3D_slw/khau0/banlamviec.SLDPRT

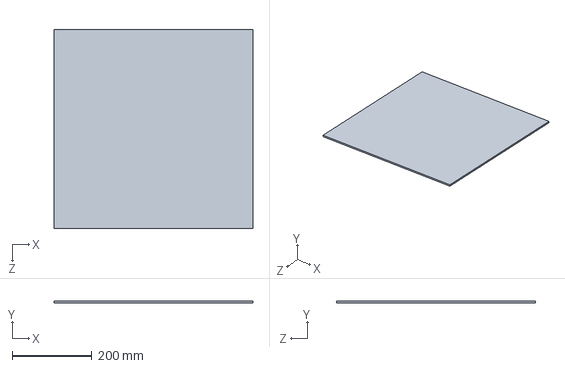
[picture p66: CAD file, 2024-02-22]
3D_slw/khau0/banlamviec.SLDPRT
500.0 x 5.00 x 500.0 mm
