AnhSinhVien/Thi-t-K-C-nh-Tay-robot-h-n-RRR/3D_slw/khau0/tsiny-gear-box-motor-1.snapshot.4/Amazon-gearmotor-shaft.SLDPRT

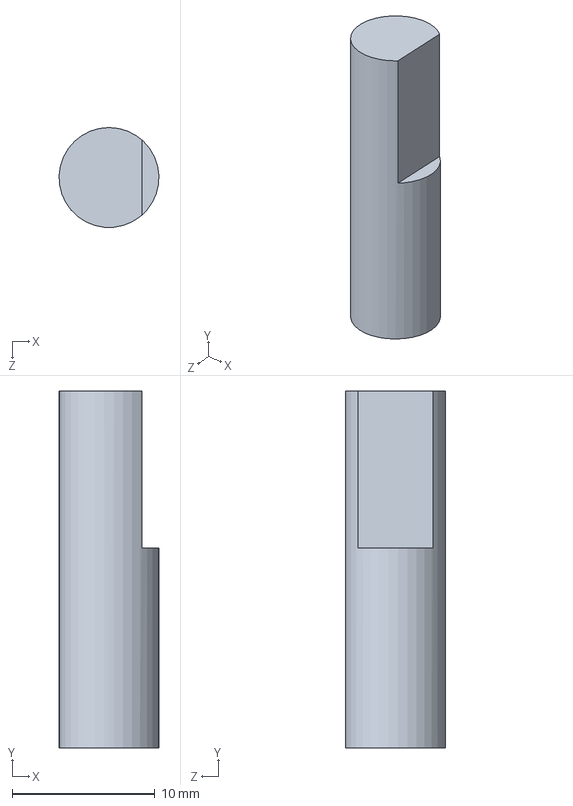
[picture p67: CAD file, 2024-02-22]
3D_slw/khau0/tsiny-gear-box-motor-1.snapshot.4/Amazon-gearmotor-shaft.SLDPRT
6.99 x 25.0 x 7.00 mm
