AnhSinhVien/Thi-t-K-C-nh-Tay-robot-h-n-RRR/3D_slw/khau1/Khau1_puley_gt2_60teeth_double.SLDPRT

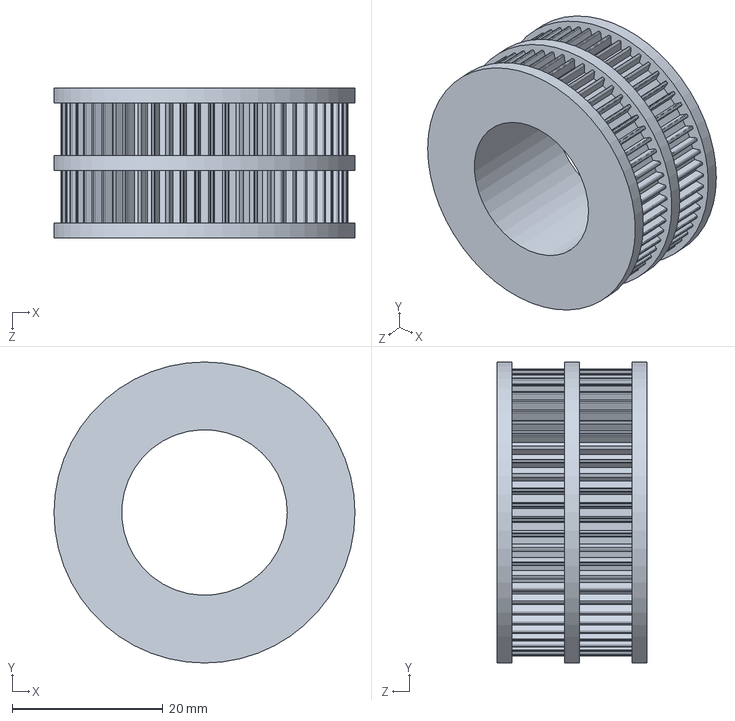
[picture p68: CAD file, 2024-02-22]
3D_slw/khau1/Khau1_puley_gt2_60teeth_double.SLDPRT
40.0 x 40.0 x 20.0 mm
