AnhSinhVien/Thi-t-K-C-nh-Tay-robot-h-n-RRR/3D_slw/khau2/khau2_1.SLDPRT

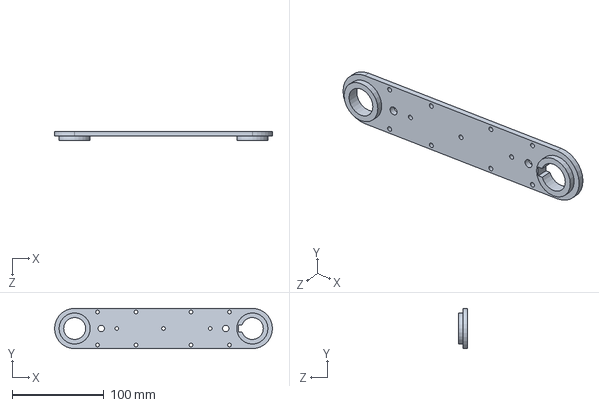
[picture p69: CAD file, 2024-02-22]
3D_slw/khau2/khau2_1.SLDPRT
238.0 x 44.0 x 10.0 mm
