AnhSinhVien/Thi-t-K-C-nh-Tay-robot-h-n-RRR/3D_slw/khau3_kieu2/demThem.SLDPRT

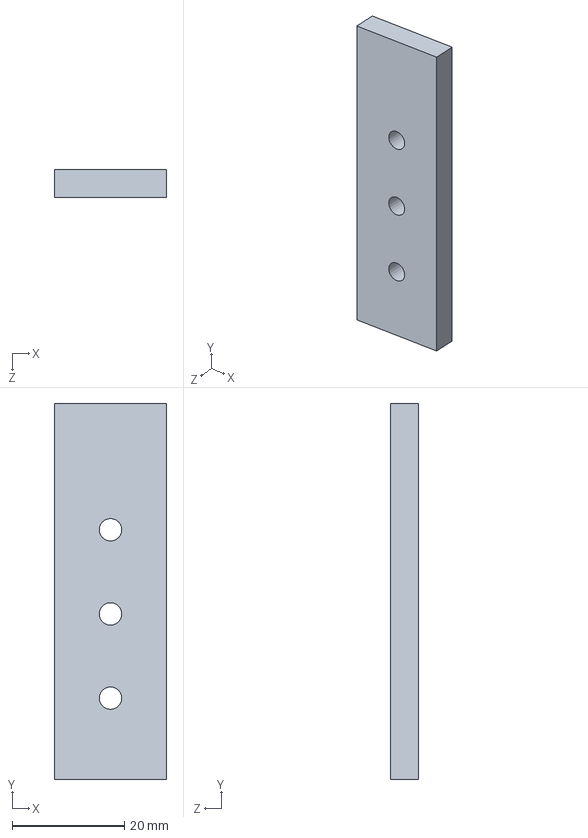
[picture p70: CAD file, 2024-02-22]
3D_slw/khau3_kieu2/demThem.SLDPRT
20.0 x 67.0 x 5.00 mm
