AnhSinhVien/Thi-t-K-C-nh-Tay-robot-h-n-RRR/3D_slw/khau0/khau0_BanLe1.SLDPRT

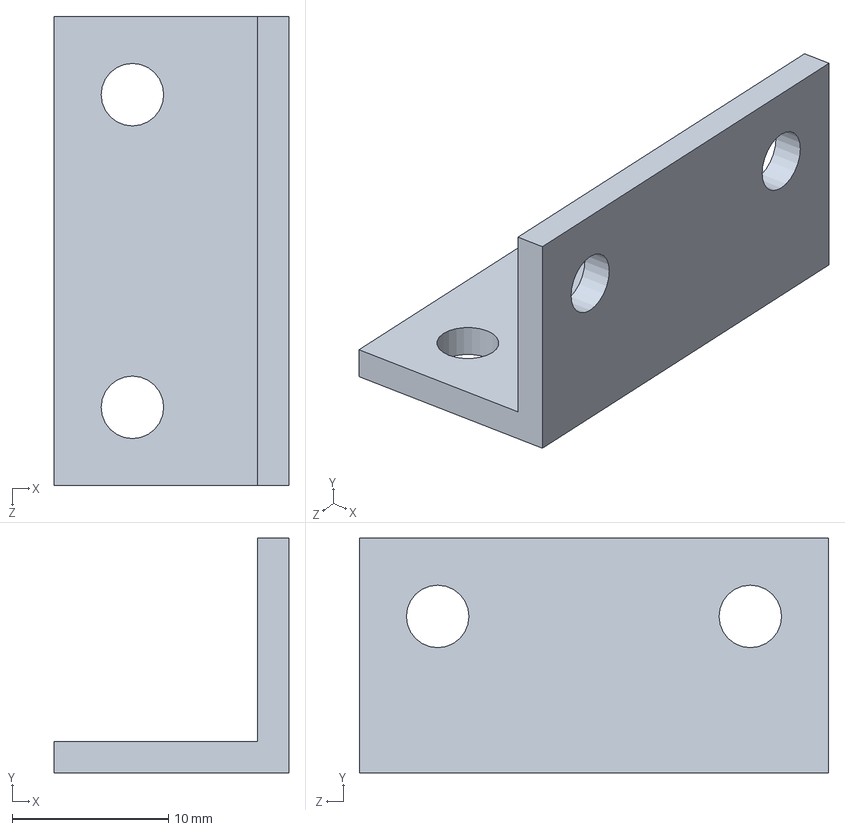
[picture p71: CAD file, 2024-02-22]
3D_slw/khau0/khau0_BanLe1.SLDPRT
15.0 x 15.0 x 30.0 mm
