AnhSinhVien/Thi-t-K-C-nh-Tay-robot-h-n-RRR/3D_slw/khau0/tsiny-gear-box-motor-1.snapshot.4/gearbox-case-input.SLDPRT

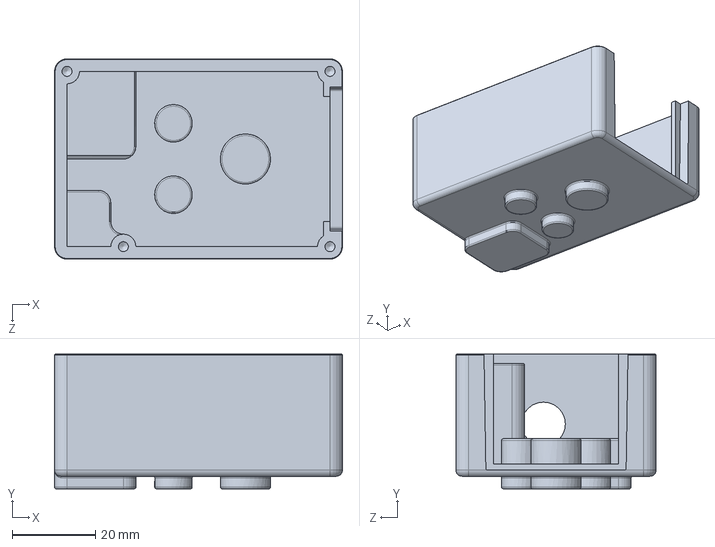
[picture p72: CAD file, 2024-02-22]
3D_slw/khau0/tsiny-gear-box-motor-1.snapshot.4/gearbox-case-input.SLDPRT
69.0 x 32.2 x 48.0 mm
