AnhSinhVien/Thi-t-K-C-nh-Tay-robot-h-n-RRR/3D_slw/khau1/khau1_demngoai.SLDPRT

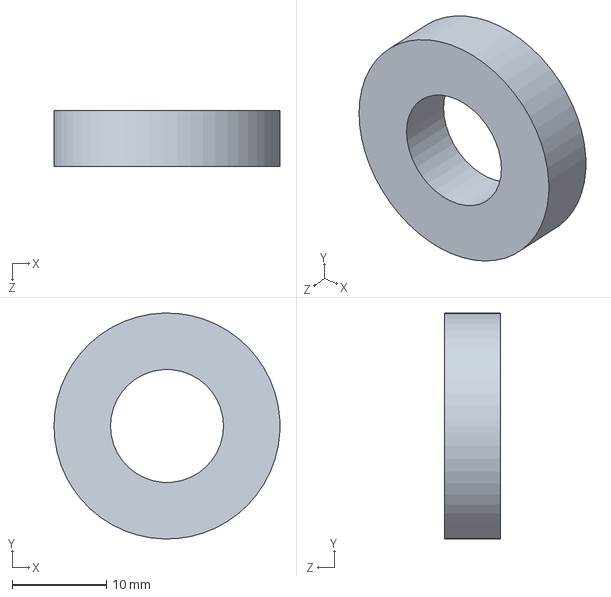
[picture p73: CAD file, 2024-02-22]
3D_slw/khau1/khau1_demngoai.SLDPRT
24.0 x 24.0 x 6.00 mm
