AnhSinhVien/Thi-t-K-C-nh-Tay-robot-h-n-RRR/3D_slw/khau2/khau2_then.SLDPRT

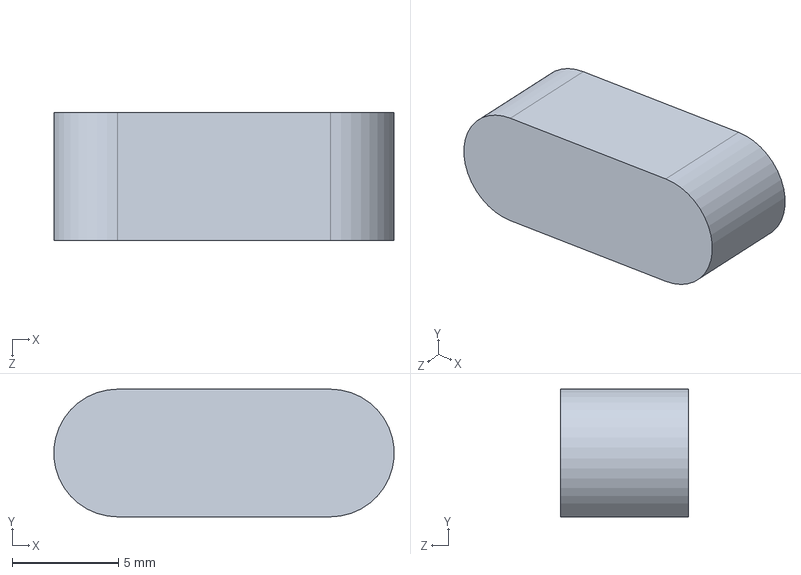
[picture p74: CAD file, 2024-02-22]
3D_slw/khau2/khau2_then.SLDPRT
16.0 x 6.00 x 6.00 mm
