AnhSinhVien/Thi-t-K-C-nh-Tay-robot-h-n-RRR/3D_slw/khau0/Khau0_coclotA.SLDPRT

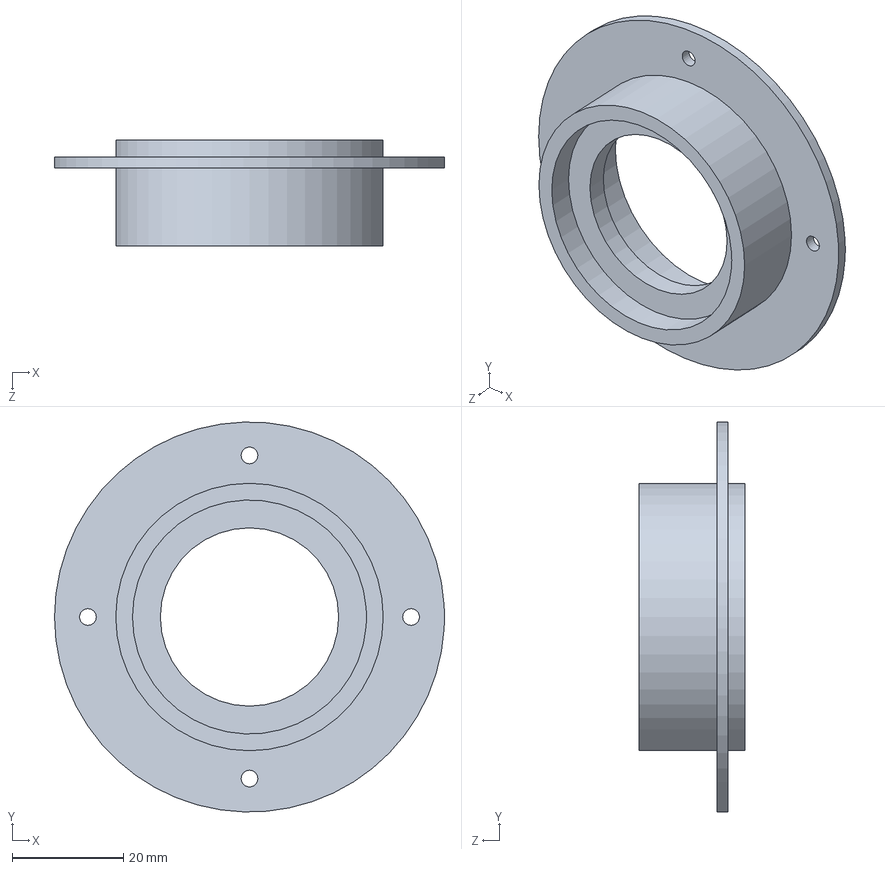
[picture p75: CAD file, 2024-02-22]
3D_slw/khau0/Khau0_coclotA.SLDPRT
70.0 x 70.0 x 19.0 mm
