AnhSinhVien/Thi-t-K-C-nh-Tay-robot-h-n-RRR/3D_slw/khau2/Khau2_puley_gt1_60teeth_double.SLDPRT

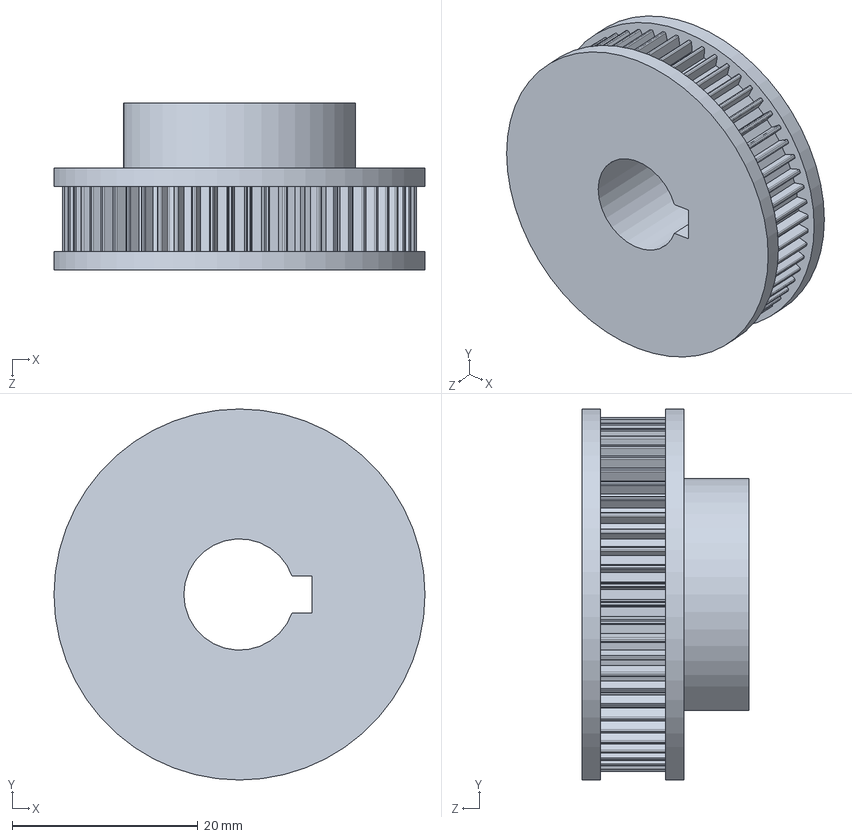
[picture p76: CAD file, 2024-02-22]
3D_slw/khau2/Khau2_puley_gt1_60teeth_double.SLDPRT
40.0 x 40.0 x 18.0 mm
