AnhSinhVien/Thi-t-K-C-nh-Tay-robot-h-n-RRR/3D_slw/khau0/Khau0_truc.SLDPRT

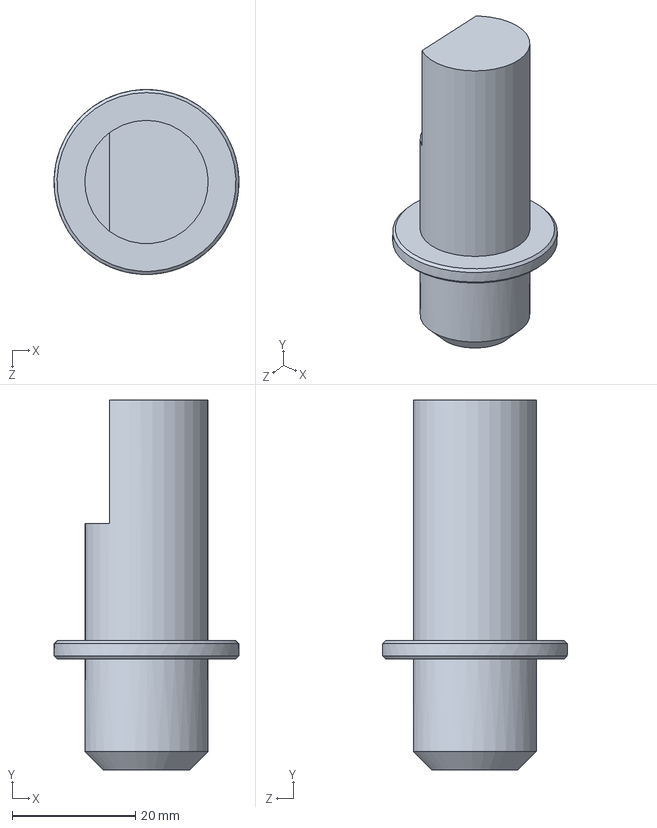
[picture p77: CAD file, 2024-02-22]
3D_slw/khau0/Khau0_truc.SLDPRT
30.0 x 60.0 x 30.0 mm
