AnhSinhVien/Thi-t-K-C-nh-Tay-robot-h-n-RRR/3D_slw/khau0/tsiny-gear-box-motor-1.snapshot.4/Amazon-gearmotor-bushing.SLDPRT

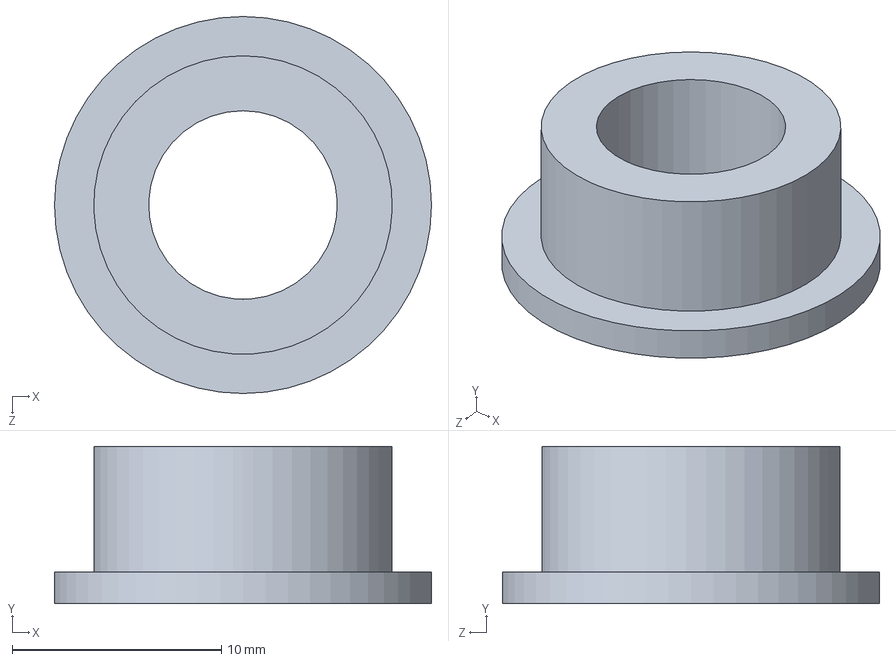
[picture p78: CAD file, 2024-02-22]
3D_slw/khau0/tsiny-gear-box-motor-1.snapshot.4/Amazon-gearmotor-bushing.SLDPRT
18.0 x 7.50 x 18.0 mm
