AnhSinhVien/Thi-t-K-C-nh-Tay-robot-h-n-RRR/3D_slw/khau1/Khau1_truc.SLDPRT

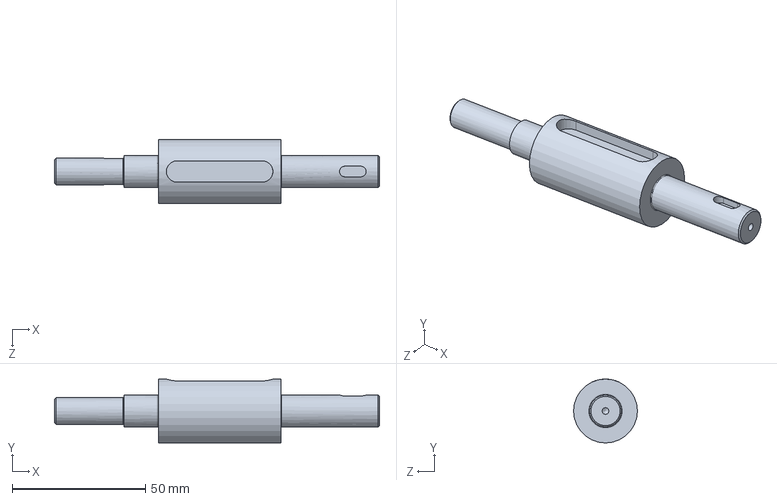
[picture p79: CAD file, 2024-02-22]
3D_slw/khau1/Khau1_truc.SLDPRT
122.0 x 24.0 x 24.0 mm
