AnhSinhVien/Thi-t-K-C-nh-Tay-robot-h-n-RRR/3D_slw/khau0/tsiny-gear-box-motor-1.snapshot.4/Amazon-gearmotor-motor.SLDPRT

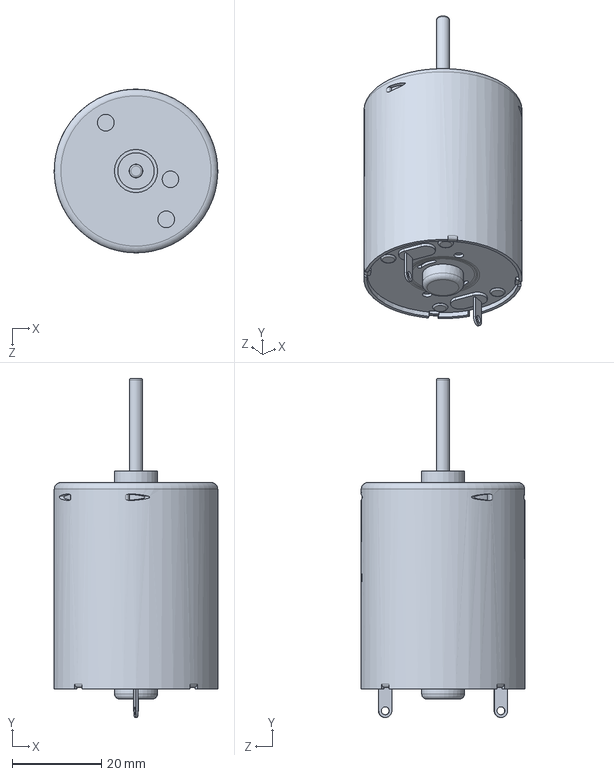
[picture p82: CAD file, 2024-02-22]
3D_slw/khau0/tsiny-gear-box-motor-1.snapshot.4/Amazon-gearmotor-motor.SLDPRT
36.6 x 75.8 x 36.6 mm
