AnhSinhVien/Thi-t-K-C-nh-Tay-robot-h-n-RRR/3D_slw/khau1/Khau1_banle1.SLDPRT

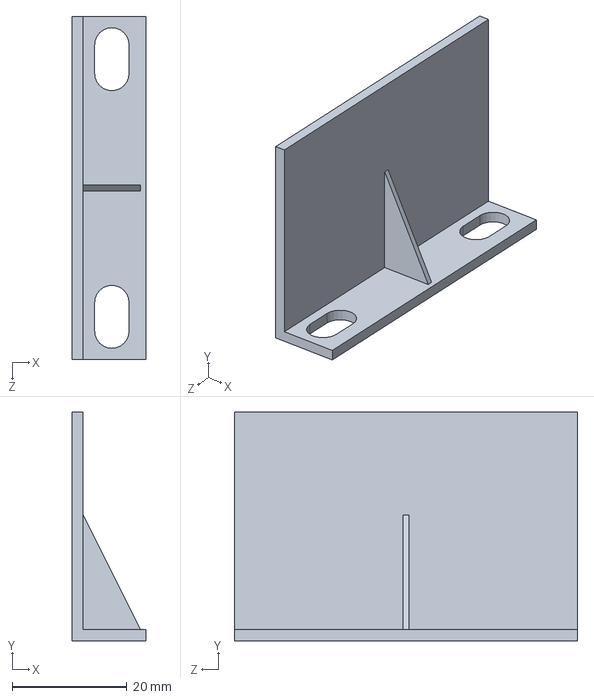
[picture p83: CAD file, 2024-02-22]
3D_slw/khau1/Khau1_banle1.SLDPRT
13.0 x 40.0 x 60.0 mm
