AnhSinhVien/Thi-t-K-C-nh-Tay-robot-h-n-RRR/3D_slw/khau2/khau2_goiTruc1.SLDPRT

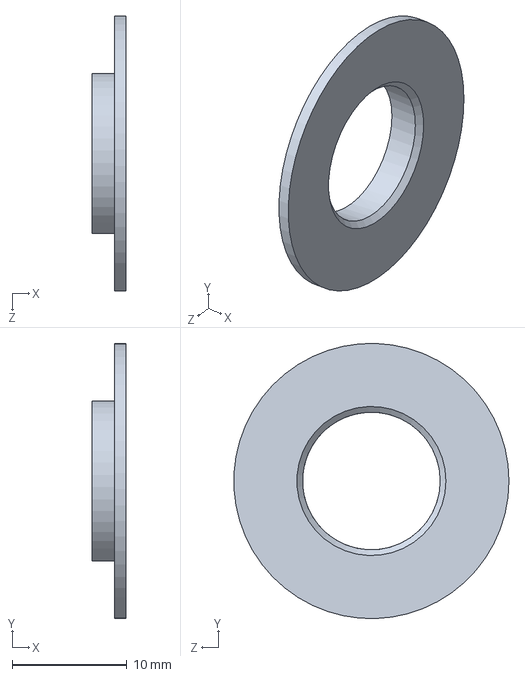
[picture p84: CAD file, 2024-02-22]
3D_slw/khau2/khau2_goiTruc1.SLDPRT
3.00 x 24.0 x 24.0 mm
