AnhSinhVien/Thi-t-K-C-nh-Tay-robot-h-n-RRR/3D_slw/khau0/khau0_tam.SLDPRT

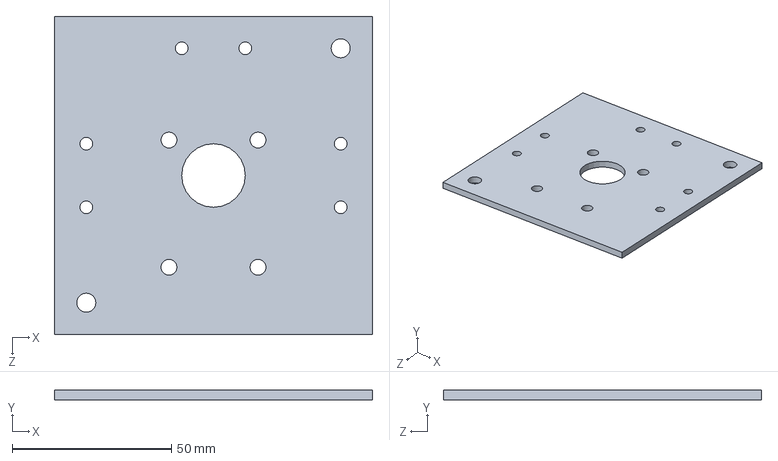
[picture p85: CAD file, 2024-02-22]
3D_slw/khau0/khau0_tam.SLDPRT
100.0 x 3.00 x 100.0 mm
