AnhSinhVien/Thi-t-K-C-nh-Tay-robot-h-n-RRR/3D_slw/khau1/Khau1_thenPully.SLDPRT

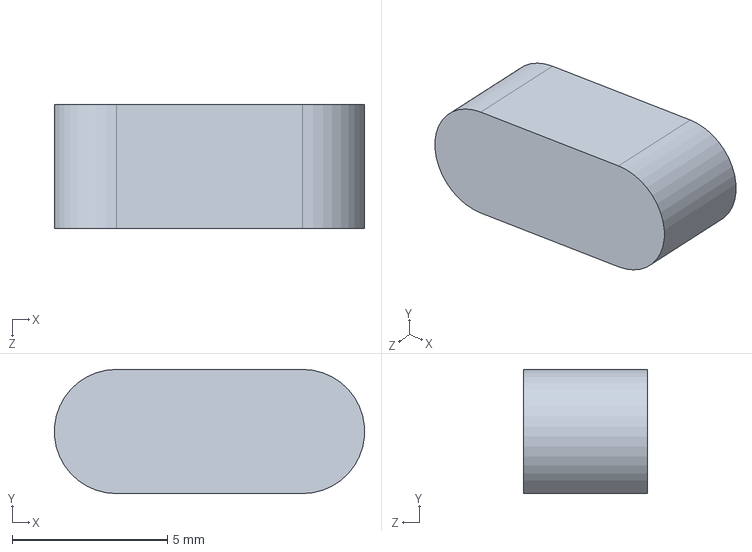
[picture p86: CAD file, 2024-02-22]
3D_slw/khau1/Khau1_thenPully.SLDPRT
9.99 x 4.00 x 4.00 mm
