AnhSinhVien/Thi-t-K-C-nh-Tay-robot-h-n-RRR/3D_slw/khau2/Khau2_lapO2.SLDPRT

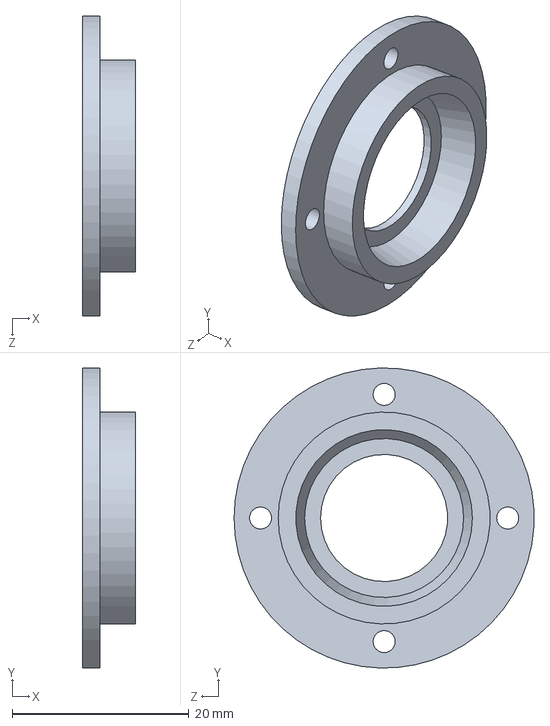
[picture p87: CAD file, 2024-02-22]
3D_slw/khau2/Khau2_lapO2.SLDPRT
6.00 x 34.0 x 34.0 mm
