AnhSinhVien/Thi-t-K-C-nh-Tay-robot-h-n-RRR/3D_slw/khau1/Khau1_1.SLDPRT

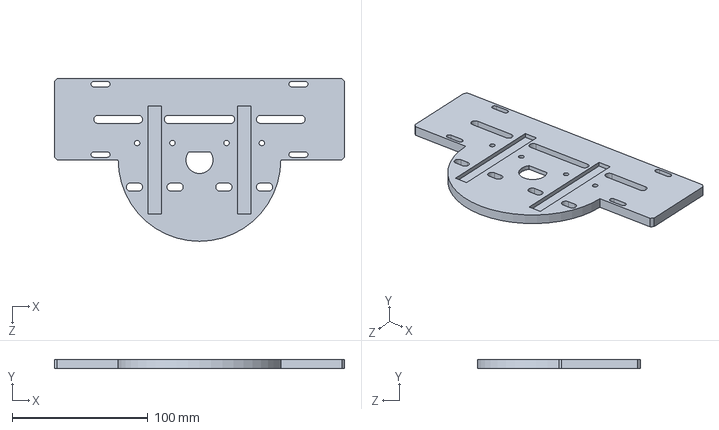
[picture p88: CAD file, 2024-02-22]
3D_slw/khau1/Khau1_1.SLDPRT
214.0 x 7.00 x 120.0 mm
