AnhSinhVien/Thi-t-K-C-nh-Tay-robot-h-n-RRR/3D_slw/khau2/khau2_truc2.SLDPRT

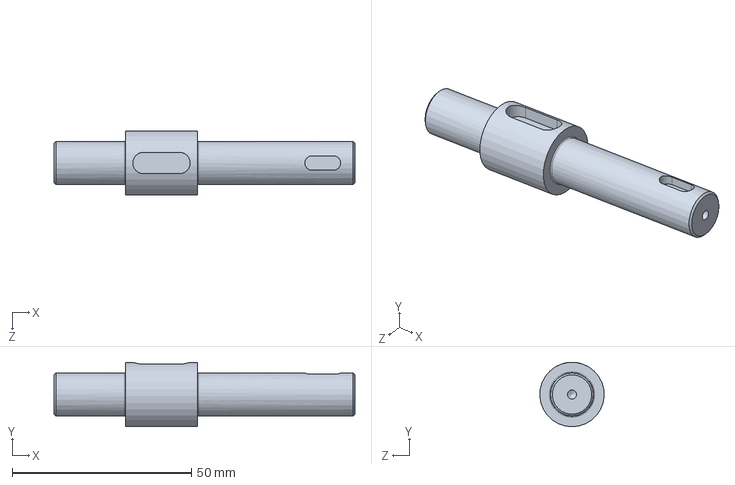
[picture p89: CAD file, 2024-02-22]
3D_slw/khau2/khau2_truc2.SLDPRT
84.0 x 18.0 x 18.0 mm
