AnhSinhVien/Thi-t-K-C-nh-Tay-robot-h-n-RRR/3D_slw/khau3_kieu2/Khau3_bacchan.SLDPRT

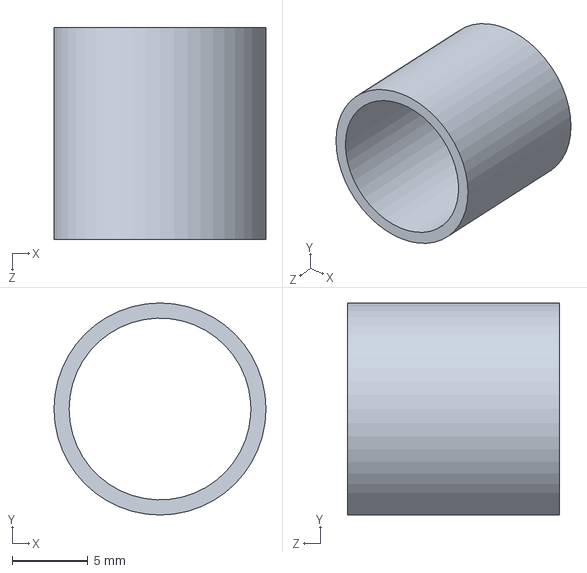
[picture p90: CAD file, 2024-02-22]
3D_slw/khau3_kieu2/Khau3_bacchan.SLDPRT
14.0 x 14.0 x 14.0 mm
