AnhSinhVien/Thi-t-K-C-nh-Tay-robot-h-n-RRR/3D_slw/khau1/Khau1_1B.SLDPRT

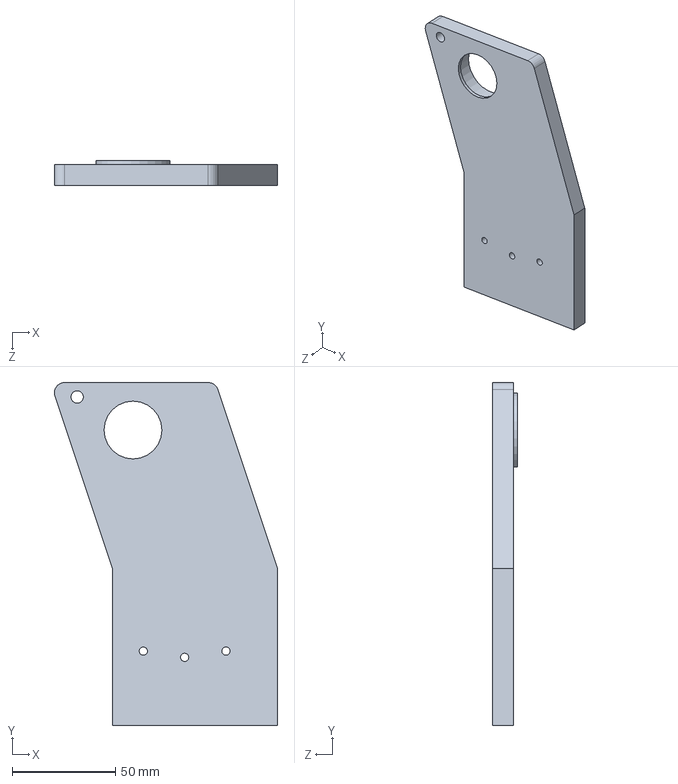
[picture p91: CAD file, 2024-02-22]
3D_slw/khau1/Khau1_1B.SLDPRT
108.0 x 166.0 x 12.0 mm
