AnhSinhVien/Thi-t-K-C-nh-Tay-robot-h-n-RRR/3D_slw/khau3_kieu2/khau3_chanpully.SLDPRT

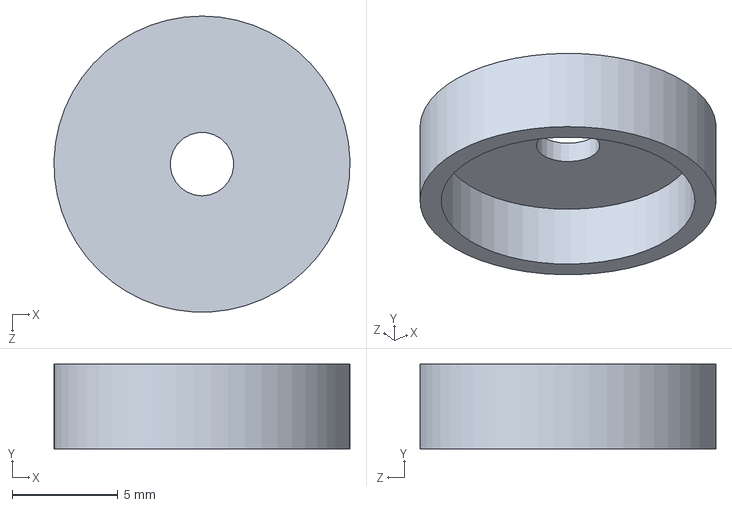
[picture p92: CAD file, 2024-02-22]
3D_slw/khau3_kieu2/khau3_chanpully.SLDPRT
14.0 x 4.00 x 14.0 mm
