AnhSinhVien/Thi-t-K-C-nh-Tay-robot-h-n-RRR/3D_slw/khau1/khau1_then.SLDPRT

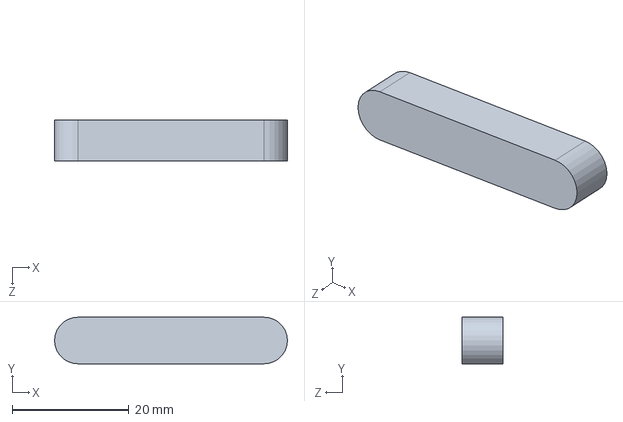
[picture p93: CAD file, 2024-02-22]
3D_slw/khau1/khau1_then.SLDPRT
40.0 x 8.00 x 7.00 mm
