AnhSinhVien/Thi-t-K-C-nh-Tay-robot-h-n-RRR/3D_slw/khau1/khau1_khoaTrucB.SLDPRT

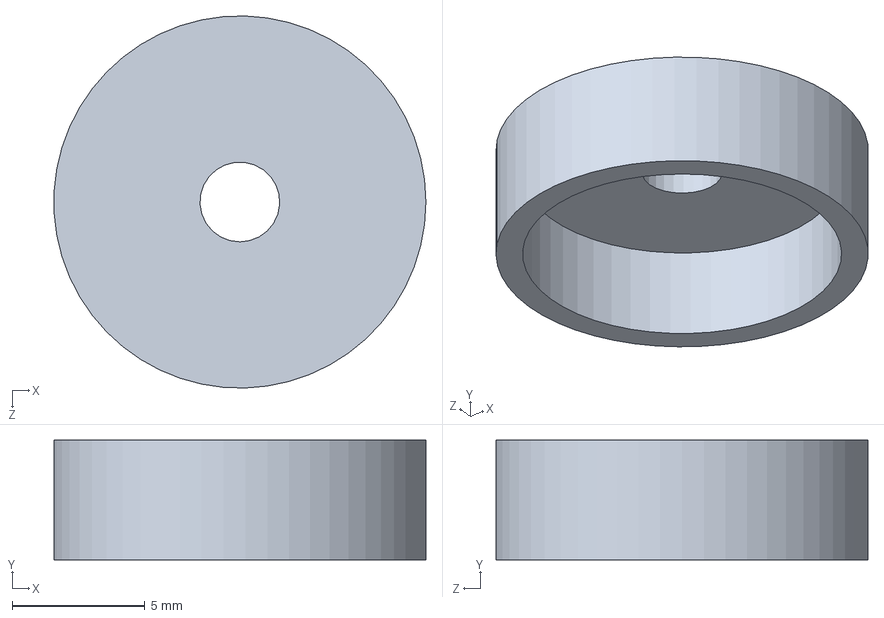
[picture p94: CAD file, 2024-02-22]
3D_slw/khau1/khau1_khoaTrucB.SLDPRT
14.0 x 4.50 x 14.0 mm
