AnhSinhVien/Thi-t-K-C-nh-Tay-robot-h-n-RRR/3D_slw/khau1/Khau1_banlestep.SLDPRT

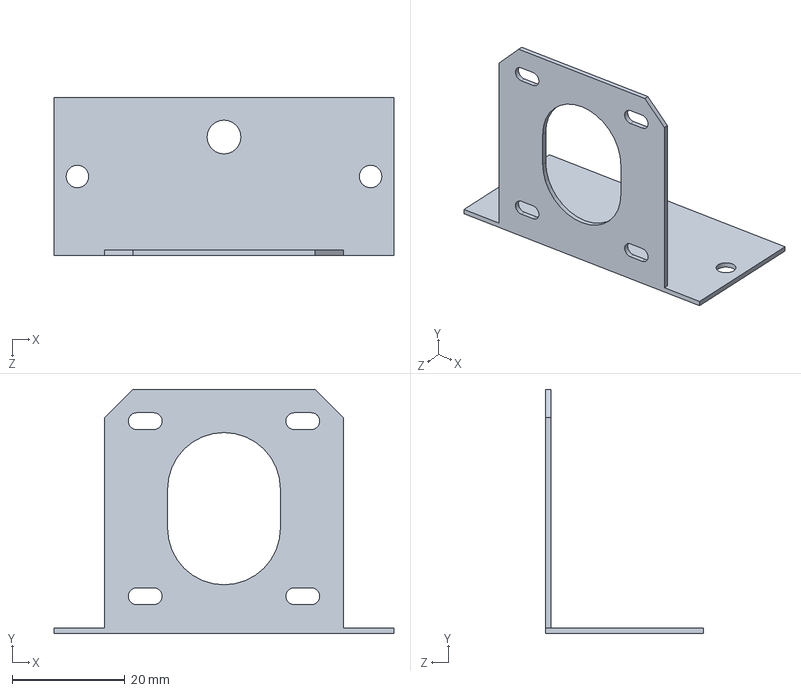
[picture p95: CAD file, 2024-02-22]
3D_slw/khau1/Khau1_banlestep.SLDPRT
60.3 x 43.3 x 28.0 mm
