AnhSinhVien/Thi-t-K-C-nh-Tay-robot-h-n-RRR/3D_slw/khau1/Khau1_DC_step42x35.SLDPRT

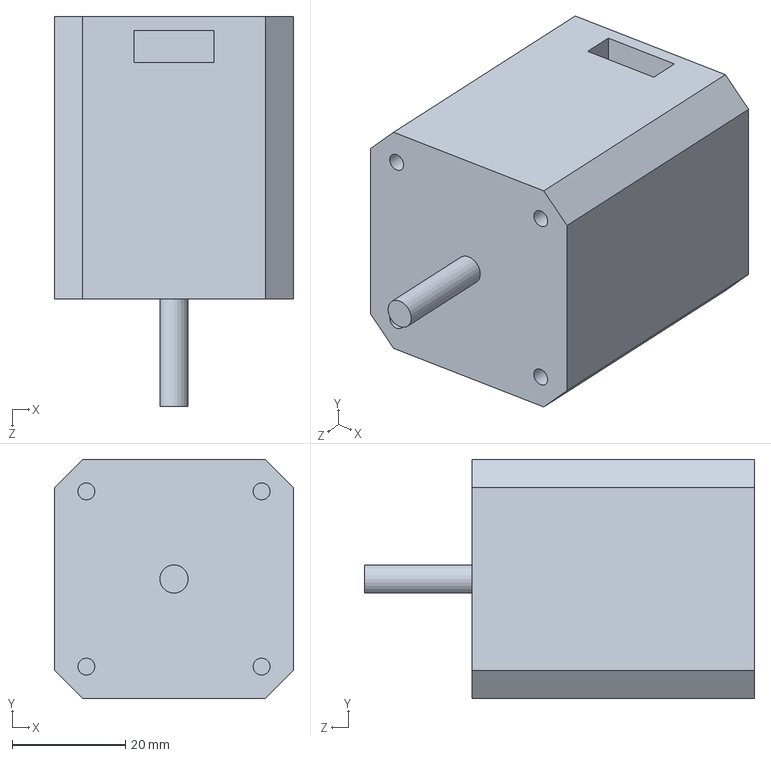
[picture p96: CAD file, 2024-02-22]
3D_slw/khau1/Khau1_DC_step42x35.SLDPRT
42.3 x 42.3 x 69.0 mm
