AnhSinhVien/Thi-t-K-C-nh-Tay-robot-h-n-RRR/3D_slw/khau1/Khau1_puly_gt2_20rang_5mm.SLDPRT

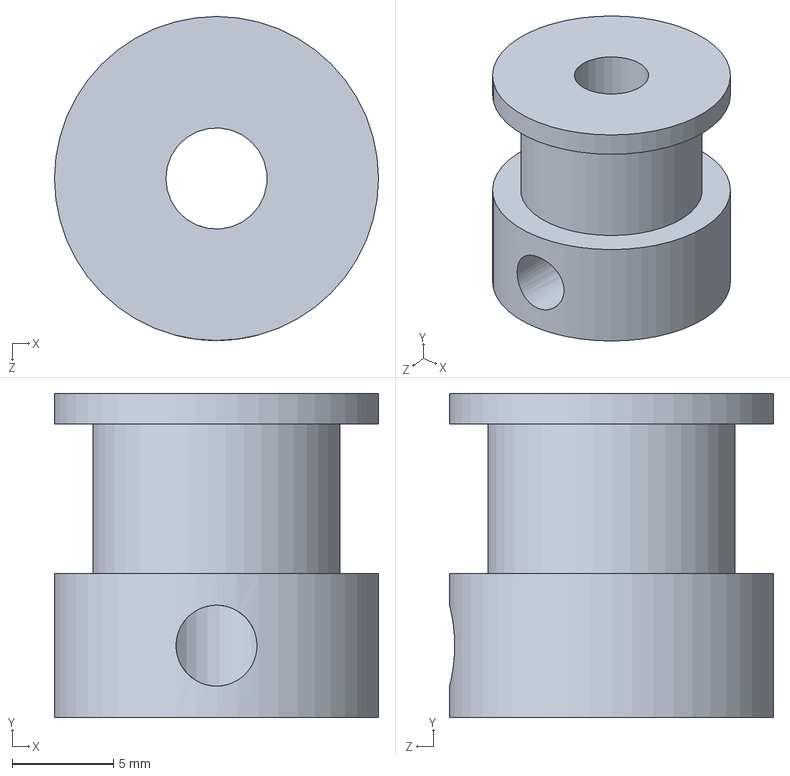
[picture p97: CAD file, 2024-02-22]
3D_slw/khau1/Khau1_puly_gt2_20rang_5mm.SLDPRT
16.0 x 16.0 x 16.0 mm
