AnhSinhVien/Thi-t-K-C-nh-Tay-robot-h-n-RRR/3D_slw/khau1/Khau1_day_dai_gt2_6mm_B.SLDPRT

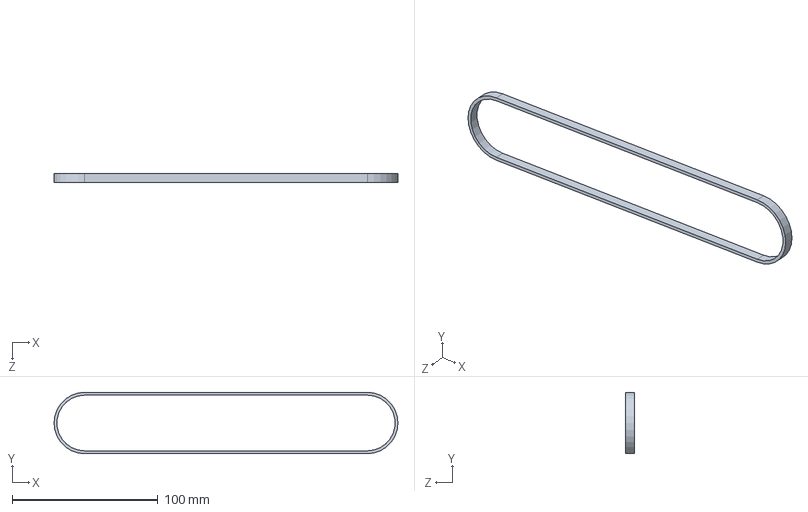
[picture p98: CAD file, 2024-02-22]
3D_slw/khau1/Khau1_day_dai_gt2_6mm_B.SLDPRT
236.2 x 42.2 x 6.00 mm
