AnhSinhVien/Thi-t-K-C-nh-Tay-robot-h-n-RRR/3D_slw/khau1/khau1_khoaTrucA.SLDPRT

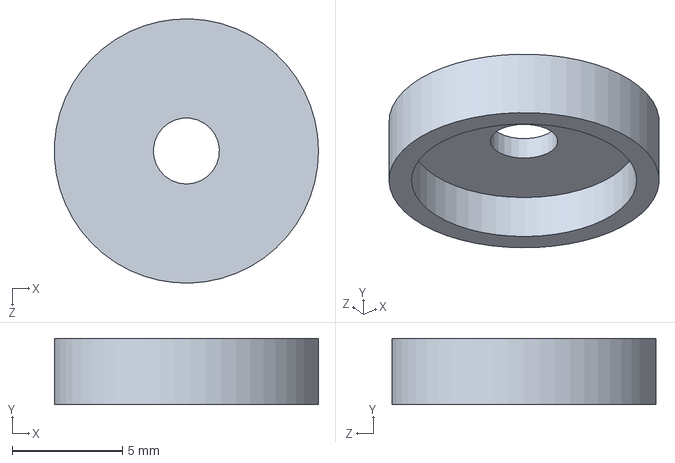
[picture p99: CAD file, 2024-02-22]
3D_slw/khau1/khau1_khoaTrucA.SLDPRT
12.0 x 3.00 x 12.0 mm
