AnhSinhVien/Thi-t-K-C-nh-Tay-robot-h-n-RRR/3D_slw/khau1/khau1_demngoai1.SLDPRT

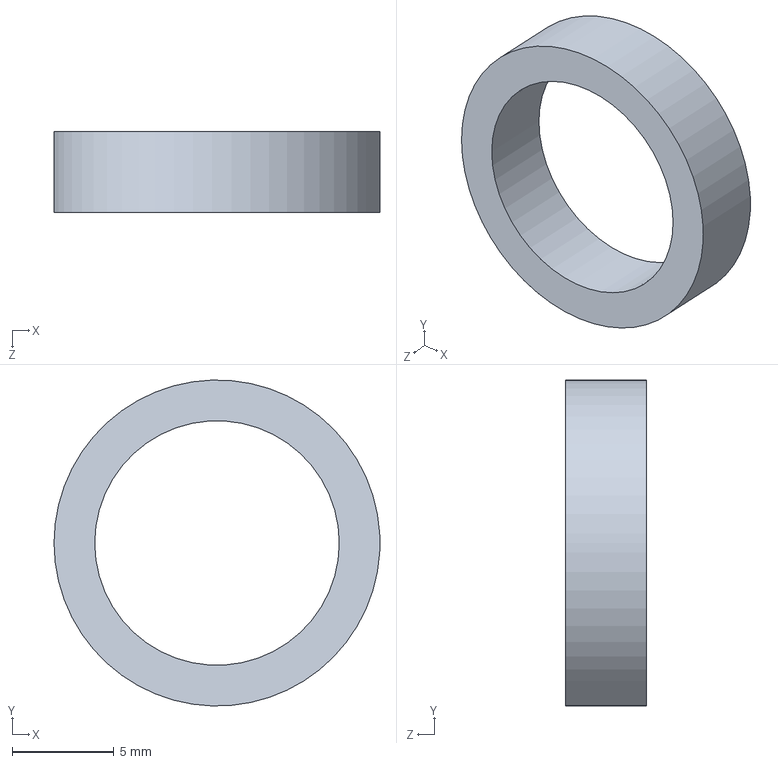
[picture p100: CAD file, 2024-02-22]
3D_slw/khau1/khau1_demngoai1.SLDPRT
16.0 x 16.0 x 4.00 mm
