AnhSinhVien/Thi-t-K-C-nh-Tay-robot-h-n-RRR/3D_slw/khau1/Khau1_vongchanNgoaiTrucTren.SLDPRT

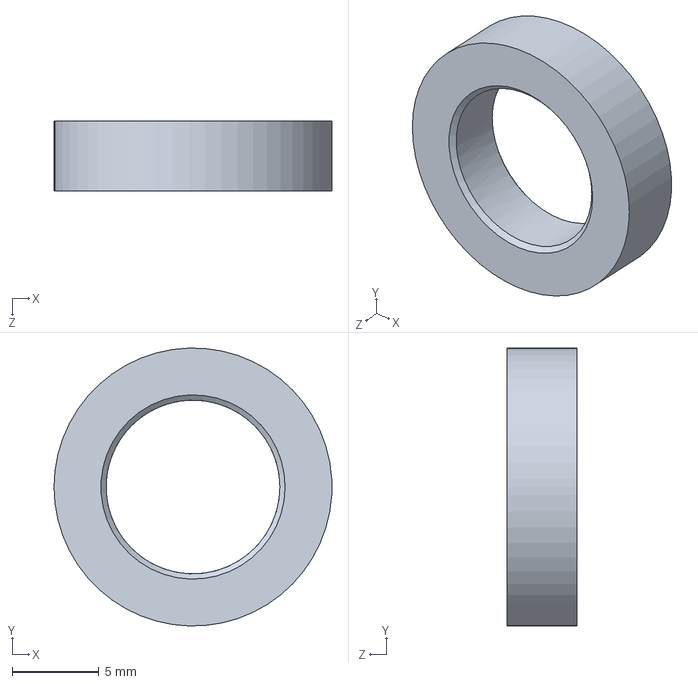
[picture p101: CAD file, 2024-02-22]
3D_slw/khau1/Khau1_vongchanNgoaiTrucTren.SLDPRT
16.0 x 16.0 x 4.00 mm
