AnhSinhVien/Thi-t-K-C-nh-Tay-robot-h-n-RRR/3D_slw/khau1/Khau1_vongChanTrucTren.SLDPRT

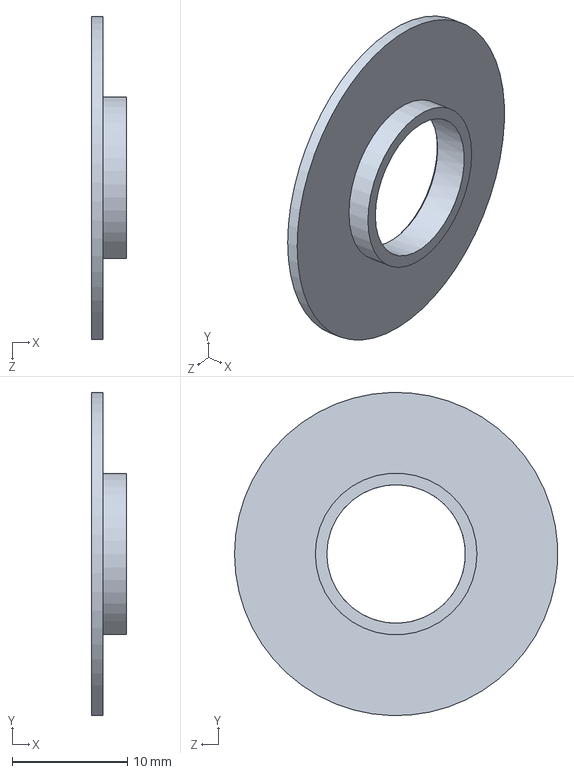
[picture p102: CAD file, 2024-02-22]
3D_slw/khau1/Khau1_vongChanTrucTren.SLDPRT
3.00 x 28.0 x 28.0 mm
