AnhSinhVien/Thi-t-K-C-nh-Tay-robot-h-n-RRR/(list of files, cad)

Other CAD files:
3D_slw/hop_the/2D/khop1/khop1.DWG
3D_slw/hop_the/2D/khop2/khop2.DWG
3D_slw/khau3_kieu2/15.STEP.SLDPRT
word/Part1.SLDPRT
3D_slw/khau3_kieu2/18.STEP.SLDPRT
3D_slw/khau3_kieu2/1.STEP.SLDPRT
3D_slw/khau3_kieu2/3.STEP.SLDPRT
3D_slw/khau3_kieu2/demThem2.SLDPRT
3D_slw/khau3_kieu2/14.STEP.SLDPRT
3D_slw/khau1/Khau1_1A.SLDPRT
3D_slw/khau3_kieu2/lock.STEP.SLDPRT
3D_slw/khau3_kieu2/lapmohan1p.SLDPRT
3D_slw/khau1/Khau1_puley_gt1_60teeth_double.SLDPRT
3D_slw/hop_the/2D/ChiTietTruc/TrucKhop2.SLDDRW
3D_slw/hop_the/2D/hopthe/hoptheDeVuong1.SLDDRW
3D_slw/hop_the/2D/hopthe/hoptheDeVuongMC.SLDDRW
3D_slw/hop_the/2D/khop3/khop3.SLDDRW
3D_slw/hop_the/2D/phongto/khop3/khop3.SLDDRW
3D_slw/hop_the/2D/tachKhau/Khau0/khau0.SLDDRW
3D_slw/hop_the/2D/tachKhau/Khau1/khau1.SLDDRW
3D_slw/hop_the/2D/tachKhau/Khau2/Khau2.SLDDRW
3D_slw/hop_the/2D/tachKhau/Khau3/khau3.SLDDRW
3D_slw/khau0/tsiny-gear-box-motor-1.snapshot.4/Amazon-gearmotor.SLDASM
3D_slw/khau0/tsiny-gear-box-motor-1.snapshot.4/M2-04-6-92000A013_18-8 SS METRIC PAN HEAD PHIL MACHINE SCREW.SLDPRT
3D_slw/khau3_kieu2/khau3.SLDPRT
3D_slw/khau3_kieu2/lapmohan1.SLDASM
