AnhSinhVien/Thi-t-K-C-nh-Tay-robot-h-n-RRR/3D_slw/hop_the/2D/khop3/khop3.pdf

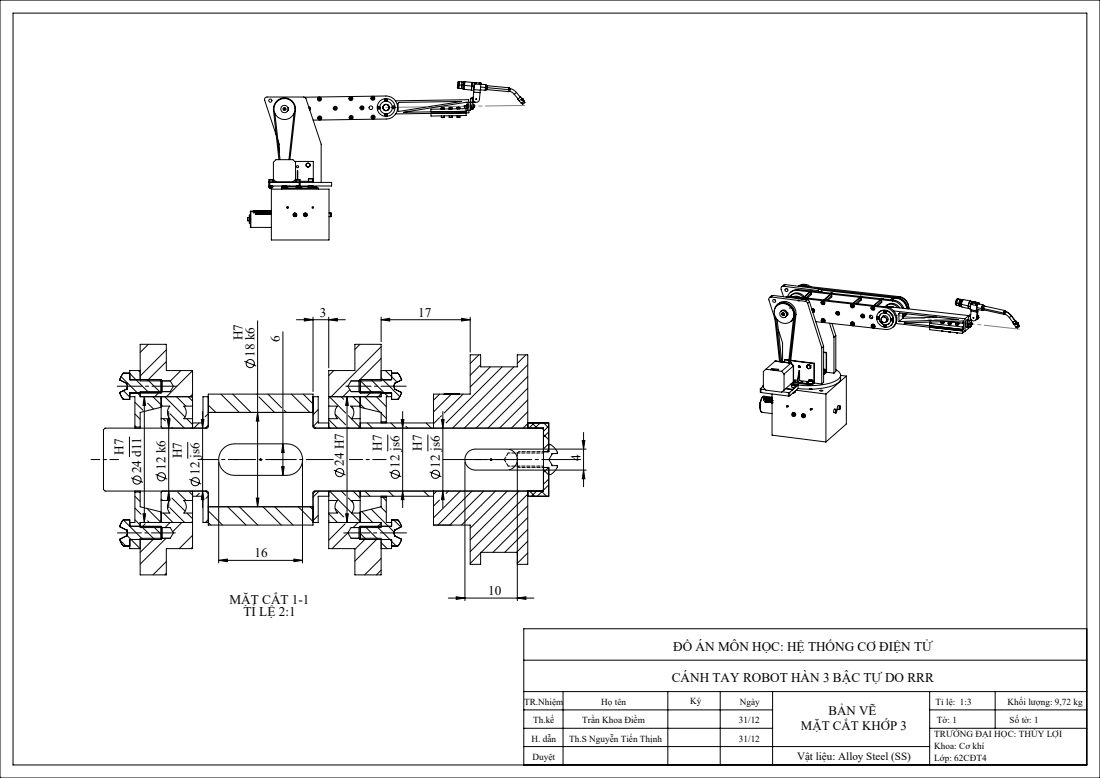
[picture p103: page 1]

MẶT CẮT 1-1 TỈ LỆ 2:1

ĐỒ ÁN MÔN HỌC: HỆ THỐNG CƠ ĐIỆN TỬ
CÁNH TAY ROBOT HÀN 3 BẬC TỰ DO RRR

TR.Nhiệm | Họ tên | Ký | Ngày | BẢN VẼ MẶT CẮT KHỚP 3 | Tỉ lệ: 1:3 | Khối lượng: 9,72 kg
Th.kế | Trần Khoa Điềm | | 31/12 | | Tờ: 1 | Số tờ: 1
H. dẫn | Th.S Nguyễn Tiến Thịnh | | 31/12 | | TRƯỜNG ĐẠI HỌC: THỦY LỢI Khoa: Cơ khí Lớp: 62CĐT4
Duyệt | | | | Vật liệu: Alloy Steel (SS)
