AnhSinhVien/Thi-t-K-C-nh-Tay-robot-h-n-RRR/word/in_ff/hoptheDeVuongMC.pdf

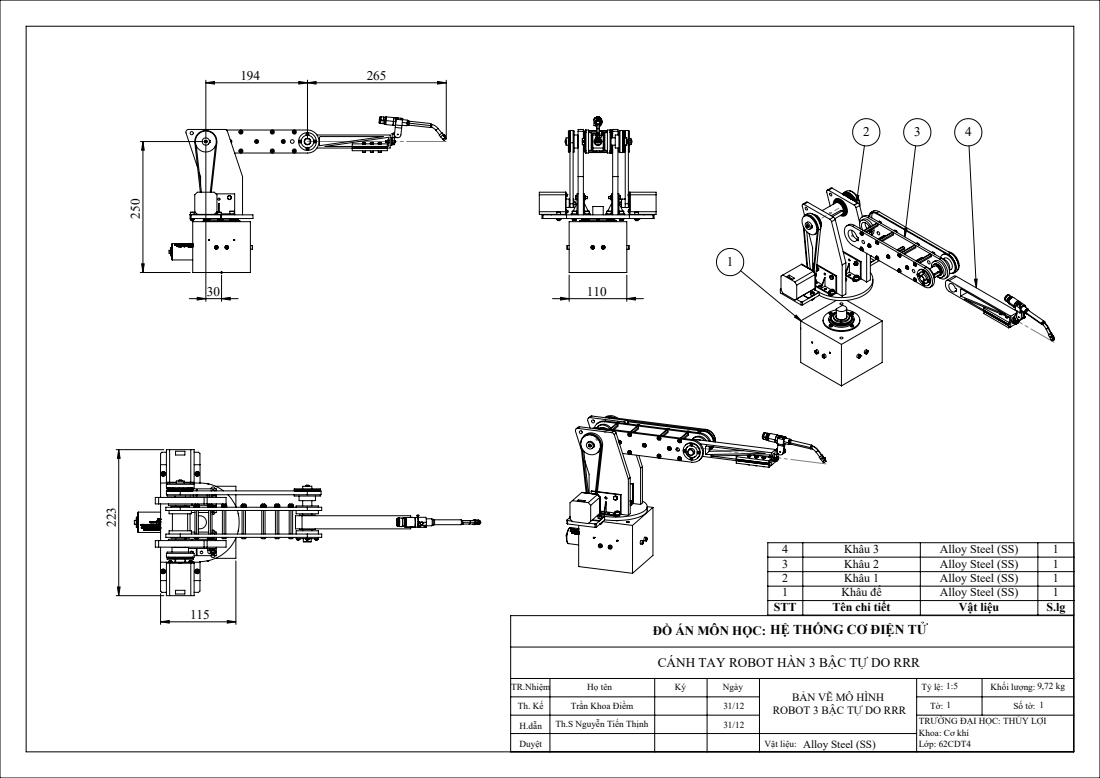
[picture p104: page 1]
Th.S Nguyễn Tiến Thịnh; Trần Khoa Điềm

4 | Khâu 3 | Alloy Steel (SS) | 1
3 | Khâu 2 | Alloy Steel (SS) | 1
2 | Khâu 1 | Alloy Steel (SS) | 1
1 | Khâu đế | Alloy Steel (SS) | 1
STT | Tên chi tiết | Vật liệu | S.lg

ĐỒ ÁN MÔN HỌC:
CÁNH TAY ROBOT HÀN 3 BẬC TỰ DO RRR

HỆ THỐNG CƠ ĐIỆN TỬ

TR.Nhiệm | Họ tên | Ký | Ngày | BẢN VẼ MÔ HÌNH ROBOT 3 BẬC TỰ DO RRR | Tỷ lệ: 1:5 | Khối lượng: 9,72 kg
Th. Kế | Trần Khoa Điềm | | | | Tờ: 1 | Số tờ: 1
H.dẫn | | | 31/12 | | TRƯỜNG ĐẠI HỌC: THỦY LỢI Khoa: Cơ khí Lớp: 62CDT4
Duyệt | | | | Vật liệu: Alloy Steel (SS)
