AnhSinhVien/Thi-t-K-C-nh-Tay-robot-h-n-RRR/word/in_ff/khop1.pdf

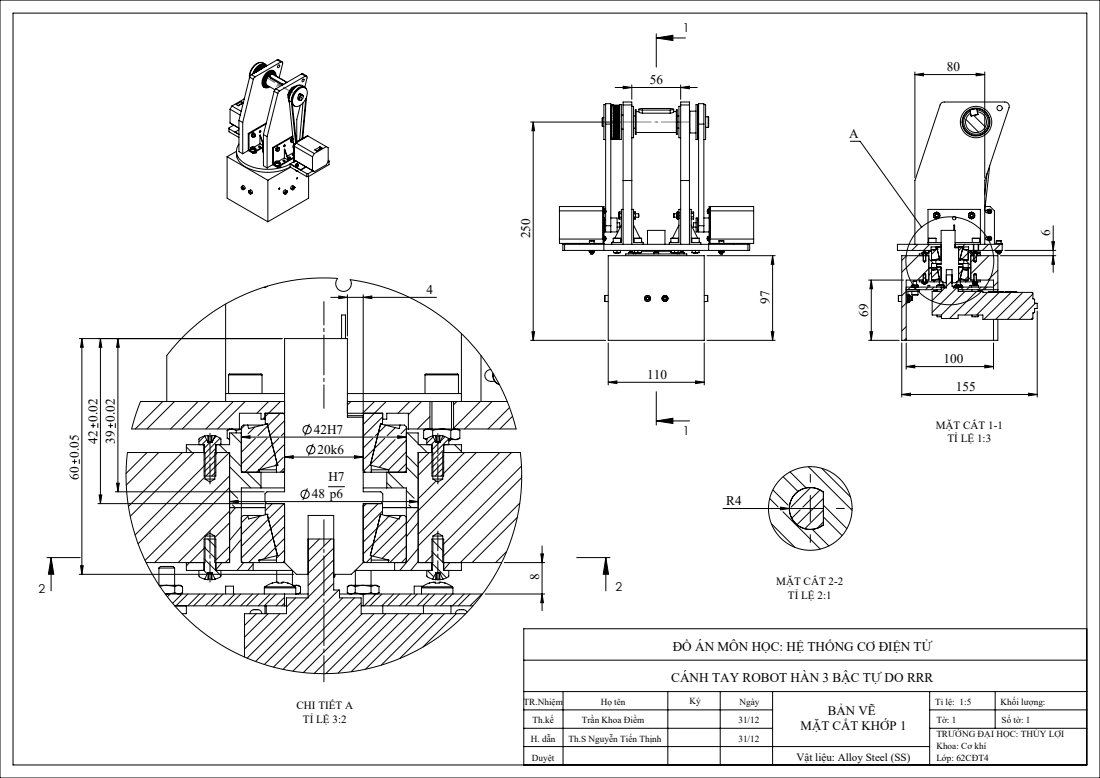
[picture p105: page 1]
MẶT CẮT 2-2 TỈ LỆ 2:1; CHI TIẾT A TỈ LỆ 3:2; MẶT CẮT 1-1 TỈ LỆ 1:3

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

TR.Nhiệm Th.kế | Họ tên | Ký | Ngày | BẢN VẼ MẶT CẮT KHỚP 1 | Tỉ lệ: 1:5 | Khối lượng:

Trần Khoa Điềm | | 31/12 | | Tờ: 1 | Số tờ: 1

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
