AnhSinhVien/Thi-t-K-C-nh-Tay-robot-h-n-RRR/word/in_ff/khop2.pdf

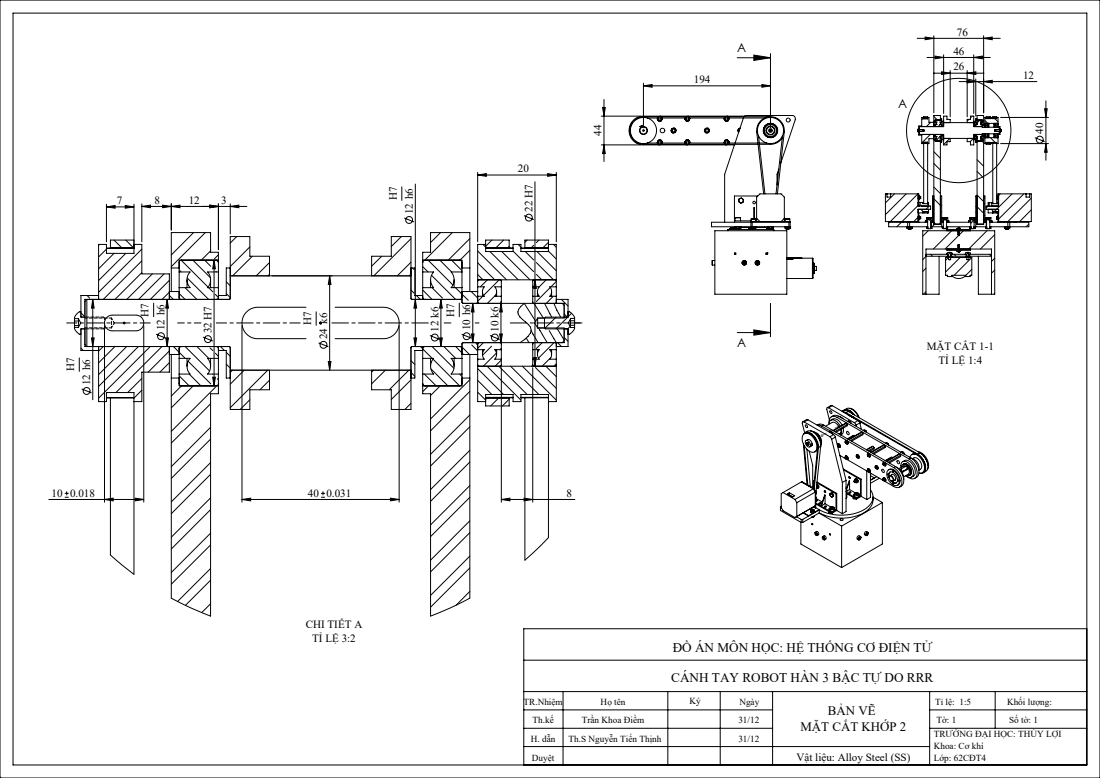
[picture p106: page 1]
MẶT CẮT 1-1 TỈ LỆ 1:4; CHI TIẾT A TỈ LỆ 3:2

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

TR.Nhiệm | Họ tên | Ký | Ngày | BẢN VẼ MẶT CẮT KHỚP 2 | Tỉ lệ: 1:5 | Khối lượng:
Th.kế | Trần Khoa Điềm | | 31/12 | | Tờ: 1 | Số tờ: 1
H. dẫn | Th.S Nguyễn Tiến Thịnh | | 31/12 | | TRƯỜNG ĐẠI HỌC: THỦY LỢI Khoa: Cơ khí Lớp: 62CĐT4
Duyệt | | | | Vật liệu: Alloy Steel (SS)
