AnhSinhVien/Thi-t-K-C-nh-Tay-robot-h-n-RRR/word/in_ff/TrucKhop2.pdf

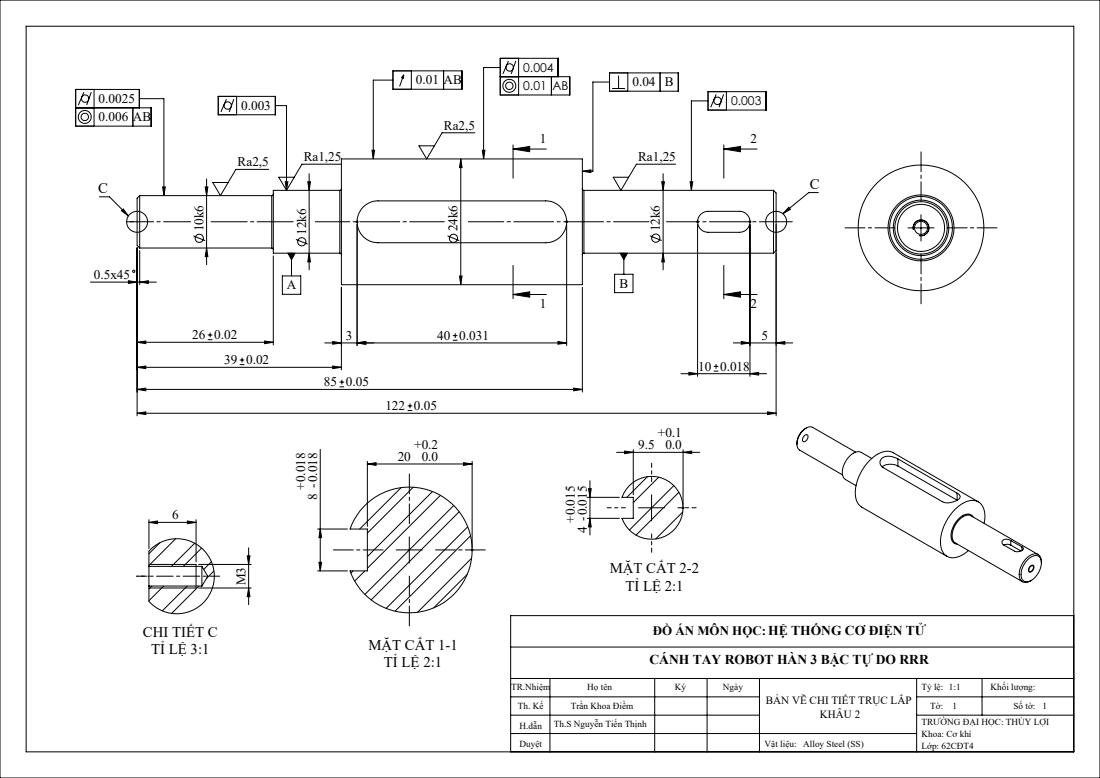
[picture p107: page 1]
CHI TIẾT C; MẶT CẮT 1-1; MẶT CẮT 2-2 TỈ LỆ 2:1

ĐỒ ÁN MÔN HỌC:
CÁNH TAY ROBOT HÀN 3 BẬC TỰ DO RRR

HỆ THỐNG CƠ ĐIỆN TỬ

TR.Nhiệm | Họ tên | Ký | Ngày | BẢN VẼ CHI TIẾT TRỤC LẮP KHÂU 2 | Tỷ lệ: 1:1 | Khối lượng:
Th. Kế | Trần Khoa Điềm | | | | Tờ: 1 | Số tờ: 1
H.dẫn | Th.S Nguyễn Tiến Thịnh | | | | TRƯỜNG ĐẠI HỌC: THỦY LỢI Khoa: Cơ khí Lớp: 62CĐT4
Duyệt | | | | Vật liệu: Alloy Steel (SS)
