AnhSinhVien/Thi-t-K-C-nh-Tay-robot-h-n-RRR/word/in_ff/khau/khau0.pdf

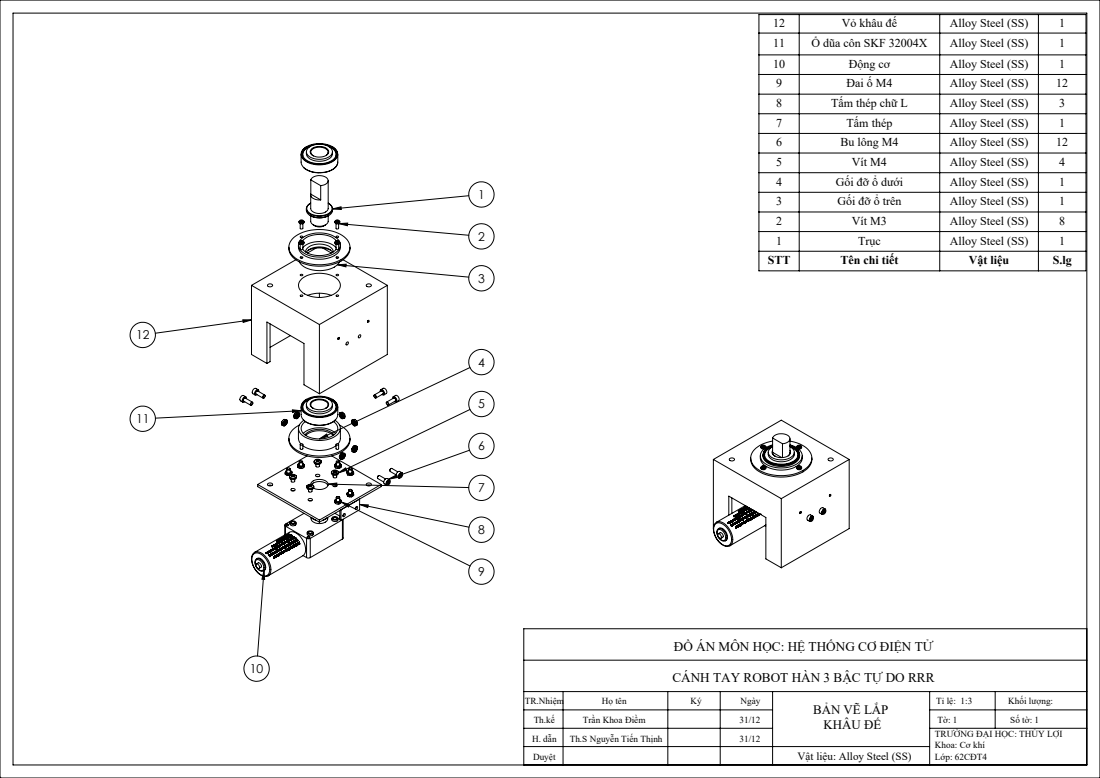
[picture p108: page 1]

12 | Vỏ khâu đế | Alloy Steel (SS) | 1
11 | Ổ dũa côn SKF 32004X | Alloy Steel (SS) | 1
10 | Động cơ | Alloy Steel (SS) | 1
9 | Đai ố M4 | Alloy Steel (SS) | 12
8 | Tấm thép chữ L | Alloy Steel (SS) | 3
7 | Tấm thép | Alloy Steel (SS) | 1
6 | Bu lông M4 | Alloy Steel (SS) | 12
5 | Vít M4 | Alloy Steel (SS) | 4
4 | Gối đỡ ổ dưới | Alloy Steel (SS) | 1
3 | Gối đỡ ổ trên | Alloy Steel (SS) | 1
2 | Vít M3 | Alloy Steel (SS) | 8
1 | Trục | Alloy Steel (SS) | 1
STT | Tên chi tiết | Vật liệu | S.lg

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

TR.Nhiệm | Họ tên | Ký | Ngày | BẢN VẼ LẮP KHÂU ĐẾ | Tỉ lệ: 1:3 | Khối lượng:
Th.kế | Trần Khoa Điềm | | 31/12 | | Tờ: 1 | Số tờ: 1
H. dẫn | Th.S Nguyễn Tiến Thịnh | | 31/12 | | TRƯỜNG ĐẠI HỌC: THỦY LỢI Khoa: Cơ khí Lớp: 62CĐT4
Duyệt | | | | Vật liệu: Alloy Steel (SS)
