AnhSinhVien/Thi-t-K-C-nh-Tay-robot-h-n-RRR/word/in_ff/khau/khau3.pdf

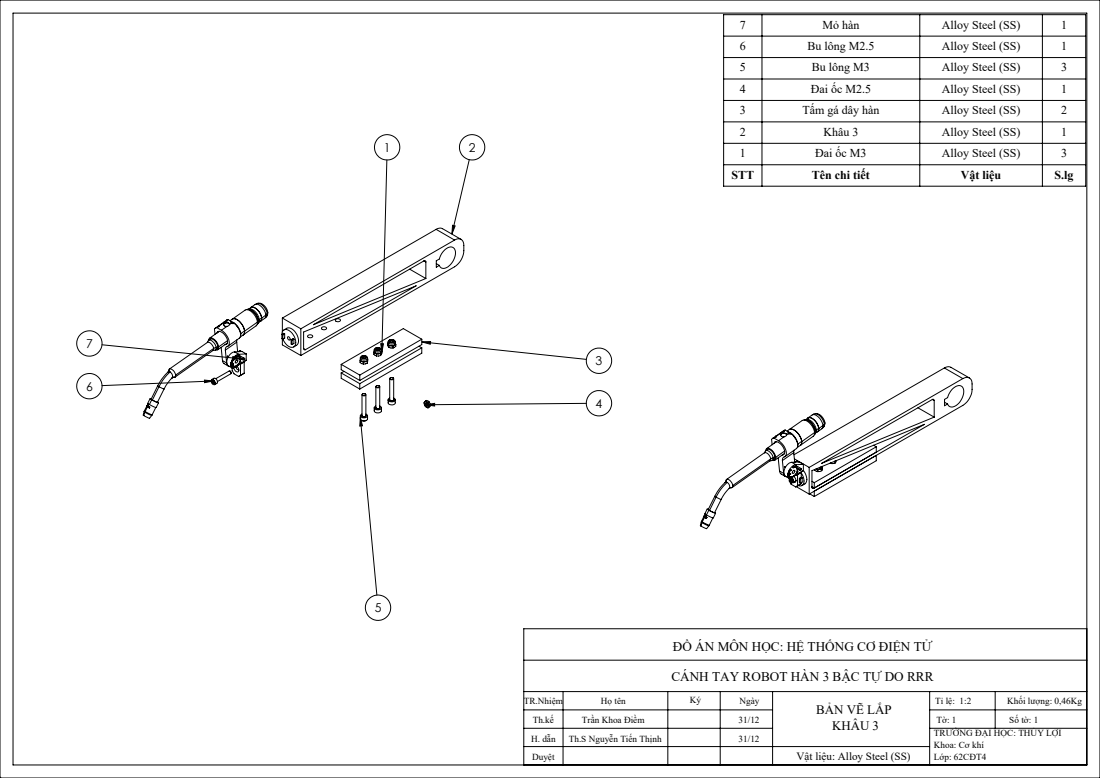
[picture p111: page 1]

7 | Mỏ hàn | Alloy Steel (SS) | 1
6 | Bu lông M2.5 | Alloy Steel (SS) | 1
5 | Bu lông M3 | Alloy Steel (SS) | 3
4 | Đai ốc M2.5 | Alloy Steel (SS) | 1
3 | Tấm gá dây hàn | Alloy Steel (SS) | 2
2 | Khâu 3 | Alloy Steel (SS) | 1
1 | Đai ốc M3 | Alloy Steel (SS) | 3
STT | Tên chi tiết | Vật liệu | S.lg

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

TR.Nhiệm | Họ tên | Ký | Ngày | BẢN VẼ LẮP KHÂU 3 | Tỉ lệ: 1:2 | Khối lượng: 0,46Kg
Th.kế | Trần Khoa Điềm | | 31/12 | | Tờ: 1 | Số tờ: 1
H. dẫn | Th.S Nguyễn Tiến Thịnh | | 31/12 | | TRƯỜNG ĐẠI HỌC: THỦY LỢI Khoa: Cơ khí Lớp: 62CĐT4
Duyệt | | | | Vật liệu: Alloy Steel (SS)
