AnhSinhVien/Thi-t-K-C-nh-Tay-robot-h-n-RRR/3D_slw/hop_the/2D/ChiTietTruc/TrucKhop2.pdf

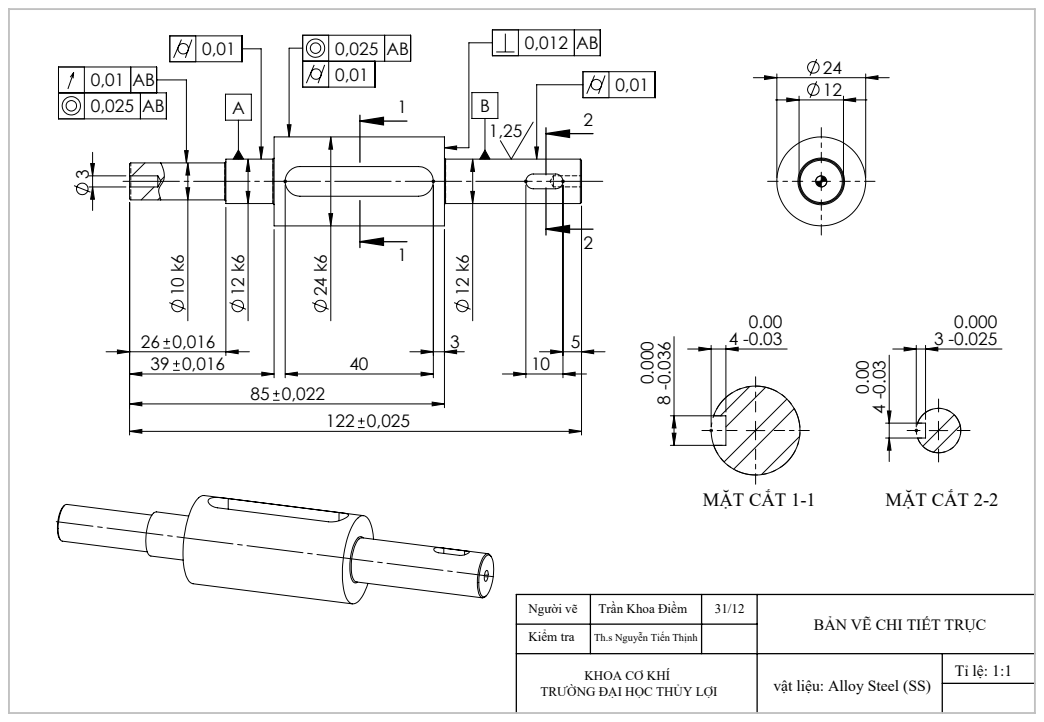
[picture p112: page 1]
MẶT CẮT 1-1; MẶT CẮT 2-2

Người vẽ | Trần Khoa Điềm | 31/12 | BẢN VẼ CHI TIẾT TRỤC
Kiểm tra | Th.s Nguyễn Tiến Thịnh
KHOA CƠ KHÍ TRƯỜNG ĐẠI HỌC THỦY LỢI | vật liệu: Alloy Steel (SS) | Tỉ lệ: 1:1
