AnhSinhVien/Thi-t-K-C-nh-Tay-robot-h-n-RRR/3D_slw/hop_the/2D/hopthe/hoptheDeVuong1.pdf

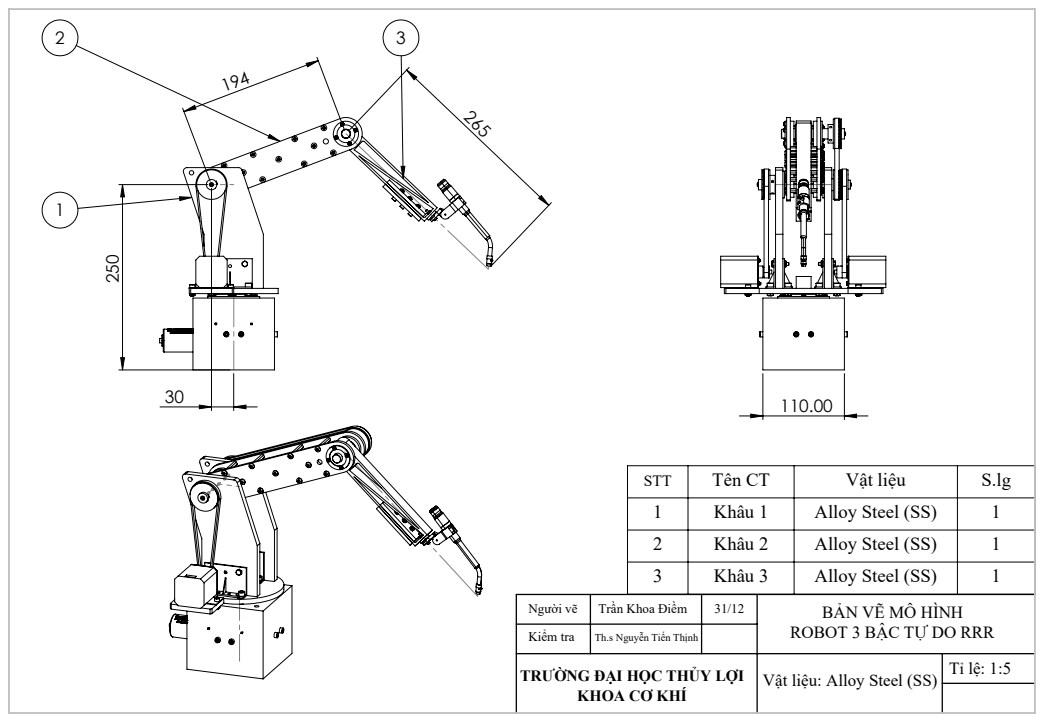
[picture p113: page 1]

STT | Tên CT | Vật liệu | S.lg
1 | Khâu 1 | Alloy Steel (SS) | 1
2 | Khâu 2 | Alloy Steel (SS) | 1
3 | Khâu 3 | Alloy Steel (SS) | 1

Người vẽ | Trần Khoa Điềm | 31/12 | BẢN VẼ MÔ HÌNH ROBOT 3 BẬC TỰ DO RRR
Kiểm tra | Th.s Nguyễn Tiến Thịnh
TRƯỜNG ĐẠI HỌC THỦY LỢI KHOA CƠ KHÍ | Vật liệu: Alloy Steel (SS) | Tỉ lệ: 1:5
