AnhSinhVien/Thi-t-K-C-nh-Tay-robot-h-n-RRR/3D_slw/hop_the/2D/khop1/khop1.pdf

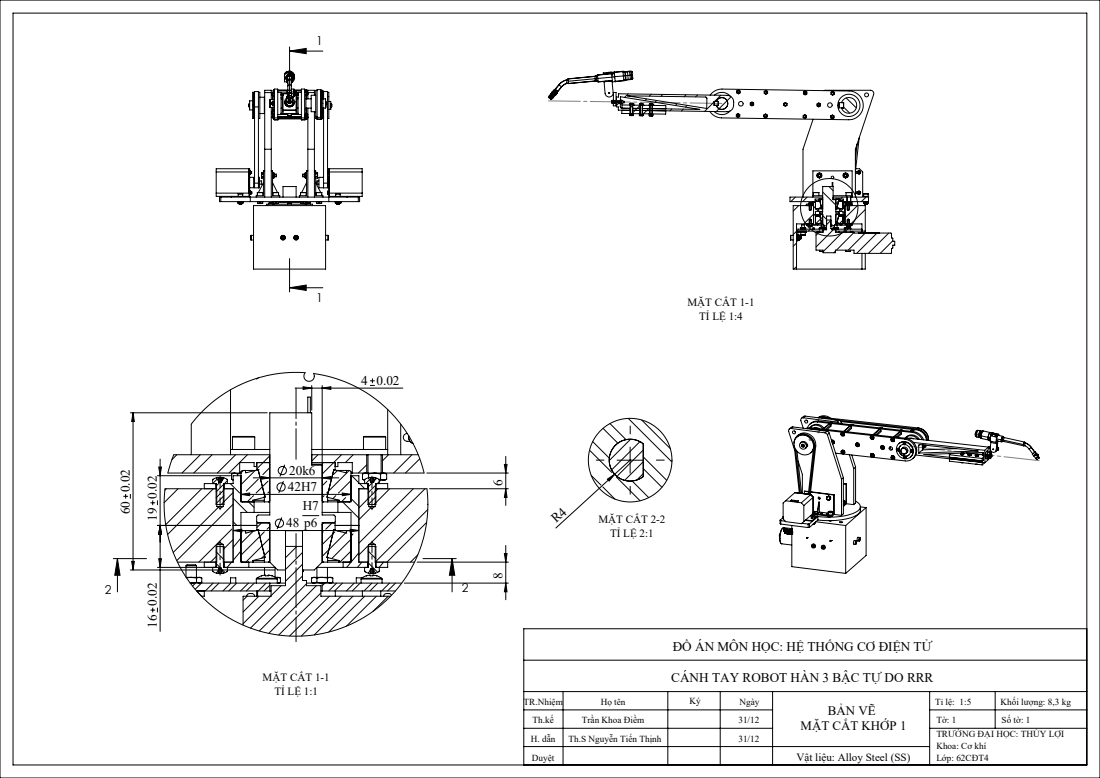
[picture p114: page 1]
MẶT CẮT 2-2 TỈ LỆ 2:1; MẶT CẮT 1-1 TỈ LỆ 1:1; MẶT CẮT 1-1 TỈ LỆ 1:4

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

TR.Nhiệm Th.kế | Họ tên | Ký | Ngày | BẢN VẼ MẶT CẮT KHỚP 1 | Tỉ lệ: 1:5 | Khối lượng: 8,3 kg

Trần Khoa Điềm | | 31/12 | | Tờ: 1 | Số tờ: 1

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
